wyolum/ClockTHREEjr/KiCAD/C3Jr_v2/c3jr_v2_BoM.pdf

BoM, for kit building assembly

ref | value | Vendor | Vendor P/N | NOTE1 | NOTE 2
BT1 | BATT_RTC | | 3003K-ND | | Battery Socket
* | 3V CR2032 Battery | | P189-ND | | LR2032 Coin Battery
C1,C2,C8 | 100u | | P833-ND | | Capacitor Voltage Rating >= 16V
C3,C4,C5,C6,C7,C9,C10 | 100n | | 399-5863-ND | | Decoupling capacitor
D1 to D128 | LED | | C535A-WJN-CU0V0231-ND | | CREE LED 5mm Cool White Clear 110deg
D258 | DBG | | 1080-1134-ND | | Debug LED, 3mm or 5mm LED, any Color
D260 | PWR | | 1080-1134-ND | | Power On LED, 3mm or 5mm LED, any Color
J1 | V_IN | | H2960CT-ND | | USB-Mini Socket
K1 | PWR | | SAM1031-50-ND | | Header, Male, 3 pin, for PWR_SEL
* | | | S9341-ND | | Jumper socket for PWR_SEL K1
K2 | LED_ENABLE | | SAM1031-50-ND | | Header, Male, 3 pin, for LED_ENABLE
* | | | S9341-ND | | Jumper socket for LED_ENABLE K2
K4 | SCL | | SAM1031-50-ND | | Header, Male, 2 pin, Link for INT, OPEN for EXT
* | | | S9341-ND | | Jumper socket for SCL, K4
K5 | SDA | | SAM1031-50-ND | | Header, Male, 2 pin, Link for INT, OPEN for EXT
* | | | S9341-ND | | Jumper socket for SDL, K5
P7 | FTDI | | SAM1031-50-ND | | Header, Male, 6 pin, for FTDI
Q1 to Q17 | 2N5401 | | 2N5401GOS-ND | | Transistor, TO-92-3
R1 to R16 | 100 | | CF18JT100RCT-ND | | Resistor, 1/8W, 5%
R17,R18,R19,R22,R23,R31,R36,R37,R38 10k | CF18JT10K0CT-ND | Resistor, 1/8W, 5%
R20,R21 | 4k7 | | CF18JT4K70CT-ND | | Resistor, 1/8W, 5%
R24,R25,R26 | 1k | | CF18JT1K00CT-ND | | Resistor, 1/8W, 5%
R30 | 100E | | CF18JT100RCT-ND | | Resistor, 1/8W, 5%
R32 | LDR SOCKET | | A32932-ND | | Socket header, 2 pin, for LDR
-- | LDR | | PDV-P9007-ND | | LDR, 10k to 100k
R33,R35 | 680E | | CF18JT680RCT-ND | | Resistor, 1/8W, 5%
R34 | 2k | | 3352T-202LF-ND | | Pot, Thumbwheel, Ceramic,
SP1 | SPEAKER | | 102-1169-ND | | Audio Buzzer
SW12,SW22,SW32,SW52 | INC | | 450-1647-ND | | Push button switch, Long Button
SW42 | RST | | 450-1649-ND | | Push button switch, Short Button
U1 | STP8DP05 | | 497-6271-5-ND | | IC, Row Driver
* | Socket STP8DP05 | | A100206-ND | | Socket for IC U1
U2 | 7805 | -- | -- | | SHORTING LINK between VI and VO
U3 | ATMEGA8-P | | ATMEGA328-PU-ND | | Micro Controller
* | IC ATMEGA8-P | | A100210-ND | | Socket for IC U3
U4 | 74HC154 | | 568-1407-5-ND | | IC, Column Driver
* | IC 74HC154 | | 3M5479-ND | | Socket for IC U4

DigiKey (http://search.digikey.com/scripts/DkSearch/dksus.dll?x=0&y=0&lang=en&site=us&KeyWords=3003K-ND)
DigiKey (http://search.digikey.com/us/en/products/CR2032/P189-ND/31939)
DigiKey (http://search.digikey.com/us/en/products/ECE-A1CKA101/P833-ND/44757)
DigiKey (http://search.digikey.com/us/en/products/R82DC3100AA50J/399-5863-ND/2571298)
DigiKey (http://search.digikey.com/scripts/DkSearch/dksus.dll?WT.z_header=search_go&lang=en&site=us&x=0&y=0)
DigiKey
DigiKey (http://search.digikey.com/us/en/products/MV8112/1080-1134-ND/2675625)
DigiKey (http://search.digikey.com/us/en/products/UX60-MB-5S8/H2960CT-ND/597539)
DigiKey (http://search.digikey.com/us/en/products/TSW-150-07-L-S/SAM1031-50-ND/1101377)
DigiKey (http://search.digikey.com/us/en/products/NPC02SXON-RC/S9341-ND/2618266)
DigiKey (http://search.digikey.com/us/en/products/TSW-150-07-L-S/SAM1031-50-ND/1101377)
DigiKey (http://search.digikey.com/us/en/products/NPC02SXON-RC/S9341-ND/2618266)
DigiKey (http://search.digikey.com/us/en/products/TSW-150-07-L-S/SAM1031-50-ND/1101377)
DigiKey (http://search.digikey.com/us/en/products/NPC02SXON-RC/S9341-ND/2618266)
DigiKey (http://search.digikey.com/us/en/products/TSW-150-07-L-S/SAM1031-50-ND/1101377)
DigiKey (http://search.digikey.com/us/en/products/NPC02SXON-RC/S9341-ND/2618266)
DigiKey (http://search.digikey.com/us/en/products/TSW-150-07-L-S/SAM1031-50-ND/1101377)
DigiKey (http://search.digikey.com/us/en/products/2N5401G/2N5401GOS-ND/1475210)
DigiKey (http://search.digikey.com/us/en/products/CF18JT100R/CF18JT100RCT-ND/2022718)
DigiKey (http://search.digikey.com/us/en/products/CF18JT10K0/CF18JT10K0CT-ND/2022766)
DigiKey (http://search.digikey.com/us/en/products/CF18JT4K70/CF18JT4K70CT-ND/2022758)
DigiKey (http://search.digikey.com/us/en/products/CF18JT1K00/CF18JT1K00CT-ND/2022742)
DigiKey (http://search.digikey.com/us/en/products/CF18JT100R/CF18JT100RCT-ND/2022718)
DigiKey (http://search.digikey.com/us/en/products/5-534206-1/A32932-ND/1093003)
DigiKey (http://search.digikey.com/us/en/products/PDV-P9007/PDV-P9007-ND/480624)
DigiKey (http://search.digikey.com/us/en/products/CF18JT680R/CF18JT680RCT-ND/2022738)
DigiKey (http://search.digikey.com/us/en/products/3352T-1-202LF/3352T-202LF-ND/1088345)
DigiKey (http://search.digikey.com/scripts/dksearch/dksus.dll?vendor=0&keywords=102-1169-ND)
DigiKey (http://search.digikey.com/scripts/DkSearch/dksus.dll?x=23&y=19&lang=en&site=us&KeyWords=450-1647-ND)
DigiKey (http://search.digikey.com/us/en/products/FSM2JH/450-1649-ND/1632535)
DigiKey (http://search.digikey.com/us/en/products/STP08DP05B1/497-6271-5-ND/1641765)
DigiKey (http://search.digikey.com/us/en/products/1-390261-4/A100206-ND/1125624)

DigiKey (http://search.digikey.com/us/en/products/ATMEGA328-PU/ATMEGA328-PU-ND/2271026)
DigiKey (http://search.digikey.com/us/en/products/1-390261-9/A100210-ND/990628)
DigiKey (http://search.digikey.com/us/en/products/74HC154N,652/568-1407-5-ND/763011)
DigiKey (http://search.digikey.com/us/en/products/4824-6004-CP/3M5479-ND/1133632)

BoM, for kit building assembly

ref | value | Vendor | Vendor P/N | NOTE1 | NOTE 2
U6 | DS3231N | | DS3231S#-ND | | IC, RTC
X1 | 16MHz | | X908-ND | | Resonator, with capacitors, 3 pin

NOT USED COMPONENTS
C11,C12 | 22p | BC1034CT-ND | Optional if using crystal instead of resonator
CD1,CD2,CD3 | CDOT1 | 3M9515-ND | Optional if using I2SD, rtcBoB or ChronoDot, Socket, 4 pin
DIL-U1 | STP16DP05 | 3M5479-ND | Optional if using rowBoB, 24 pin IC socket
J2 | V_IN | ED2982-ND | Optional USB-B, Socket
J3 | V_IN | CP-002B-ND | Optional Barrel socket
K3 | 7Seg_Sel | -- | -- | Optional Solder Bridge for uC pin selection
P1 | 7SegDisp | COM-09766 | Optional 7 segment 4 digit display
P13 | ISP | SAM1095-36-ND | Optional Header, 3x2 pin
P41 | STACK-L | SAM1009-50-ND | Optional Socket, 4 pin, right angle, for daisy-chaining boards
P42 | STACK-R | SAM1043-50-ND | Optional Header, 4 pin, right angle, for daisy-chaining boards
P43 | CONN_1 | -- | Break Out Pad, no component | Optional ATMega Port PC2
SW1,SW2,SW3,SW4,SW5 | INC | 450-1657-ND | Optional Right Angle switch, for Top access
U2 | 7805 | MC7805CTGOS-ND | Optional ONLY if V_IN > 5V. ELSE USE SHORTING LINK

MISC. COMPONENTS
BF1 | BAFFLE | | | | Angus Hines
BP1 | BackPlate | | | | Angus Hines
FM1 | FRAME | | | | Ikea or None
FP1 | FacePlate | | | | Angus Hines
P8,P9,P10,P11 | CONN_1 | | P/N 92855A313 | | Fixing Screw for Board
P14,P15,P53,P54 | CONN_1 | | P/N 92855A313 | | Fixing Screw for Baffle
P49,P40,P51,P52 | CONN_1 | | | | Fixing Screw for rtcBoB
rowBoB1 | CONN_1 | | | | Fixing Screw for rowBoB
P24 to P39 | DIL6 | | | | Prototyping area
PCB1 | PCB | | | | Main Board, seeed
Nuts, M3 | -- | | P/N 91828A211
StandOff's/Spacers, 20mm x M3 | -- | Local | | | (from Anool)

DigiKey (http://search.digikey.com/us/en/products/DS3231S/DS3231S#-ND/1197574)
DigiKey (http://search.digikey.com/us/en/products/ZTT-16.00MX/X908-ND/170095)

DigiKey (http://search.digikey.com/us/en/products/K220J15C0GF5TH5/BC1034CT-ND/286656)
DigiKey (http://search.digikey.com/us/en/products/960104-6202-AR/3M9515-ND/2071556)
DigiKey (http://search.digikey.com/us/en/products/4824-6004-CP/3M5479-ND/1133632)
DigiKey (http://search.digikey.com/us/en/products/USB-B1HSW6/ED2982-ND/2677743)
DigiKey (http://search.digikey.com/us/en/products/PJ-002B/CP-002B-ND/96965)

Sparkfun (http://www.sparkfun.com/products/9766)
DigiKey (http://search.digikey.com/us/en/products/TLW-136-05-T-D/SAM1095-36-ND/1104872)
DigiKey (http://search.digikey.com/us/en/products/BCS-150-L-S-HE/SAM1009-50-ND/1100271)
DigiKey (http://search.digikey.com/us/en/products/TSW-150-08-L-S-RA/SAM1043-50-ND/1101974)

DigiKey (http://search.digikey.com/us/en/products/FSMRA3JH/450-1657-ND/1632543)
DigiKey (http://search.digikey.com/us/en/products/MC7805CTG/MC7805CTGOS-ND/919333)

McMaster
McMaster (http://www.mcmaster.com/#92855A313)

McMaster (http://www.mcmaster.com/#91828A211)
