wyolum/ClockTHREEjr/KiCAD/C3Jr_v2/C3Jr_v2_images/c3jr_mod.pdf

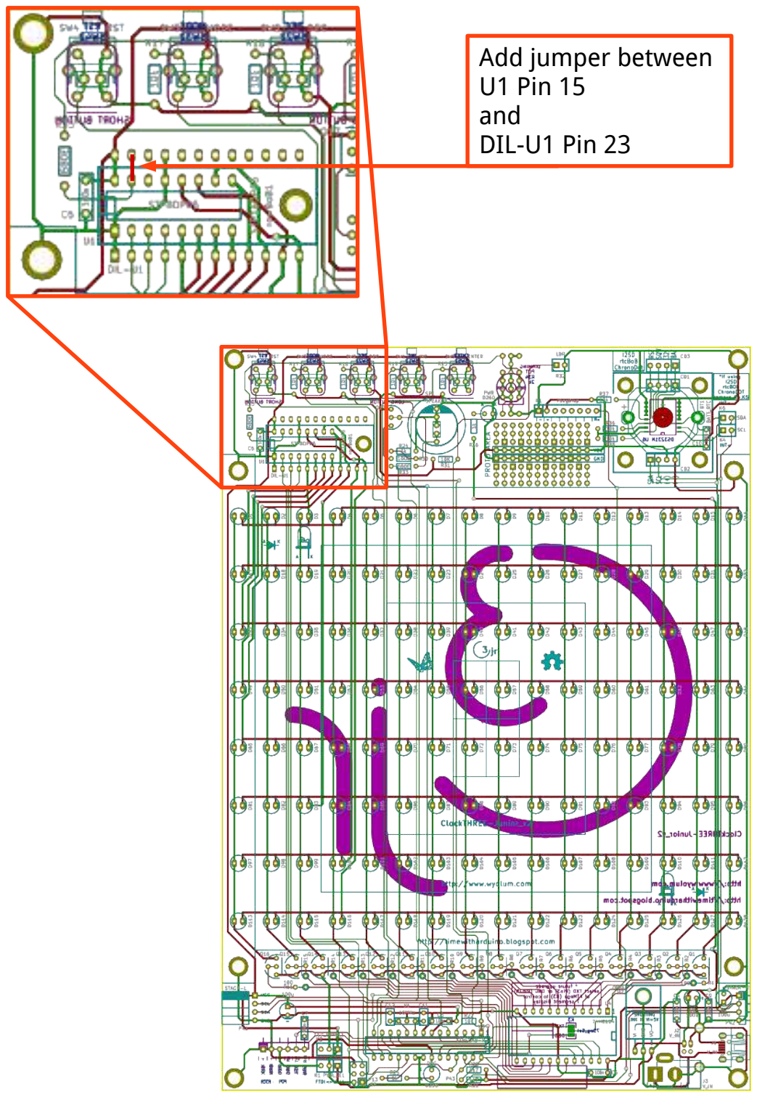
[picture p3: page 1]

Add jumper between
U1 Pin 15
and
DIL-U1 Pin 23
