wyolum/ClockTHREEjr/KiCAD/C3Jr_v2/C3Jr_v2_Data/c3jr_v2_LED.png

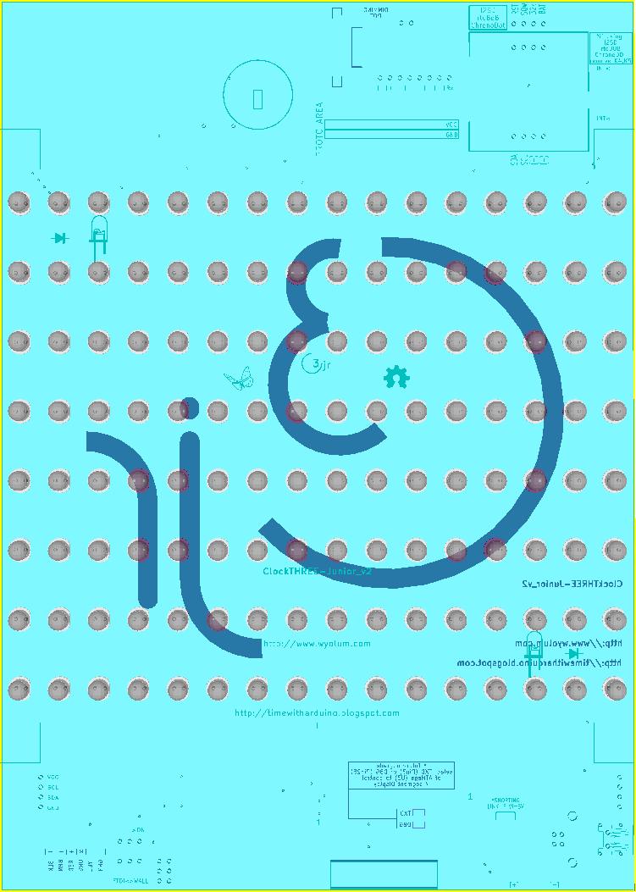
KiCAD/C3Jr_v2/C3Jr_v2_Data/c3jr_v2_LED.png
