wyolum/ClockTHREEjr/KiCAD/C3Jr_v2/C3Jr_v2_Data/C3jr_v2_Mech03.jpg

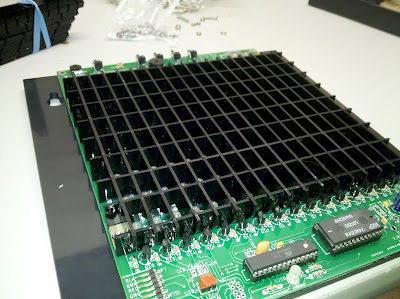
KiCAD/C3Jr_v2/C3Jr_v2_Data/C3jr_v2_Mech03.jpg
