wyolum/ClockTHREEjr/KiCAD/C3Jr_v2/C3Jr_v2_Data/Part-Dim_Pot.jpg

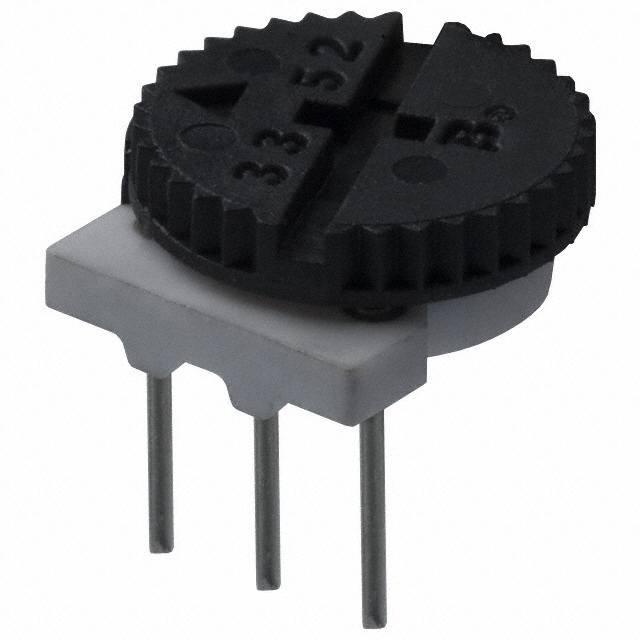
KiCAD/C3Jr_v2/C3Jr_v2_Data/Part-Dim_Pot.jpg
