wyolum/ClockTHREEjr/KiCAD/C3Jr_v2/C3Jr_v2_Data/Part-El_Cap_Radial.png

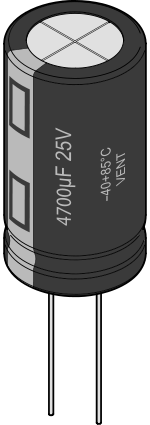
KiCAD/C3Jr_v2/C3Jr_v2_Data/Part-El_Cap_Radial.png
