wyolum/ClockTHREEjr/KiCAD/C3Jr_v2/C3Jr_v2_Data/Part-header_2_m.jpg

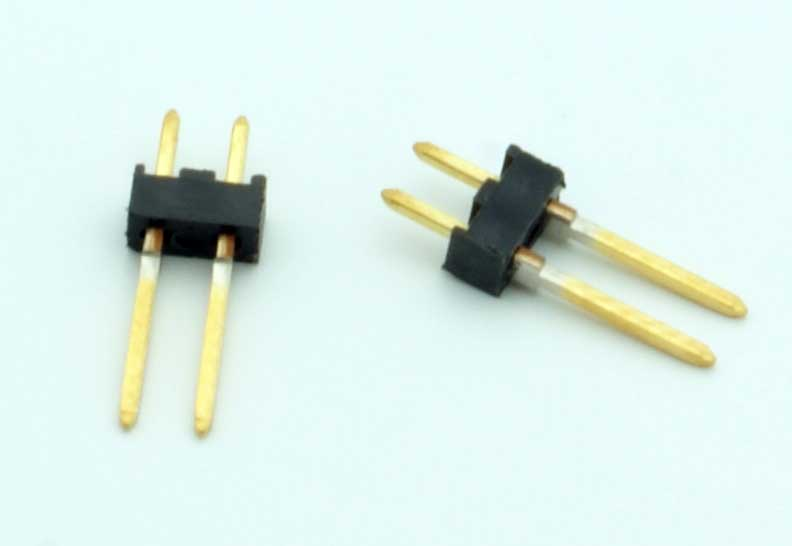
KiCAD/C3Jr_v2/C3Jr_v2_Data/Part-header_2_m.jpg
