wyolum/ClockTHREEjr/KiCAD/C3Jr_v2/C3Jr_v2_Data/Part-header_3x2_m.jpg

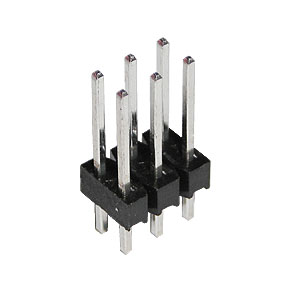
KiCAD/C3Jr_v2/C3Jr_v2_Data/Part-header_3x2_m.jpg
