wyolum/ClockTHREEjr/KiCAD/C3Jr_v2/C3Jr_v2_Data/Part-IC_74HC125.jpg

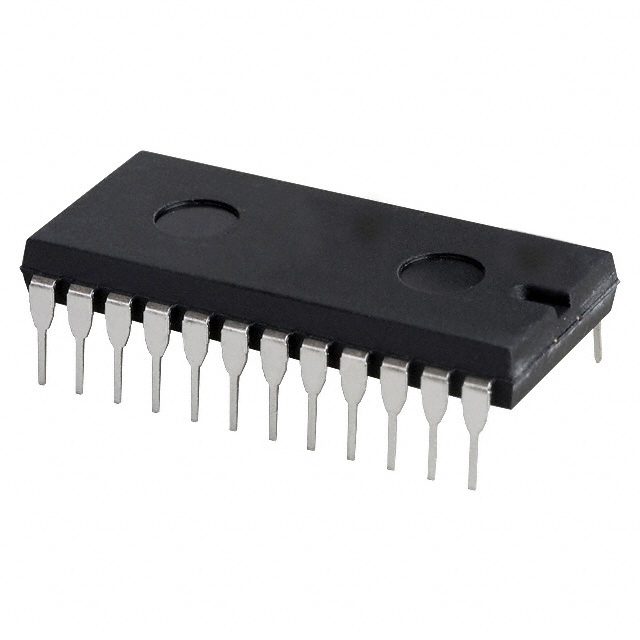
KiCAD/C3Jr_v2/C3Jr_v2_Data/Part-IC_74HC125.jpg
