wyolum/ClockTHREEjr/KiCAD/C3Jr_v2/C3Jr_v2_Data/Part-IC_Socket_16x300.jpg

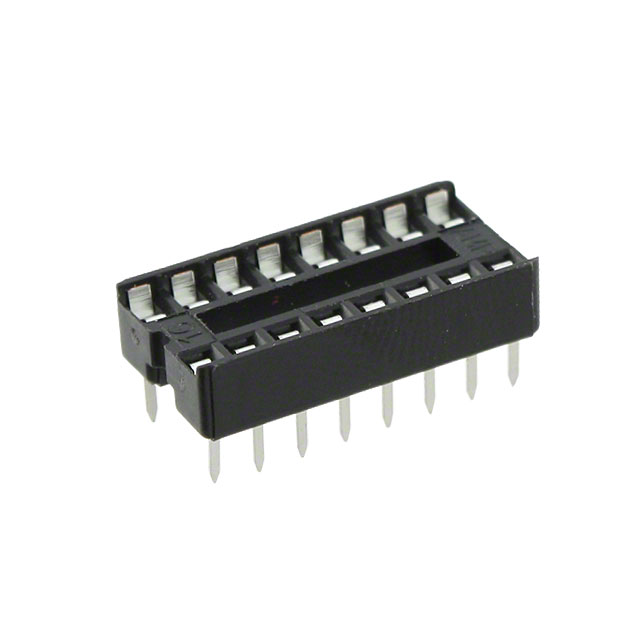
KiCAD/C3Jr_v2/C3Jr_v2_Data/Part-IC_Socket_16x300.jpg
