wyolum/ClockTHREEjr/KiCAD/C3Jr_v2/C3Jr_v2_Data/Part-IC_Socket_24x600.jpg

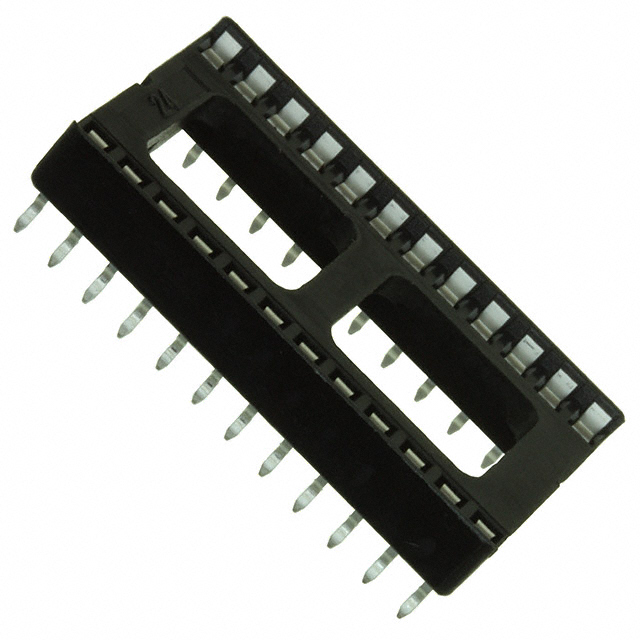
KiCAD/C3Jr_v2/C3Jr_v2_Data/Part-IC_Socket_24x600.jpg
