wyolum/ClockTHREEjr/KiCAD/C3Jr_v2/C3Jr_v2_Data/Part-IC_STP6DP05.jpg

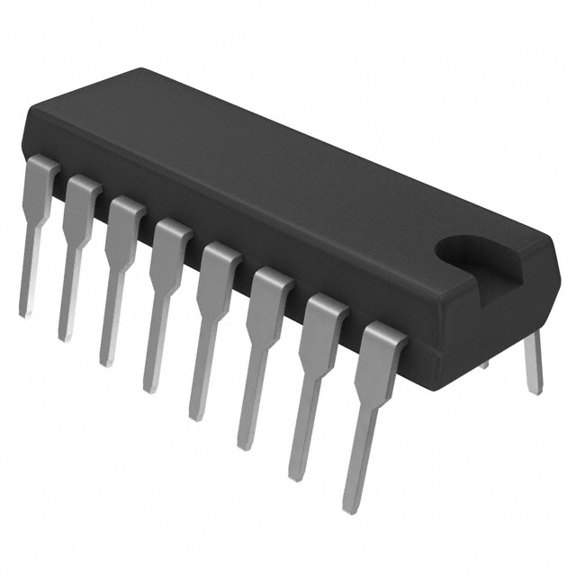
KiCAD/C3Jr_v2/C3Jr_v2_Data/Part-IC_STP6DP05.jpg
