wyolum/ClockTHREEjr/KiCAD/C3Jr_v2/C3Jr_v2_Data/Part-resistor_vert.jpg

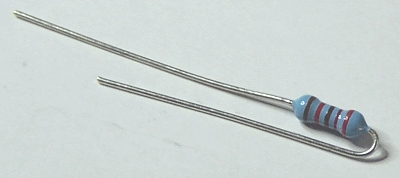
KiCAD/C3Jr_v2/C3Jr_v2_Data/Part-resistor_vert.jpg
