wyolum/ClockTHREEjr/KiCAD/C3Jr_v2/C3Jr_v2_Data/Part-Speaker.jpg

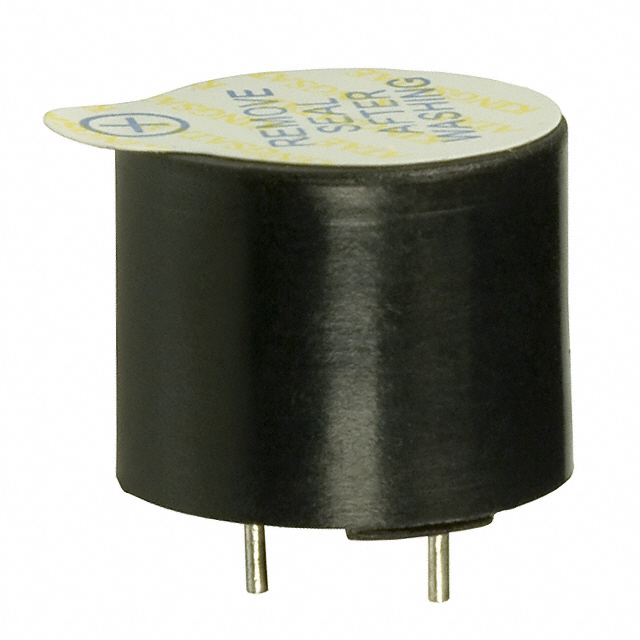
KiCAD/C3Jr_v2/C3Jr_v2_Data/Part-Speaker.jpg
