wyolum/ClockTHREEjr/KiCAD/C3Jr_v2/C3Jr_v2_Data/Part-Tr_2N5401.jpg

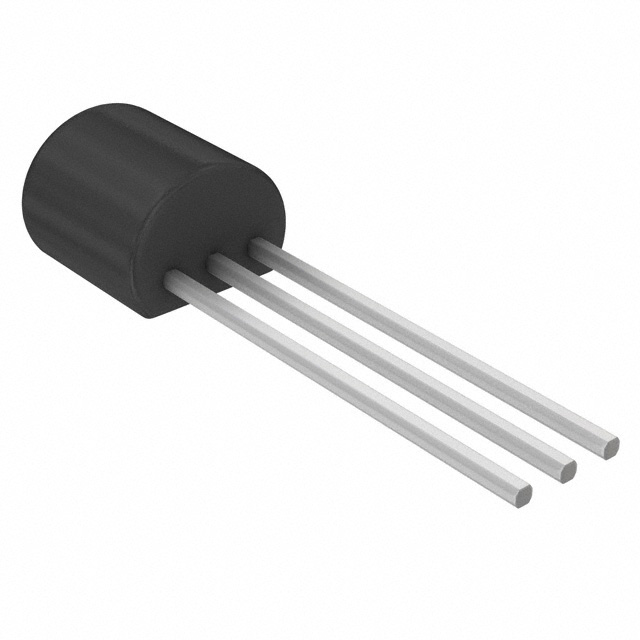
KiCAD/C3Jr_v2/C3Jr_v2_Data/Part-Tr_2N5401.jpg
