wyolum/ClockTHREEjr/KiCAD/C3Jr_v2/C3Jr_v2_images/c3jr-01.png

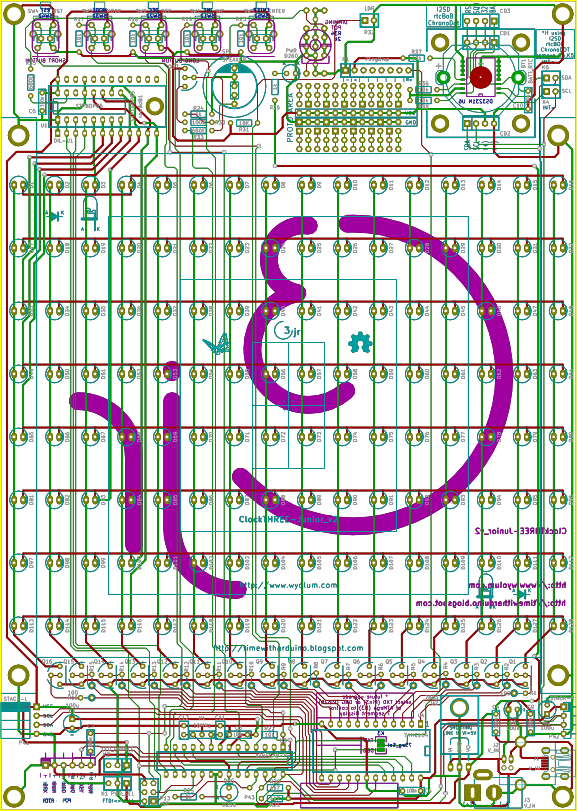
KiCAD/C3Jr_v2/C3Jr_v2_images/c3jr-01.png
