wyolum/ClockTHREEjr/KiCAD/C3Jr_v2/C3Jr_v2_PCB-SilkFrnt.png

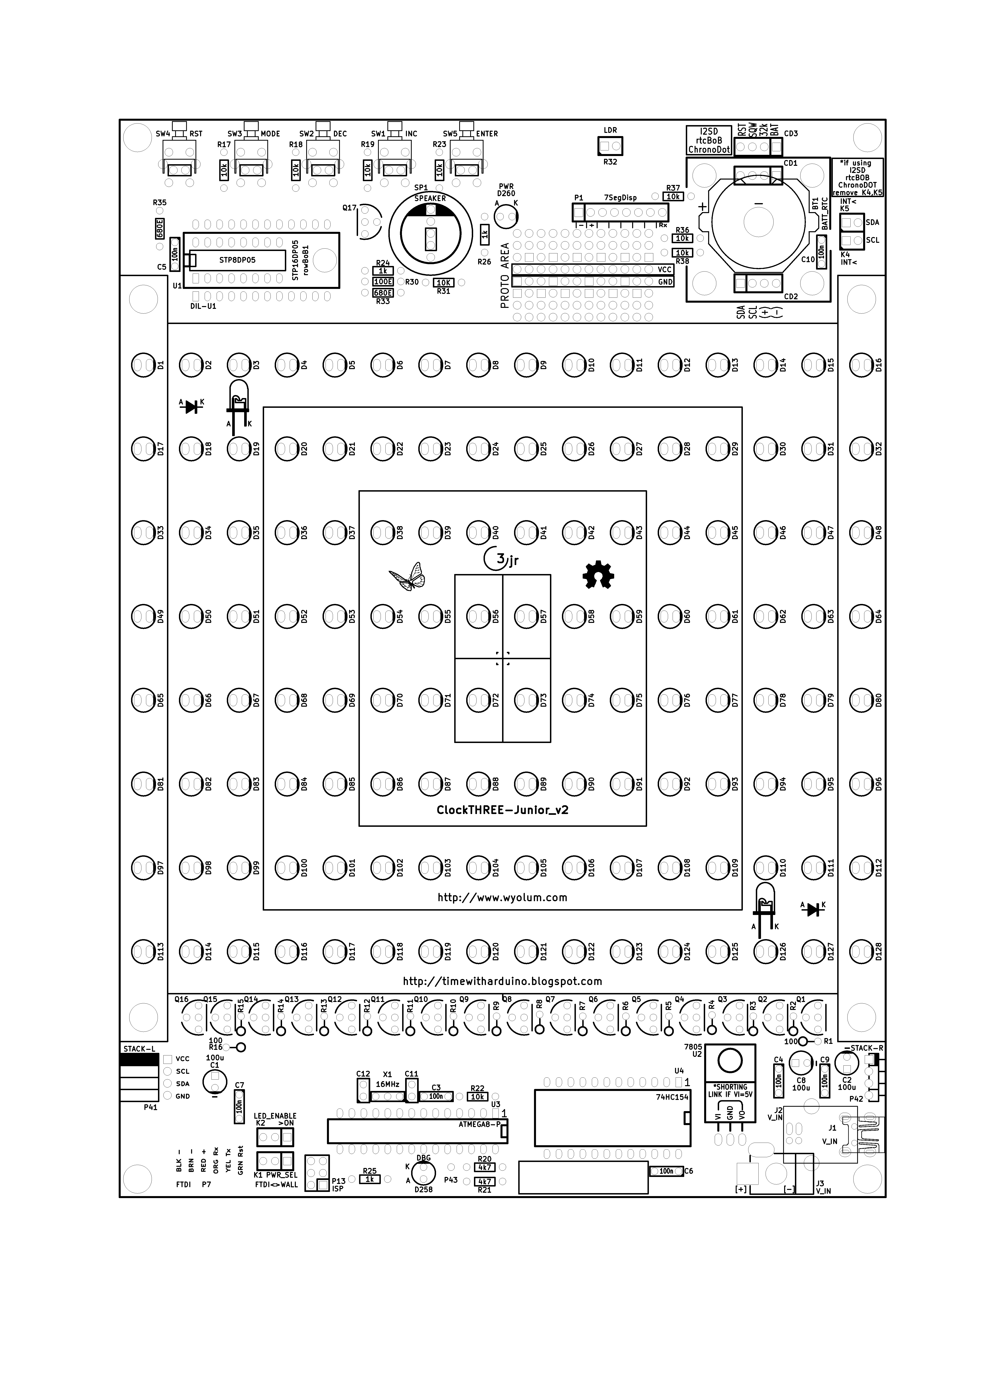
KiCAD/C3Jr_v2/C3Jr_v2_PCB-SilkFrnt.png
