wyolum/ClockTHREEjr/KiCAD/SO24toDIP/SO24toDIP_images/SO24toDIP_02.png

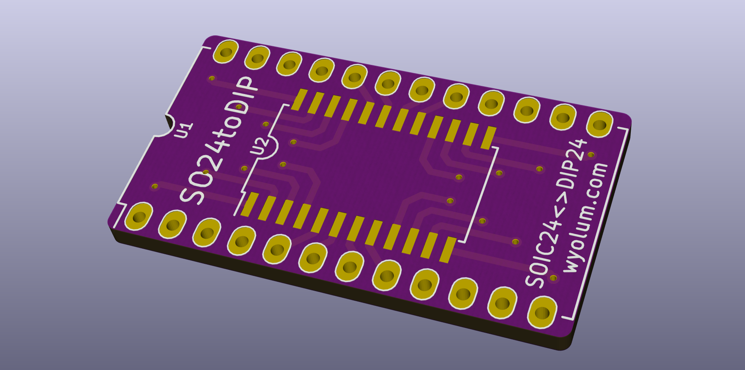
KiCAD/SO24toDIP/SO24toDIP_images/SO24toDIP_02.png
