wyolum/ClockTHREEjr/KiCAD/SO24toDIP/SO24toDIP_images/SO24toDIP_03.png

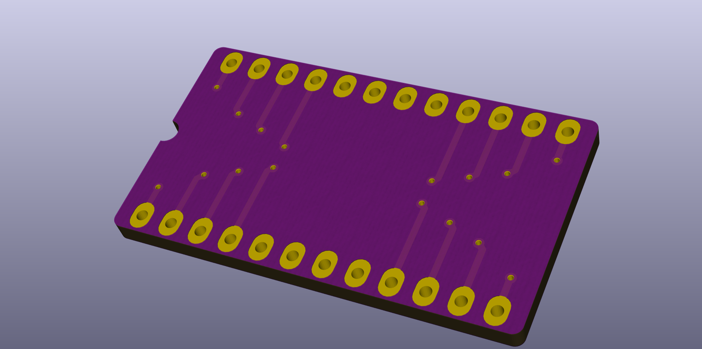
KiCAD/SO24toDIP/SO24toDIP_images/SO24toDIP_03.png
