wyolum/ClockTHREEjr/KiCAD/C3Jr_v2/C3Jr_v2_Data/c3jr_v2_BoM_UserGuide.ods

Sheet: BoM_SCH
BoM generated from KiCad Schematic
 | ref | value | footprint
1 | BF1 | BAFFLE | Baffle
2 | BP1 | BackPlate | BackPlate
3 | BT1 | BATT_RTC | CR2032
4 | C1 | 100u | CP_5x11mm
5 | C2 | 100u | CP_5x11mm
6 | C3 | 100n | C2
7 | C4 | 100n | C2
8 | C5 | 100n | C2
9 | C6 | 100n | C2
10 | C7 | 100n | C2
11 | C8 | 100u | CP_5x11mm
12 | C9 | 100n | C2
13 | C10 | 100n | C2
14 | C11 | 22p | cnp_3mm_disc
15 | C12 | 22p | cnp_3mm_disc
16 | CD1 | CDOT1 | pin_strip_4
17 | CD2 | CDOT2 | pin_strip_4
18 | CD3 | CDOT3 | pin_strip_4
19 | D1 | LED | led_5mm_clear
20 | D2 | LED | led_5mm_clear
21 | D3 | LED | led_5mm_clear
22 | D4 | LED | led_5mm_clear
23 | D5 | LED | led_5mm_clear
24 | D6 | LED | led_5mm_clear
25 | D7 | LED | led_5mm_clear
26 | D8 | LED | led_5mm_clear
27 | D9 | LED | led_5mm_clear
28 | D10 | LED | led_5mm_clear
29 | D11 | LED | led_5mm_clear
30 | D12 | LED | led_5mm_clear
31 | D13 | LED | led_5mm_clear
32 | D14 | LED | led_5mm_clear
33 | D15 | LED | led_5mm_clear
34 | D16 | LED | led_5mm_clear
35 | D17 | LED | led_5mm_clear
36 | D18 | LED | led_5mm_clear
37 | D19 | LED | led_5mm_clear
38 | D20 | LED | led_5mm_clear
39 | D21 | LED | led_5mm_clear
40 | D22 | LED | led_5mm_clear
41 | D23 | LED | led_5mm_clear
42 | D24 | LED | led_5mm_clear
43 | D25 | LED | led_5mm_clear
44 | D26 | LED | led_5mm_clear
45 | D27 | LED | led_5mm_clear
46 | D28 | LED | led_5mm_clear
47 | D29 | LED | led_5mm_clear
48 | D30 | LED | led_5mm_clear
49 | D31 | LED | led_5mm_clear
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
186 | P39 | DIL6 | PROTO-6
187 | P41 | STACK-L | pin_sck_4-90
188 | P42 | STACK-R | pin_strip_4-90
189 | P43 | CONN_1 | Pad01
190 | P49 | CONN_1 | vite_3mm
191 | P50 | CONN_1 | vite_3mm
192 | P51 | CONN_1 | vite_3mm
193 | P52 | CONN_1 | vite_3mm
194 | P53 | CONN_1 | vite_4mm
195 | P54 | CONN_1 | vite_4mm
196 | PCB1 | PCB | PCB
197 | Q1 | 2N5401 | to92_2N5401
198 | Q2 | 2N5401 | to92_2N5401
199 | Q3 | 2N5401 | to92_2N5401
200 | Q4 | 2N5401 | to92_2N5401
201 | Q5 | 2N5401 | to92_2N5401
202 | Q6 | 2N5401 | to92_2N5401
203 | Q7 | 2N5401 | to92_2N5401
204 | Q8 | 2N5401 | to92_2N5401
205 | Q9 | 2N5401 | to92_2N5401
206 | Q10 | 2N5401 | to92_2N5401
207 | Q11 | 2N5401 | to92_2N5401
208 | Q12 | 2N5401 | to92_2N5401
209 | Q13 | 2N5401 | to92_2N5401
210 | Q14 | 2N5401 | to92_2N5401
211 | Q15 | 2N5401 | to92_2N5401
212 | Q16 | 2N5401 | to92_2N5401
213 | Q17 | 2N5401 | to92_2N5401
214 | R1 | 100 | rc03_vert_LED
215 | R2 | 100 | rc03_vert_LED
216 | R3 | 100 | rc03_vert_LED
217 | R4 | 100 | rc03_vert_LED
218 | R5 | 100 | rc03_vert_LED
219 | R6 | 100 | rc03_vert_LED
220 | R7 | 100 | rc03_vert_LED
221 | R8 | 100 | rc03_vert_LED
222 | R9 | 100 | rc03_vert_LED
223 | R10 | 100 | rc03_vert_LED
224 | R11 | 100 | rc03_vert_LED
225 | R12 | 100 | rc03_vert_LED
226 | R13 | 100 | rc03_vert_LED
227 | R14 | 100 | rc03_vert_LED
228 | R15 | 100 | rc03_vert_LED
229 | R16 | 100 | rc03_vert_LED
230 | R17 | 10k | RC03
231 | R18 | 10k | RC03
232 | R19 | 10k | RC03
233 | R20 | 4k7 | RC03
234 | R21 | 4k7 | RC03
235 | R22 | 10k | RC03
236 | R23 | 10k | RC03
237 | R24 | 1k | RC03
238 | R25 | 1k | RC03
239 | R26 | 1k | RC03
240 | R30 | 100E | RC03
241 | R31 | 10K | RC03
242 | R32 | LDR | pin_strip_2
243 | R33 | 680E | RC03
244 | R34 | 2k | Pot-Var2
245 | R35 | 680E | RC03
246 | R36 | 10k | RC03
247 | R37 | 10k | RC03
248 | R38 | 10k | RC03
249 | rowBoB1 | CONN_1 | vite_3mm
250 | SP1 | SPEAKER | Speaker
251 | SW1 | INC | SW_PB_V
252 | SW2 | DEC | SW_PB_V
253 | SW3 | MODE | SW_PB_V
254 | SW4 | RST | SW_PB_V
255 | SW5 | ENTER | SW_PB_V
256 | SW12 | INC | SW-PB-MOD
257 | SW22 | DEC | SW-PB-MOD
258 | SW32 | MODE | SW-PB-MOD
259 | SW42 | RST | SW-PB-MOD
260 | SW52 | ENTER | SW-PB-MOD
261 | U1 | STP8DP05 | dil_16-300_socket
262 | U2 | 7805 | TO-220_Horizontal
263 | U3 | ATMEGA8-P | dil_28-300_socket
264 | U4 | 74HC154 | DIP-24__600_ELL
265 | U6 | DS3231N | DS3231
266 | X1 | 16MHz | XTAL

Sheet: BoM_PCB
BoM generated from KiCad PCB
Id | Designator | Package | Quantity | Designation | Supplier and ref
1 | BF1 | Baffle | 1 | BAFFLE
2 | BP1 | BackPlate | 1 | BackPlate
3 | BT1 | CR2032 | 1 | BATT_RTC
4 | C3, C4, C5, C6, C7, C9, C10 | C2 | 7 | 100n
5 | C11, C12 | cnp_3mm_disc | 2 | 22p
6 | C1, C2, C8 | CP_5x11mm | 3 | 100u
7 | CD1 | pin_strip_4 | 1 | CDOT1
8 | CD2 | pin_strip_4 | 1 | CDOT2
9 | CD3 | pin_strip_4 | 1 | CDOT3
10 | D258 | led_5mm_blue | 1 | DBG
11 | D260 | led_5mm_blue | 1 | PWR
12 | D1 to D128 | led_5mm_clear | 128 | LED
13 | DIL-U1 | SCK-24_600_ELL | 1 | STP16DP05
14 | FM1 | Frame | 1 | FRAME
15 | FP1 | FacePlate | 1 | FacePlate
16 | G1 | Logo-WL3 | 1 | Logo-WL3
17 | G2 | OSHW_6mm | 1 | LOGO
18 | J1 | con-hirose-UX60-MB-5S8 | 1 | V_IN
19 | J2 | con-usb-USB-B-H | 1 | V_IN
20 | J3 | JACK_ALIM | 1 | V_IN
21 | K1 | pin_strip_3 | 1 | PWR_SEL
22 | K2 | pin_strip_3 | 1 | LED_ENABLE
23 | K3 | 7Seg_Sel | 1 | 7Seg_Sel
24 | K4 | pin_strip_2 | 1 | SCL
25 | K5 | pin_strip_2 | 1 | SDA
26 | P1 | pin_strip_8 | 1 | 7SegDisp
27 | P13 | pin_strip_3x2 | 1 | ISP
28 | P24 to P39 | PROTO-6 | 16 | DIL6
29 | P41 | pin_sck_4-90 | 1 | STACK-L
30 | P42 | pin_strip_4-90 | 1 | STACK-R
31 | P43 | Pad01 | 1 | CONN_1
32 | P8, P9, P10, P11, P14, P15, P53, P54 | vite_4mm | 8 | CONN_1
33 | P7 | pin_strip_6-90 | 1 | FTDI
34 | PCB1 | PCB | 1 | PCB
35 | Q1 to Q17 | to92_2N5401 | 17 | 2N5401
36 | R1 to R16 | rc03_vert_LED | 16 | 100
37 | R20, R21 | RC03 | 2 | 4k7
38 | R17, R18, R19, R22, R23, R36, R37, R38 | RC03 | 8 | 10k
39 | R24, R25, R26 | RC03 | 3 | 1k
40 | R30 | RC03 | 1 | 100E
41 | R31 | RC03 | 1 | 10K
42 | R32 | pin_strip_2 | 1 | LDR
43 | R33,R35 | RC03 | 2 | 680E
44 | R34 | Pot-Var2 | 1 | 2k
45 | rowBoB1, P49, P50, P51, P52 | vite_3mm | 5 | CONN_1
46 | SP1 | Speaker | 1 | SPEAKER
47 | SW1 | SW_PB_V | 1 | INC
48 | SW12 | SW-PB-MOD | 1 | INC
49 | SW2 | SW_PB_V | 1 | DEC
50 | SW22 | SW-PB-MOD | 1 | DEC
51 | SW3 | SW_PB_V | 1 | MODE
52 | SW32 | SW-PB-MOD | 1 | MODE
53 | SW4 | SW_PB_V | 1 | RST
54 | SW42 | SW-PB-MOD | 1 | RST
55 | SW5 | SW_PB_V | 1 | ENTER
56 | SW52 | SW-PB-MOD | 1 | ENTER
57 | U1 | dil_16-300_socket | 1 | STP8DP05
58 | U2 | TO-220_Horizontal | 1 | 7805
59 | U3 | dil_28-300_socket | 1 | ATMEGA8-P
60 | U4 | DIP-24__600_ELL | 1 | 74HC154
61 | U6 | DS3231 | 1 | DS3231N
62 | X1 | XTAL | 1 | 16MHz
 |  |  | 266

Sheet: BoM_Assy
BoM, for kit building assembly
 |  |  |  |  |  |  | WORST CASE PRICES (unit qty. 1)
ref | value | Vendor | Vendor P/N | NOTE1 | NOTE 2 | MODULE | QTY | RATE | AMOUNT
BT1 | BATT_RTC | DigiKey (http://search.digikey.com/scripts/DkSearch/dksus.dll?x=0&y=0&lang=en&site=us&KeyWords=3003K-ND) | 3003K-ND |  | Battery Socket | CR2032 | 1 | $0.59 | $0.59
* | 3V CR2032 Battery | DigiKey (http://search.digikey.com/us/en/products/CR2032/P189-ND/31939) | P189-ND |  | LR2032 Coin Battery | -- | 1 | $0.28 | $0.28
C1,C2,C8 | 100u | DigiKey (http://search.digikey.com/us/en/products/ECE-A1CKA101/P833-ND/44757) | P833-ND |  | Capacitor Voltage Rating >= 16V | CP_5x11mm | 3 | $0.25 | $0.75
C3,C4,C5,C6,C7,C9,C10 | 100n | DigiKey (http://search.digikey.com/us/en/products/R82DC3100AA50J/399-5863-ND/2571298) | 399-5863-ND |  | Decoupling capacitor | C2 | 7 | $0.22 | $1.54
D1 to D128 | LED | DigiKey (http://search.digikey.com/scripts/DkSearch/dksus.dll?WT.z_header=search_go&lang=en&site=us&x=0&y=0) | C535A-WJN-CU0V0231-ND |  | CREE LED 5mm Cool White Clear 110deg | led_5mm_clear | 128 | $0.20 | $25.60
D258 | DBG | DigiKey (http://search.digikey.com/us/en/products/MV8112/1080-1134-ND/2675625) | 1080-1134-ND |  | Debug LED, 3mm or 5mm LED, any Color | led_5mm_blue | 1 | $0.41 | $0.41
D260 | PWR | DigiKey (http://search.digikey.com/us/en/products/MV8112/1080-1134-ND/2675625) | 1080-1134-ND |  | Power On LED, 3mm or 5mm LED, any Color | led_5mm_blue | 1 | $0.41 | $0.41
J1 | V_IN | DigiKey (http://search.digikey.com/us/en/products/UX60-MB-5S8/H2960CT-ND/597539) | H2960CT-ND |  | USB-Mini Socket | con-hirose-UX60-MB-5S8 | 1 | $1.25 | $1.25
K1 | PWR | DigiKey (http://search.digikey.com/us/en/products/TSW-150-07-L-S/SAM1031-50-ND/1101377) | SAM1031-50-ND |  | Header, Male, 3 pin, for PWR_SEL | SEL | 1 | $0.19 | $0.19
* |  | DigiKey (http://search.digikey.com/us/en/products/NPC02SXON-RC/S9341-ND/2618266) | S9341-ND |  | Jumper socket for PWR_SEL K1 | -- | 1 | $0.19 | $0.19
K2 | LED_ENABLE | DigiKey (http://search.digikey.com/us/en/products/TSW-150-07-L-S/SAM1031-50-ND/1101377) | SAM1031-50-ND |  | Header, Male, 3 pin, for LED_ENABLE | pin_strip_3 | 1 | $0.19 | $0.19
* |  | DigiKey (http://search.digikey.com/us/en/products/NPC02SXON-RC/S9341-ND/2618266) | S9341-ND |  | Jumper socket for LED_ENABLE K2 | -- | 1 | $0.19 | $0.19
K4 | SCL | DigiKey (http://search.digikey.com/us/en/products/TSW-150-07-L-S/SAM1031-50-ND/1101377) | SAM1031-50-ND |  | Header, Male, 2 pin, Link for INT, OPEN for EXT | pin_strip_2 | 1 | $0.12 | $0.12
* |  | DigiKey (http://search.digikey.com/us/en/products/NPC02SXON-RC/S9341-ND/2618266) | S9341-ND |  | Jumper socket for SCL, K4 | -- | 1 | $0.19 | $0.19
K5 | SDA | DigiKey (http://search.digikey.com/us/en/products/TSW-150-07-L-S/SAM1031-50-ND/1101377) | SAM1031-50-ND |  | Header, Male, 2 pin, Link for INT, OPEN for EXT | pin_strip_2 | 1 | $0.12 | $0.12
* |  | DigiKey (http://search.digikey.com/us/en/products/NPC02SXON-RC/S9341-ND/2618266) | S9341-ND |  | Jumper socket for SDL, K5 | -- | 1 | $0.19 | $0.19
P7 | FTDI | DigiKey (http://search.digikey.com/us/en/products/TSW-150-07-L-S/SAM1031-50-ND/1101377) | SAM1031-50-ND |  | Header, Male, 6 pin, for FTDI | pin_strip_6 | 1 | $0.37 | $0.37
Q1 to Q17 | 2N5401 | DigiKey (http://search.digikey.com/us/en/products/2N5401G/2N5401GOS-ND/1475210) | 2N5401GOS-ND |  | Transistor, TO-92-3 | to92_2N5401 | 17 | $0.54 | $9.18
R1 to R16 | 100 | DigiKey (http://search.digikey.com/us/en/products/CF18JT100R/CF18JT100RCT-ND/2022718) | CF18JT100RCT-ND |  | Resistor, 1/8W, 5% | rc03_vert_LED | 16 | $0.09 | $1.44
R17,R18,R19,R22,R23,R31,R36,R37,R38 | 10k | DigiKey (http://search.digikey.com/us/en/products/CF18JT10K0/CF18JT10K0CT-ND/2022766) | CF18JT10K0CT-ND |  | Resistor, 1/8W, 5% | RC03 | 9 | $0.09 | $0.81
R20,R21 | 4k7 | DigiKey (http://search.digikey.com/us/en/products/CF18JT4K70/CF18JT4K70CT-ND/2022758) | CF18JT4K70CT-ND |  | Resistor, 1/8W, 5% | RC03 | 2 | $0.09 | $0.18
R24,R25,R26 | 1k | DigiKey (http://search.digikey.com/us/en/products/CF18JT1K00/CF18JT1K00CT-ND/2022742) | CF18JT1K00CT-ND |  | Resistor, 1/8W, 5% | RC03 | 3 | $0.09 | $0.27
R30 | 100E | DigiKey (http://search.digikey.com/us/en/products/CF18JT100R/CF18JT100RCT-ND/2022718) | CF18JT100RCT-ND |  | Resistor, 1/8W, 5% | RC03 | 1 | $0.09 | $0.09
R32 | LDR SOCKET | DigiKey (http://search.digikey.com/us/en/products/5-534206-1/A32932-ND/1093003) | A32932-ND |  | Socket header, 2 pin, for LDR | pin_strip_2 | 1 | $1.07 | $1.07
-- | LDR | DigiKey (http://search.digikey.com/us/en/products/PDV-P9007/PDV-P9007-ND/480624) | PDV-P9007-ND |  | LDR, 10k to 100k | -- | 1 | $1.51 | $1.51
R33,R35 | 680E | DigiKey (http://search.digikey.com/us/en/products/CF18JT680R/CF18JT680RCT-ND/2022738) | CF18JT680RCT-ND |  | Resistor, 1/8W, 5% | RC03 | 2 | $0.09 | $0.18
R34 | 2k | DigiKey (http://search.digikey.com/us/en/products/3352T-1-202LF/3352T-202LF-ND/1088345) | 3352T-202LF-ND |  | Pot, Thumbwheel, Ceramic, | Pot-Var2 | 1 | $1.58 | $1.58
SP1 | SPEAKER | DigiKey (http://search.digikey.com/scripts/dksearch/dksus.dll?vendor=0&keywords=102-1169-ND) | 102-1169-ND |  | Audio Buzzer | Speaker | 1 | $1.68 | $1.68
SW12,SW22,SW32,SW52 | INC | DigiKey (http://search.digikey.com/scripts/DkSearch/dksus.dll?WT.z_header=search_go&lang=en&site=us&x=0&y=0) | 450-1644-ND |  | Push button switch, Long Button | SW-PB-MOD | 4 | $0.19 | $0.76
SW42 | RST | DigiKey (http://search.digikey.com/us/en/products/FSM2JH/450-1649-ND/1632535) | 450-1649-ND |  | Push button switch, Short Button | SW-PB-MOD | 1 | $0.20 | $0.20
U1 | STP8DP05 | DigiKey (http://search.digikey.com/us/en/products/STP08DP05B1/497-6271-5-ND/1641765) | 497-6271-5-ND |  | IC, Row Driver | dil_16-300_socket | 1 | $1.82 | $1.82
* | Socket STP8DP05 | DigiKey (http://search.digikey.com/us/en/products/1-390261-4/A100206-ND/1125624) | A100206-ND |  | Socket for IC U1 | -- | 1 | $0.24 | $0.24
U2 | 7805 | -- | -- |  | SHORTING LINK between VI and VO | TO-220_Horizontal | 1 | $0.00 | $0.00
U3 | ATMEGA8-P | DigiKey (http://search.digikey.com/us/en/products/ATMEGA328-PU/ATMEGA328-PU-ND/2271026) | ATMEGA328-PU-ND |  | Micro Controller | dil_28-300_socket | 1 | $3.93 | $3.93
* | IC ATMEGA8-P | DigiKey (http://search.digikey.com/us/en/products/1-390261-9/A100210-ND/990628) | A100210-ND |  | Socket for IC U3 | -- | 1 | $0.43 | $0.43
U4 | 74HC154 | DigiKey (http://search.digikey.com/us/en/products/74HC154N,652/568-1407-5-ND/763011) | 568-1407-5-ND |  | IC, Column Driver | DIP-24__600_ELL | 1 | $1.29 | $1.29
* | IC 74HC154 | DigiKey (http://search.digikey.com/us/en/products/4824-6004-CP/3M5479-ND/1133632) | 3M5479-ND |  | Socket for IC U4 | -- | 1 | $0.41 | $0.41
U6 | DS3231N | DigiKey (http://search.digikey.com/us/en/products/DS3231S/DS3231S#-ND/1197574) | DS3231S#-ND |  | IC, RTC | DS3231 | 1 | $7.94 | $7.94
X1 | 16MHz | DigiKey (http://search.digikey.com/us/en/products/ZTT-16.00MX/X908-ND/170095) | X908-ND |  | Resonator, with capacitors, 3 pin | XTAL | 1 | $0.70 | $0.70
 |  |  |  |  |  |  | 220 | $29.44 | $68.30
NOT USED COMPONENTS
C11,C12 | 22p | DigiKey (http://search.digikey.com/us/en/products/K220J15C0GF5TH5/BC1034CT-ND/286656) | BC1034CT-ND | Optional | if using crystal instead of resonator | cnp_3mm_disc | 2 | $0.34 | $0.68
CD1,CD2,CD3 | CDOT1 | DigiKey (http://search.digikey.com/us/en/products/960104-6202-AR/3M9515-ND/2071556) | 3M9515-ND | Optional | if using I2SD, rtcBoB or ChronoDot, Socket, 4 pin | pin_strip_4 | 3 | $0.75 | $2.25
DIL-U1 | STP16DP05 | DigiKey (http://search.digikey.com/us/en/products/4824-6004-CP/3M5479-ND/1133632) | 3M5479-ND | Optional | if using rowBoB, 24 pin IC socket | SCK-24_600_ELL | 1 | $0.41 | $0.41
J2 | V_IN | DigiKey (http://search.digikey.com/us/en/products/USB-B1HSW6/ED2982-ND/2677743) | ED2982-ND | Optional | USB-B, Socket | con-usb-USB-B-H | 1 | $0.54 | $0.54
J3 | V_IN | DigiKey (http://search.digikey.com/us/en/products/PJ-002B/CP-002B-ND/96965) | CP-002B-ND | Optional | Barrel socket | JACK_ALIM | 1 | $0.92 | $0.92
K3 | 7Seg_Sel | -- | -- | Optional | Solder Bridge for uC pin selection | 7Seg_Sel | 1 | $0.00 | $0.00
P1 | 7SegDisp | Sparkfun (http://www.sparkfun.com/products/9766) | COM-09766 | Optional | 7 segment 4 digit display | pin_strip_8 | 1 | $12.95 | $12.95
P13 | ISP | DigiKey (http://search.digikey.com/us/en/products/TLW-136-05-T-D/SAM1095-36-ND/1104872) | SAM1095-36-ND | Optional | Header, 3x2 pin | pin_strip_3x2 | 1 | $0.53 | $0.53
P41 | STACK-L | DigiKey (http://search.digikey.com/us/en/products/BCS-150-L-S-HE/SAM1009-50-ND/1100271) | SAM1009-50-ND | Optional | Socket, 4 pin, right angle, for daisy-chaining boards | pin_sck_4-90 | 1 | $0.78 | $0.78
P42 | STACK-R | DigiKey (http://search.digikey.com/us/en/products/TSW-150-08-L-S-RA/SAM1043-50-ND/1101974) | SAM1043-50-ND | Optional | Header, 4 pin, right angle, for daisy-chaining boards | pin_strip_4-90 | 1 | $0.28 | $0.28
P43 | CONN_1 | -- | Break Out Pad, no component | Optional | ATMega Port PC2 | Pad01 | 1 | $0.00 | $0.00
SW1,SW2,SW3,SW4,SW5 | INC | DigiKey (http://search.digikey.com/us/en/products/FSMRA3JH/450-1657-ND/1632543) | 450-1657-ND | Optional | Right Angle switch, for Top access | SW_PB_V | 5 | $0.20 | $1.00
U2 | 7805 | DigiKey (http://search.digikey.com/us/en/products/MC7805CTG/MC7805CTGOS-ND/919333) | MC7805CTGOS-ND | Optional | ONLY if V_IN > 5V. ELSE USE SHORTING LINK | TO-220_Horizontal | 1 | $0.53 | $0.53
 |  |  |  |  |  |  | 20 | $18.23 | $20.87
MISC. COMPONENTS
BF1 | BAFFLE |  |  |  | Angus Hines | Baffle | 1 | $30.00 | $30.00
BP1 | BackPlate |  |  |  | Angus Hines | BackPlate | 1 | $0.00 | $0.00
FM1 | FRAME |  |  |  | Ikea or None | Frame | 1 | $11.00 | $11.00
FP1 | FacePlate |  |  |  | Angus Hines | FacePlate | 1 | $0.00 | $0.00
P8,P9,P10,P11 | CONN_1 |  |  |  | Fixing Screw for Board | vite_4mm | 4 | $0.10 | $0.40
P14,P15,P53,P54 | CONN_1 |  |  |  | Fixing Screw for Baffle | vite_4mm | 4 | $0.10 | $0.40
P49,P40,P51,P52 | CONN_1 |  |  |  | Fixing Screw for rtcBoB | vite_4mm | 4 | $0.10 | $0.40
rowBoB1 | CONN_1 |  |  |  | Fixing Screw for rowBoB | vite_3mm | 1 | $0.00 | $0.00
P24 to P39 | DIL6 |  |  |  | Prototyping area | PROTO-6 | 16 | $0.00 | $0.00
PCB1 | PCB |  |  |  | Main Board, seeed | PCB | 1 | $17.86 | $17.86
 |  |  |  |  |  |  | 34 | $59.16 | $60.06
 |  |  |  |  | GRAND TOTAL |  |  |  | $128.36
