wyolum/ClockTHREEjr/KiCAD/C3Jr_v2/c3jr_v2_BoM_seeed.ods

Electronic Engineering BOM List
Product Name：WyoLum ClockTHREE-Junior : C3jr
Version：V2.0
Issue Date：06/Nov/2012
Item No. (序号) | Reference Des (上件位置) | Qty (用量) | Catalog (分类） | Part_Description (规格描述) | Part_Value （元件值） | Part_Package （元件封装） | Manufacturers Name (使用厂牌名称) | Manufacturers Part No. (使用厂牌型号) | Distributors Name （供应商名称） | Distributors Part No. (供貨商型号) | Unit Price （单价） | Price Break To Use （价格分段的购买量） | Notes/Remark （备注）
Example（填写范例）
1 | BT1 | 1 | OTHER | HOLDER BATTERY COIN 20MM DIA THM | -- | -- | Keystone Electronics | 3003 | Digikey | 3003K-ND |  |  | Link (http://www.digikey.com/scripts/DkSearch/dksus.dll?x=0&y=0&lang=en&KeyWords=3003K-ND&cur=USD)
2 | * | 1 | OTHER | BATTERY LITHIUM COIN 3V 20MM | 3V | CR2032 | Panasonic – BSG | CR2032 | Digikey | P189-ND |  |  | Link (http://www.digikey.com/product-detail/en/CR2032/P189-ND/31939?cur=USD)
3 | C1,C2,C8 | 3 | Capacitor | CAP ALUM 100UF 16V 20% RADIAL | 100uF, 16V | 6.3 x 7 | Panasonic Electronic Components | ECE-A1CKA101 | Digikey | P833-ND |  |  | Link (http://www.digikey.com/product-detail/en/ECE-A1CKA101/P833-ND/44757?cur=USD)
4 | C3,C4,C5,C6,C7,C9,C10 | 7 | Capacitor | CAP FILM 0.1UF 63VDC RADIAL | 100nF, 63V | 7.2 x 2.5 | Kemet | R82DC3100AA50J | Digikey | 399-5863-ND |  |  | Link (http://www.digikey.com/product-detail/en/R82DC3100AA50J/399-5863-ND/2571298?cur=USD)
5 | D1 to D128 , D258 | 129 | Diode | LED 5MM COOL WHITE CLEAR 110DEG | LED, Clear | 5mm | Cree Inc | C535A-WJN-CU0V0231 | Digikey | C535A-WJN-CU0V0231-ND |  |  | Link (http://www.digikey.com/scripts/DkSearch/dksus.dll?WT.z_header=search_go&lang=en&x=0&y=0&cur=USD)
6 | D260 | 1 | Diode | LED 5MM COOL WHITE CLEAR 110DEG | LED, Clear | 5mm | Cree Inc | C535A-WJN-CU0V0231 | Digikey | C535A-WJN-CU0V0231-ND |  |  | DNP
7 | J1 | 1 | Connector | CONN RECEPT MINI USB2.0 5POS | Mini USB Connector | -- | Hirose Electric Co Ltd | UX60-MB-5S8 | Digikey | H2960CT-ND |  |  | Link (http://www.digikey.com/product-detail/en/UX60-MB-5S8/H2960CT-ND/597539?cur=USD)
8 | K1 | 1 | Connector | CONN HEADER 3POS .100" SGL GOLD | 3 way Male Header | -- | Samtec Inc | TSW-150-07-L-S | Digikey | SAM1031-50-ND |  |  | Link (http://www.digikey.com/product-detail/en/TSW-150-07-L-S/SAM1031-50-ND/1101377?cur=USD)
9 | * | 1 | Connector | CONN JUMPER SHORTING .100" GOLD | Shorting Jumper, for K1 | -- | Sullins Connector Solutions | NPC02SXON-RC | Digikey | S9341-ND |  |  | Link (http://www.digikey.com/product-detail/en/NPC02SXON-RC/S9341-ND/2618266?cur=USD)
10 | K2 | 1 | Connector | CONN HEADER 3POS .100" SGL GOLD | 3 way Male Header | -- | Samtec Inc | TSW-150-07-L-S | Digikey | SAM1031-50-ND |  |  | Link (http://www.digikey.com/product-detail/en/TSW-150-07-L-S/SAM1031-50-ND/1101377?cur=USD)
11 | * | 1 | Connector | CONN JUMPER SHORTING .100" GOLD | Shorting Jumper, for K2 | -- | Sullins Connector Solutions | NPC02SXON-RC | Digikey | S9341-ND |  |  | Link (http://www.digikey.com/product-detail/en/NPC02SXON-RC/S9341-ND/2618266?cur=USD)
12 | K4 | 1 | Connector | CONN HEADER 2POS .100" SGL GOLD | 2 way Male Header | -- | Samtec Inc | TSW-150-07-L-S | Digikey | SAM1031-50-ND |  |  | Link (http://www.digikey.com/product-detail/en/TSW-150-07-L-S/SAM1031-50-ND/1101377?cur=USD)
13 | * | 1 | Connector | CONN JUMPER SHORTING .100" GOLD | Shorting Jumper, for K4 | -- | Sullins Connector Solutions | NPC02SXON-RC | Digikey | S9341-ND |  |  | Link (http://www.digikey.com/product-detail/en/NPC02SXON-RC/S9341-ND/2618266?cur=USD)
14 | K5 | 1 | Connector | CONN HEADER 2POS .100" SGL GOLD | 2 way Male Header | -- | Samtec Inc | TSW-150-07-L-S | Digikey | SAM1031-50-ND |  |  | Link (http://www.digikey.com/product-detail/en/TSW-150-07-L-S/SAM1031-50-ND/1101377?cur=USD)
15 | * | 1 | Connector | CONN JUMPER SHORTING .100" GOLD | Shorting Jumper, for K5 | -- | Sullins Connector Solutions | NPC02SXON-RC | Digikey | S9341-ND |  |  | Link (http://www.digikey.com/product-detail/en/NPC02SXON-RC/S9341-ND/2618266?cur=USD)
16 | P7 | 1 | Connector | CONN HEADER 6POS .100" SGL GOLD | 6 way Male Header |  | Samtec Inc | TSW-150-07-L-S | Digikey | SAM1031-50-ND |  |  | Link (http://www.digikey.com/product-detail/en/TSW-150-07-L-S/SAM1031-50-ND/1101377?cur=USD)
17 | Q1 to Q17 | 17 | Transistor | TRANS SS PNP 150V 600MA TO-92 | 2N5401 | TO-92-3 | ON Semiconductor | 2N5401G | Digikey | 2N5401GOS-ND |  |  | Link (http://www.digikey.com/product-detail/en/2N5401G/2N5401GOS-ND/1475210?cur=USD)
18 | R1 to R16, R30 | 17 | Resister | RES 100 OHM 1/8W 5% CF AXIAL | 100 Ohms | 1/8W axial | Stackpole Electronics Inc | CF18JT100R | Digikey | CF18JT100RCT-ND |  |  | Link (http://www.digikey.com/product-detail/en/CF18JT100R/CF18JT100RCT-ND/2022718?cur=USD)
19 | R17,R18,R19,R22,R23,R31,R36,R37,R38 | 9 | Resister | RES 10K OHM 1/8W 5% CF AXIAL | 10k | 1/8W axial | Stackpole Electronics Inc | CF18JT10K0 | Digikey | CF18JT10K0CT-ND |  |  | Link (http://www.digikey.com/product-detail/en/CF18JT10K0/CF18JT10K0CT-ND/2022766?cur=USD)
20 | R20,R21, | 2 | Resister | RES 4.7K OHM 1/8W 5% CF AXIAL | 4k7 | 1/8W axial | Stackpole Electronics Inc | CF18JT4K70 | Digikey | CF18JT4K70CT-ND |  |  | Link (http://www.digikey.com/product-detail/en/CF18JT4K70/CF18JT4K70CT-ND/2022758?cur=USD)
21 | R24,R25,R26, | 3 | Resister | RES 1K OHM 1/8W 5% CF AXIAL | 1k | 1/8W axial | Stackpole Electronics Inc | CF18JT1K00 | Digikey | CF18JT1K00CT-ND |  |  | Link (http://www.digikey.com/product-detail/en/CF18JT1K00/CF18JT1K00CT-ND/2022742?cur=USD)
22 | R32 | 1 | Resister | PHOTOCELL 10K-100K OHM 4.20MM | LDR | 4.2mm | Advanced Photonix Inc | PDV-P9007 | Digikey | PDV-P9007-ND |  |  | Link (http://www.digikey.com/product-detail/en/PDV-P9007/PDV-P9007-ND/480624?cur=USD)
23 | R33,R35 | 2 | Resister | RES 680 OHM 1/8W 5% CF AXIAL | 680 Ohms | 1/8W axial | Stackpole Electronics Inc | CF18JT680R | Digikey | CF18JT680RCT-ND |  |  | Link (http://www.digikey.com/product-detail/en/CF18JT680R/CF18JT680RCT-ND/2022738?cur=USD)
24 | R34 | 1 | Resister | POT 5.0K OHM THUMBWHEEL CERM ST | 5k Potentiometer | 1/2W | Bourns Inc. | 3352T-1-502LF | Digikey | 3352T-502LF-ND |  |  | Link Use 5k ohm instead of 2k ohm (http://www.digikey.com/product-detail/en/3352T-1-502LF/3352T-502LF-ND/1088351)
25 | SP1 | 1 | OTHER | BUZZER AUDIO 85DB 5MM PCB | Audio Buzzer | 5mm | CUI Inc | CEM-14R06CT | Digikey | 102-1169-ND |  |  | Link (http://www.digikey.com/product-search/en/audio-products/buzzers/720967?k=102-1169-ND)
26 | SW12,SW22,SW32,SW52 | 4 | OTHER | SWITCH TACTILE SPST-NO 0.05A 12V | Tactile Switch | 6mm x 6mm | TE Connectivity | FSM10JH | Digikey | 450-1647-ND |  |  | Link (http://www.digikey.com/scripts/DkSearch/dksus.dll?x=23&y=19&lang=en&KeyWords=450-1647-ND&cur=USD)
27 | SW42 | 1 | OTHER | SWITCH TACTILE SPST-NO 0.05A 12V | Tactile Switch | 6mm x 6mm | TE Connectivity | FSM2JH | Digikey | 450-1649-ND |  |  | Link (http://www.digikey.com/product-detail/en/FSM2JH/450-1649-ND/1632535?cur=USD)
28 | U1 | 1 | IC | IC LED DRIVER LINEAR 16-DIP | STP08DP05 | DIP-16 | STMicroelectronics | STP08DP05B1 | Digikey | 497-6271-5-ND |  |  | Link (http://www.digikey.com/product-detail/en/STP08DP05B1/497-6271-5-ND/1641765?cur=USD)
 | U1 Alternate replacement |  |  |  | TLC5916IN | DIP-16 | Texas Instruments | TLC5916IN | Element 14 | 1647814 |  |  | Link (http://cn.element14.com/texas-instruments/tlc5916in/device-topology-constant-current/dp/1647814?ost=TLC5916IN)
29 | * | 1 | OTHER | CONN IC SOCKET VERT 16POS TIN | IC Socket for U1 | DIP-16, 0.3 | TE Connectivity | 1-390261-4 | Digikey | A100206-ND |  |  | Link (http://www.digikey.com/product-detail/en/1-390261-4/A100206-ND/1125624?cur=USD)
30 | U2 | 1 | IC | IC REG LDO 5V 1A TO220AB | 7805 | TO-220 | ON Semiconductor | MC7805CTG | Digikey | MC7805CTGOS-ND |  |  | DNP
31 | U3 | 1 | IC | IC MCU AVR 32K FLASH 28PDIP | ATMEGA328 | DIP-28 | Atmel | ATMEGA328-PU | Digikey | ATMEGA328-PU-ND |  |  | Link (http://www.digikey.com/product-detail/en/ATMEGA328-PU/ATMEGA328-PU-ND/2271026?cur=USD)
32 | * | 1 | OTHER | CONN IC SOCKET VERT 28POS TIN | IC Socket for U3 | DIP-28, 0.3 | TE Connectivity | 1-390261-9 | Digikey | A100210-ND |  |  | Link (http://www.digikey.com/product-detail/en/1-390261-9/A100210-ND/990628?cur=USD)
33 | U4 | 1 | IC | IC 4-TO-16 DECODER/DEMUX 24SOIC | 74HC154 | 24-SOIC | Texas Instruments | CD74HC154M96 | Digikey | 296-24352-1-ND |  |  | Link (http://www.digikey.com/product-detail/en/texas-instruments/CD74HC154M96/296-24352-1-ND/2051238)
34 | * | 1 | OTHER | Breakout Board, SO 24 to DIP 24 | SO24toDIP | PCB | WyoLum | SO24toDIP | seeed | --
35 | * | 1 | OTHER | SOCKET IC OPEN FRAME 24POS .6" | IC Socket for U4 | DIP24, 0.6 | 3M | 4824-6004-CP | Digikey | 3M5479-ND |  |  | Link (http://www.digikey.com/product-detail/en/4824-6004-CP/3M5479-ND/1133632?cur=USD)
36 | U6 | 1 | IC | IC RTC W/TCXO 16-SOIC | DS3231 | 16-SOIC | Maxim Integrated | DS3231S# | Digikey | DS3231S#-ND |  |  | Link (http://goo.gl/1dP64)
37 | X1 | 1 | OTHER | CER RESONATOR 16.00MHZ | 16MHz resonator | -- | ECS Inc | ZTT-16.00MX | Digikey | X908-ND |  |  | DNP
38 | C11,C12 | 2 | Capacitor | CAP CER 22PF 50V 5% RADIAL | 22pF | -- | Vishay BC Components | K220J15C0GF5TH5 | Digikey | BC1034CT-ND |  |  | DNP
39 | CD1,CD2 | 2 | Connector | CONN SOCKET SGL VERT 4POS GOLD | 4 way Female socket | -- | 3M | 960104-6202-AR | Digikey | 3M9515-ND |  |  | DNP
40 | CD3 | 1 | Connector | CONN HEADER 4POS .100" SGL GOLD | 4 way Male Header | -- | Samtec Inc | TSW-150-07-L-S | Digikey | SAM1031-50-ND |  |  | DNP
41 | DIL-U1 | 1 | Connector | SOCKET IC OPEN FRAME 24POS .6" | IC Socket | DIP24, 0.6 | 3M | 4824-6004-CP | Digikey | 3M5479-ND |  |  | DNP
42 | J2 | 1 | Connector | CONN USB TYPE B R/A WHITE | Socket, USB-B | -- | On Shore Technology Inc | USB-B1HSW6 | Digikey | ED2982-ND |  |  | DNP
43 | J3 | 1 | Connector | CONN POWER JACK MALE 2.5MM CLSD | Socket, Barrel | -- | CUI Inc | PJ-002B | Digikey | CP-002B-ND |  |  | DNP
44 | K3 | 1 | OTHER | Solder Bridge | -- | -- | -- | -- | -- | -- |  |  | DNP
45 | P1 | 1 | Connector | CONN HEADER 8POS .100" SGL GOLD | 8 way Male Header | -- | Samtec Inc | TSW-150-07-L-S | Digikey | SAM1031-50-ND |  |  | DNP
46 | P13 | 1 | Connector | CONN HEADER .100" 3POS DUAL TIN | 3x2 way Male Header | -- | Samtec Inc | TLW-136-05-T-D | Digikey | SAM1095-36-ND |  |  | DNP
47 | P41 | 1 | Connector | CONN RCPT 4POS .100" SNGL HORZ | 4 way Female socket, Right Angle | -- | Samtec Inc | BCS-150-L-S-HE | Digikey | SAM1009-50-ND |  |  | DNP
48 | P42 | 1 | Connector | CONN HEADER 4PS .100 SGL R/A AU | 4 way Male Header, Right Angle | -- | Samtec Inc | TSW-150-08-L-S-RA | Digikey | SAM1043-50-ND |  |  | DNP
49 | SW1,SW2,SW3,SW4,SW5 | 5 | OTHER | SWITCH TACTILE SPST-NO 0.05A 12V | Tactile Switch | -- | TE Connectivity | FSMRA3JH | Digikey | 450-1657-ND |  |  | DNP
1. Recommended Distributor: Digi-Key, Mouser, Avnet Express, Farnell.
2. Catalog: Capacitor,Resister,Diode,Connector,Transistor,IC,PROTECTOR CATEGORY,OTHER
3. Required Fields: Item No, Reference Des, Qty, Catalog, Part_Value, Part Package
Optional Fields: Part_Description, Manufacturers Name, Manufacturers Part No, Distributors Name, Distributors Part No, Unit Cost, Price break to use, Notes/Remark
