wyolum/ClockTHREEjr/KiCAD/SOIC2DIP/soic2dip_BoM_sch.csv

Reference | Value | Footprint | Datasheet
U1 | STP8DP05
U2 | STP16DP05
