wyolum/ClockTHREEjr/KiCAD/C3Jr_v2/c3jr_v2_BoM_Short.xls

BoM, for kit building assembly
ref | value | Vendor | Vendor P/N | NOTE1 | NOTE 2 | MODULE
BT1 | BATT_RTC | DigiKey (http://search.digikey.com/scripts/DkSearch/dksus.dll?x=0&y=0&lang=en&site=us&KeyWords=3003K-ND) | 3003K-ND |  | Battery Socket | CR2032
* | 3V CR2032 Battery | DigiKey (http://search.digikey.com/us/en/products/CR2032/P189-ND/31939) | P189-ND |  | LR2032 Coin Battery | --
C1,C2,C8 | 100u | DigiKey (http://search.digikey.com/us/en/products/ECE-A1CKA101/P833-ND/44757) | P833-ND |  | Capacitor Voltage Rating >= 16V | CP_5x11mm
C3,C4,C5,C6,C7,C9,C10 | 100n | DigiKey (http://search.digikey.com/us/en/products/R82DC3100AA50J/399-5863-ND/2571298) | 399-5863-ND |  | Decoupling capacitor | C2
D1 to D128 | LED | DigiKey (http://search.digikey.com/scripts/DkSearch/dksus.dll?WT.z_header=search_go&lang=en&site=us&x=0&y=0) | C535A-WJN-CU0V0231-ND |  | CREE LED 5mm Cool White Clear 110deg | led_5mm_clear
D258 | DBG | DigiKey (http://search.digikey.com/us/en/products/MV8112/1080-1134-ND/2675625) | 1080-1134-ND |  | Debug LED, 3mm or 5mm LED, any Color | led_5mm_blue
D260 | PWR | DigiKey (http://search.digikey.com/us/en/products/MV8112/1080-1134-ND/2675625) | 1080-1134-ND |  | Power On LED, 3mm or 5mm LED, any Color | led_5mm_blue
J1 | V_IN | DigiKey (http://search.digikey.com/us/en/products/UX60-MB-5S8/H2960CT-ND/597539) | H2960CT-ND |  | USB-Mini Socket | con-hirose-UX60-MB-5S8
K1 | PWR | DigiKey (http://search.digikey.com/us/en/products/TSW-150-07-L-S/SAM1031-50-ND/1101377) | SAM1031-50-ND |  | Header, Male, 3 pin, for PWR_SEL | SEL
* |  | DigiKey (http://search.digikey.com/us/en/products/NPC02SXON-RC/S9341-ND/2618266) | S9341-ND |  | Jumper socket for PWR_SEL K1 | --
K2 | LED_ENABLE | DigiKey (http://search.digikey.com/us/en/products/TSW-150-07-L-S/SAM1031-50-ND/1101377) | SAM1031-50-ND |  | Header, Male, 3 pin, for LED_ENABLE | pin_strip_3
* |  | DigiKey (http://search.digikey.com/us/en/products/NPC02SXON-RC/S9341-ND/2618266) | S9341-ND |  | Jumper socket for LED_ENABLE K2 | --
K4 | SCL | DigiKey (http://search.digikey.com/us/en/products/TSW-150-07-L-S/SAM1031-50-ND/1101377) | SAM1031-50-ND |  | Header, Male, 2 pin, Link for INT, OPEN for EXT | pin_strip_2
* |  | DigiKey (http://search.digikey.com/us/en/products/NPC02SXON-RC/S9341-ND/2618266) | S9341-ND |  | Jumper socket for SCL, K4 | --
K5 | SDA | DigiKey (http://search.digikey.com/us/en/products/TSW-150-07-L-S/SAM1031-50-ND/1101377) | SAM1031-50-ND |  | Header, Male, 2 pin, Link for INT, OPEN for EXT | pin_strip_2
* |  | DigiKey (http://search.digikey.com/us/en/products/NPC02SXON-RC/S9341-ND/2618266) | S9341-ND |  | Jumper socket for SDL, K5 | --
P7 | FTDI | DigiKey (http://search.digikey.com/us/en/products/TSW-150-07-L-S/SAM1031-50-ND/1101377) | SAM1031-50-ND |  | Header, Male, 6 pin, for FTDI | pin_strip_6
Q1 to Q17 | 2N5401 | DigiKey (http://search.digikey.com/us/en/products/2N5401G/2N5401GOS-ND/1475210) | 2N5401GOS-ND |  | Transistor, TO-92-3 | to92_2N5401
R1 to R16 | 100 | DigiKey (http://search.digikey.com/us/en/products/CF18JT100R/CF18JT100RCT-ND/2022718) | CF18JT100RCT-ND |  | Resistor, 1/8W, 5% | rc03_vert_LED
R17,R18,R19,R22,R23,R31,R36,R37,R38 | 10k | DigiKey (http://search.digikey.com/us/en/products/CF18JT10K0/CF18JT10K0CT-ND/2022766) | CF18JT10K0CT-ND |  | Resistor, 1/8W, 5% | RC03
R20,R21 | 4k7 | DigiKey (http://search.digikey.com/us/en/products/CF18JT4K70/CF18JT4K70CT-ND/2022758) | CF18JT4K70CT-ND |  | Resistor, 1/8W, 5% | RC03
R24,R25,R26 | 1k | DigiKey (http://search.digikey.com/us/en/products/CF18JT1K00/CF18JT1K00CT-ND/2022742) | CF18JT1K00CT-ND |  | Resistor, 1/8W, 5% | RC03
R30 | 100E | DigiKey (http://search.digikey.com/us/en/products/CF18JT100R/CF18JT100RCT-ND/2022718) | CF18JT100RCT-ND |  | Resistor, 1/8W, 5% | RC03
R32 | LDR SOCKET | DigiKey (http://search.digikey.com/us/en/products/5-534206-1/A32932-ND/1093003) | A32932-ND |  | Socket header, 2 pin, for LDR | pin_strip_2
-- | LDR | DigiKey (http://search.digikey.com/us/en/products/PDV-P9007/PDV-P9007-ND/480624) | PDV-P9007-ND |  | LDR, 10k to 100k | --
R33,R35 | 680E | DigiKey (http://search.digikey.com/us/en/products/CF18JT680R/CF18JT680RCT-ND/2022738) | CF18JT680RCT-ND |  | Resistor, 1/8W, 5% | RC03
R34 | 2k | DigiKey (http://search.digikey.com/us/en/products/3352T-1-202LF/3352T-202LF-ND/1088345) | 3352T-202LF-ND |  | Pot, Thumbwheel, Ceramic, | Pot-Var2
SP1 | SPEAKER | DigiKey (http://search.digikey.com/scripts/dksearch/dksus.dll?vendor=0&keywords=102-1169-ND) | 102-1169-ND |  | Audio Buzzer | Speaker
SW12,SW22,SW32,SW52 | INC | DigiKey (http://search.digikey.com/scripts/DkSearch/dksus.dll?x=23&y=19&lang=en&site=us&KeyWords=450-1647-ND) | 450-1647-ND |  | Push button switch, Long Button | SW-PB-MOD
SW42 | RST | DigiKey (http://search.digikey.com/us/en/products/FSM2JH/450-1649-ND/1632535) | 450-1649-ND |  | Push button switch, Short Button | SW-PB-MOD
U1 | STP8DP05 | DigiKey (http://search.digikey.com/us/en/products/STP08DP05B1/497-6271-5-ND/1641765) | 497-6271-5-ND |  | IC, Row Driver | dil_16-300_socket
* | Socket STP8DP05 | DigiKey (http://search.digikey.com/us/en/products/1-390261-4/A100206-ND/1125624) | A100206-ND |  | Socket for IC U1 | --
U2 | 7805 | -- | -- |  | SHORTING LINK between VI and VO | TO-220_Horizontal
U3 | ATMEGA8-P | DigiKey (http://search.digikey.com/us/en/products/ATMEGA328-PU/ATMEGA328-PU-ND/2271026) | ATMEGA328-PU-ND |  | Micro Controller | dil_28-300_socket
* | IC ATMEGA8-P | DigiKey (http://search.digikey.com/us/en/products/1-390261-9/A100210-ND/990628) | A100210-ND |  | Socket for IC U3 | --
U4 | 74HC154 | DigiKey (http://search.digikey.com/us/en/products/74HC154N,652/568-1407-5-ND/763011) | 568-1407-5-ND |  | IC, Column Driver | DIP-24__600_ELL
* | IC 74HC154 | DigiKey (http://search.digikey.com/us/en/products/4824-6004-CP/3M5479-ND/1133632) | 3M5479-ND |  | Socket for IC U4 | --
U6 | DS3231N | DigiKey (http://search.digikey.com/us/en/products/DS3231S/DS3231S) | DS3231S#-ND |  | IC, RTC | DS3231
X1 | 16MHz | DigiKey (http://search.digikey.com/us/en/products/ZTT-16.00MX/X908-ND/170095) | X908-ND |  | Resonator, with capacitors, 3 pin | XTAL
NOT USED COMPONENTS
C11,C12 | 22p | DigiKey (http://search.digikey.com/us/en/products/K220J15C0GF5TH5/BC1034CT-ND/286656) | BC1034CT-ND | Optional | if using crystal instead of resonator | cnp_3mm_disc
CD1,CD2,CD3 | CDOT1 | DigiKey (http://search.digikey.com/us/en/products/960104-6202-AR/3M9515-ND/2071556) | 3M9515-ND | Optional | if using I2SD, rtcBoB or ChronoDot, Socket, 4 pin | pin_strip_4
DIL-U1 | STP16DP05 | DigiKey (http://search.digikey.com/us/en/products/4824-6004-CP/3M5479-ND/1133632) | 3M5479-ND | Optional | if using rowBoB, 24 pin IC socket | SCK-24_600_ELL
J2 | V_IN | DigiKey (http://search.digikey.com/us/en/products/USB-B1HSW6/ED2982-ND/2677743) | ED2982-ND | Optional | USB-B, Socket | con-usb-USB-B-H
J3 | V_IN | DigiKey (http://search.digikey.com/us/en/products/PJ-002B/CP-002B-ND/96965) | CP-002B-ND | Optional | Barrel socket | JACK_ALIM
K3 | 7Seg_Sel | -- | -- | Optional | Solder Bridge for uC pin selection | 7Seg_Sel
P1 | 7SegDisp | Sparkfun (http://www.sparkfun.com/products/9766) | COM-09766 | Optional | 7 segment 4 digit display | pin_strip_8
P13 | ISP | DigiKey (http://search.digikey.com/us/en/products/TLW-136-05-T-D/SAM1095-36-ND/1104872) | SAM1095-36-ND | Optional | Header, 3x2 pin | pin_strip_3x2
P41 | STACK-L | DigiKey (http://search.digikey.com/us/en/products/BCS-150-L-S-HE/SAM1009-50-ND/1100271) | SAM1009-50-ND | Optional | Socket, 4 pin, right angle, for daisy-chaining boards | pin_sck_4-90
P42 | STACK-R | DigiKey (http://search.digikey.com/us/en/products/TSW-150-08-L-S-RA/SAM1043-50-ND/1101974) | SAM1043-50-ND | Optional | Header, 4 pin, right angle, for daisy-chaining boards | pin_strip_4-90
P43 | CONN_1 | -- | Break Out Pad, no component | Optional | ATMega Port PC2 | Pad01
SW1,SW2,SW3,SW4,SW5 | INC | DigiKey (http://search.digikey.com/us/en/products/FSMRA3JH/450-1657-ND/1632543) | 450-1657-ND | Optional | Right Angle switch, for Top access | SW_PB_V
U2 | 7805 | DigiKey (http://search.digikey.com/us/en/products/MC7805CTG/MC7805CTGOS-ND/919333) | MC7805CTGOS-ND | Optional | ONLY if V_IN > 5V. ELSE USE SHORTING LINK | TO-220_Horizontal
MISC. COMPONENTS
BF1 | BAFFLE |  |  |  | Angus Hines | Baffle
BP1 | BackPlate |  |  |  | Angus Hines | BackPlate
FM1 | FRAME |  |  |  | Ikea or None | Frame
FP1 | FacePlate |  |  |  | Angus Hines | FacePlate
P8,P9,P10,P11 | CONN_1 |  |  |  | Fixing Screw for Board | vite_4mm
P14,P15,P53,P54 | CONN_1 |  |  |  | Fixing Screw for Baffle | vite_4mm
P49,P40,P51,P52 | CONN_1 |  |  |  | Fixing Screw for rtcBoB | vite_4mm
rowBoB1 | CONN_1 |  |  |  | Fixing Screw for rowBoB | vite_3mm
P24 to P39 | DIL6 |  |  |  | Prototyping area | PROTO-6
PCB1 | PCB |  |  |  | Main Board, seeed | PCB
