wyolum/ClockTHREEjr/fabricate/baffles_jr_std2.5.pdf

H baffle: 10 per clock

localizer: 4 per clock

ClockTHREE_v2 Baffles 0.06" BLACK Acrylic
