wyolum/ClockTHREEjr/fabricate/JosefinSans-Regular_lower_v2jr_std2.5.pdf

JosefinSans-Regular_lower_v2 std2.5

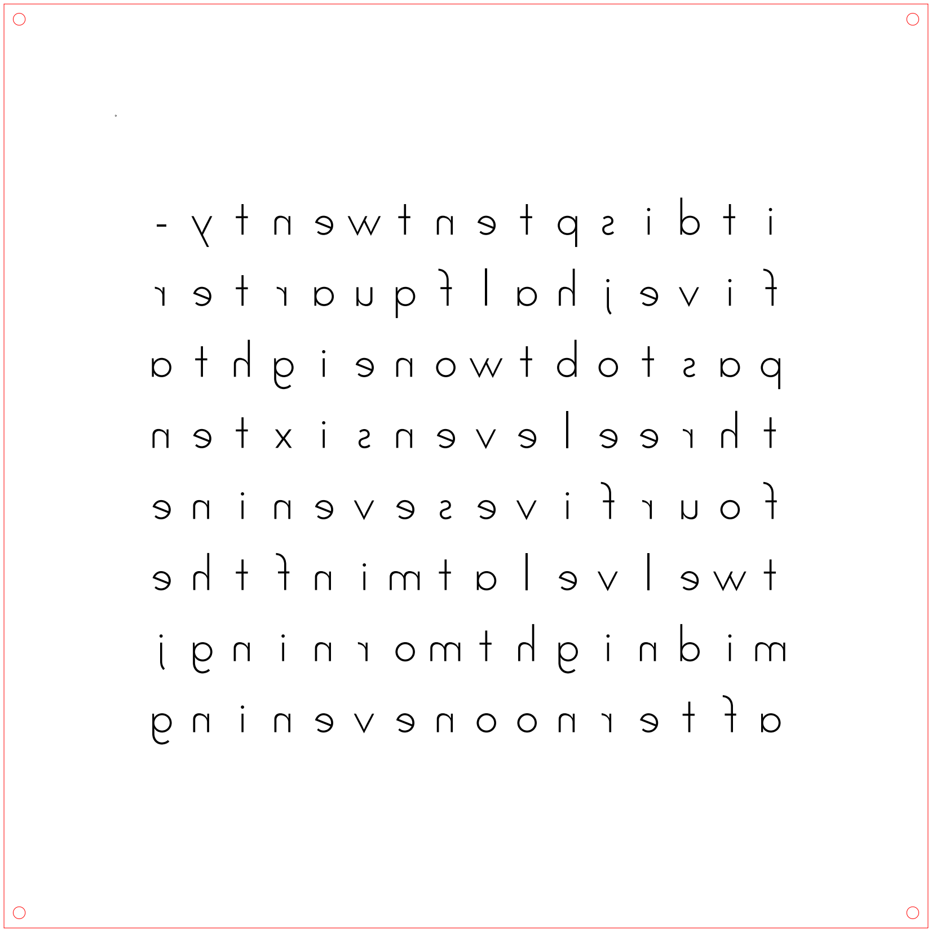
[picture p74: figure]
