wyolum/ClockTHREEjr/fabricate/JosefinSans-Regular_lower_v2jr_std2.5.png

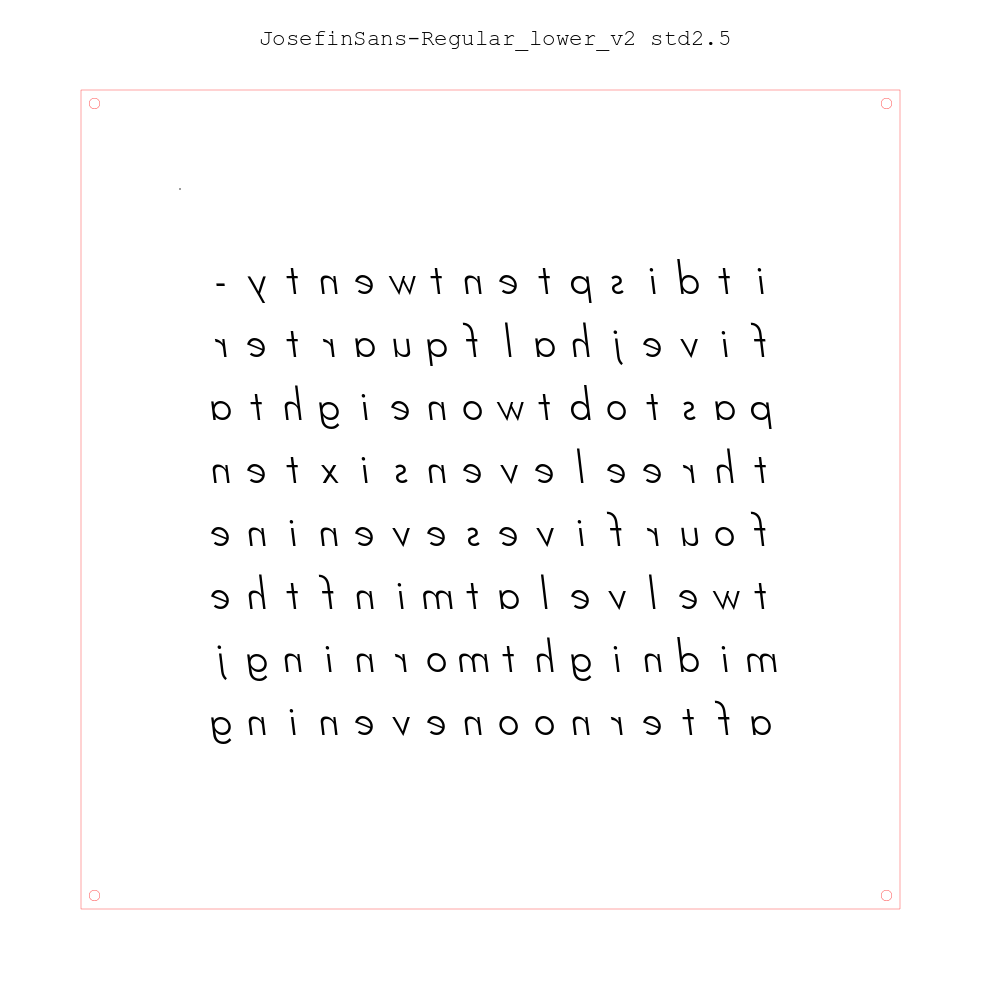
fabricate/JosefinSans-Regular_lower_v2jr_std2.5.png
