wyolum/ClockTHREEjr/fabricate/backplate_jr_std2.5.pdf

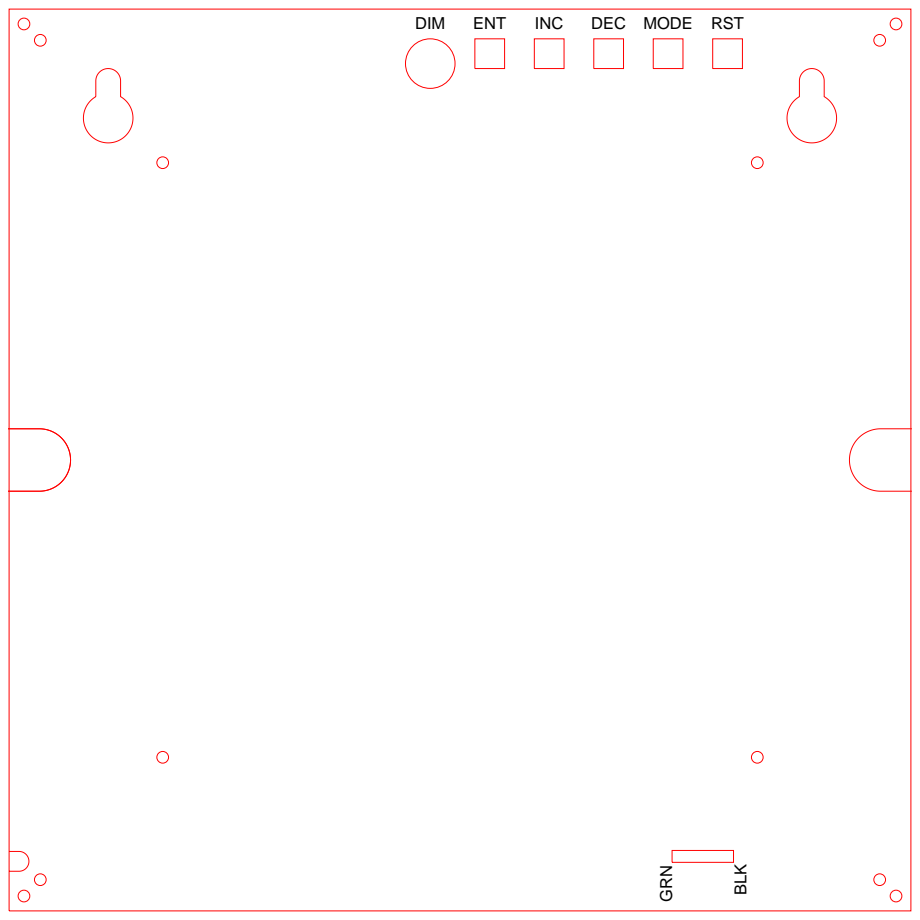
[picture p76: page 1]
DIM; ENT; INC; DEC MODE RST GRN; BLK
