wyolum/ClockTHREEjr/KiCAD/C3Jr_v2/C3Jr_v2_PCB-SilkBack.pdf

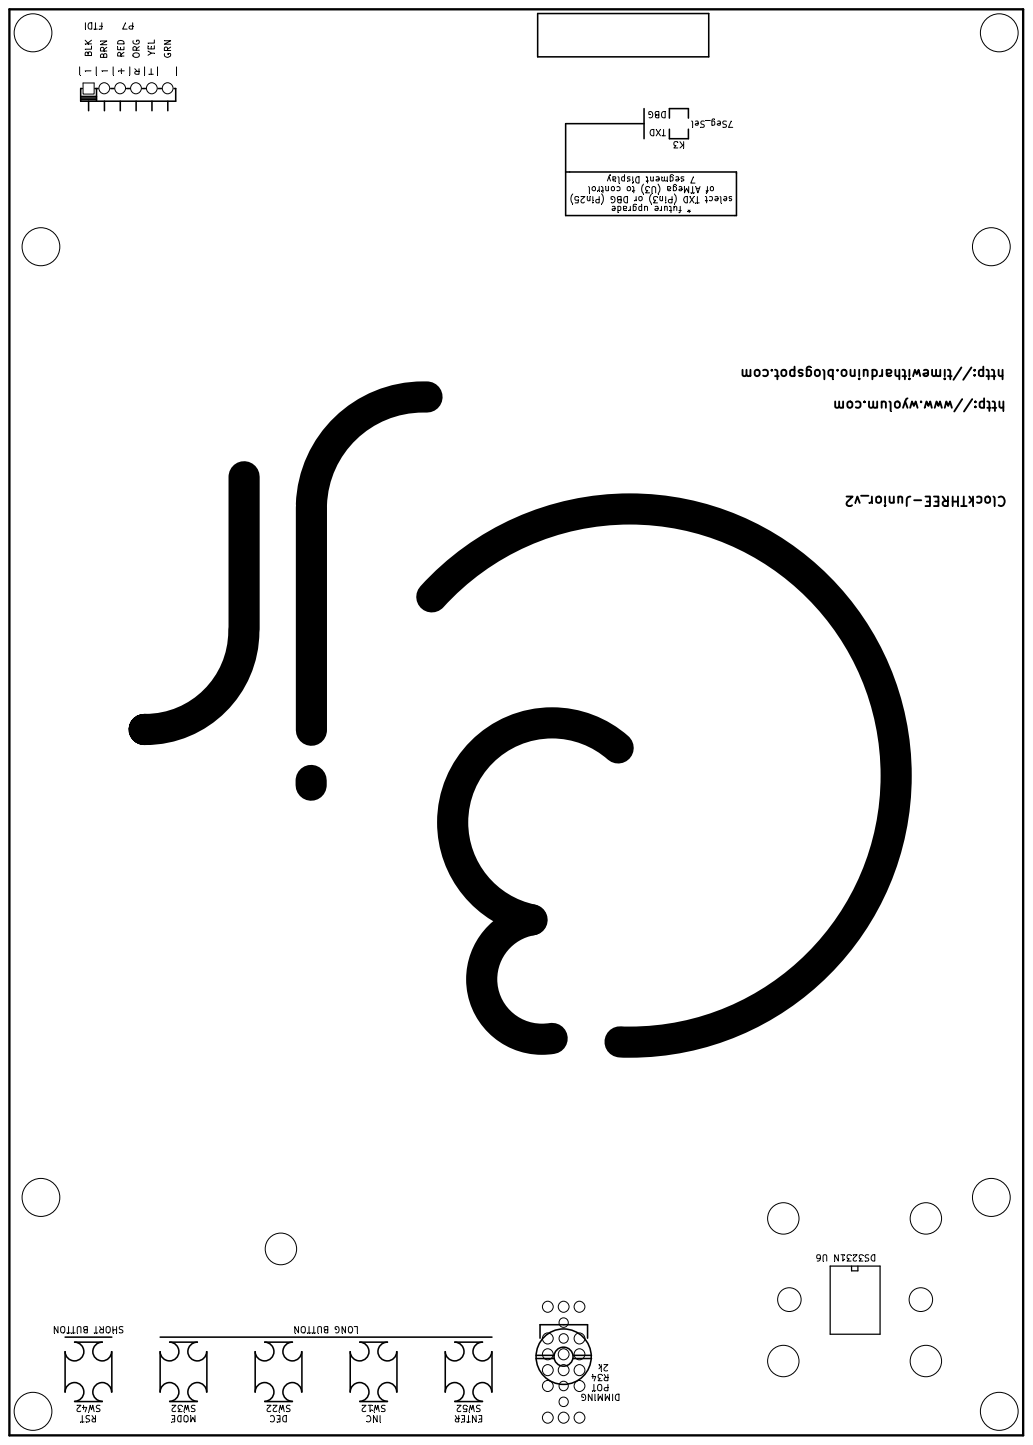
[picture p77: page 1]
