wyolum/ClockTHREEjr/KiCAD/C3Jr_v2/C3Jr_v2_PCB-SilkFrnt.pdf

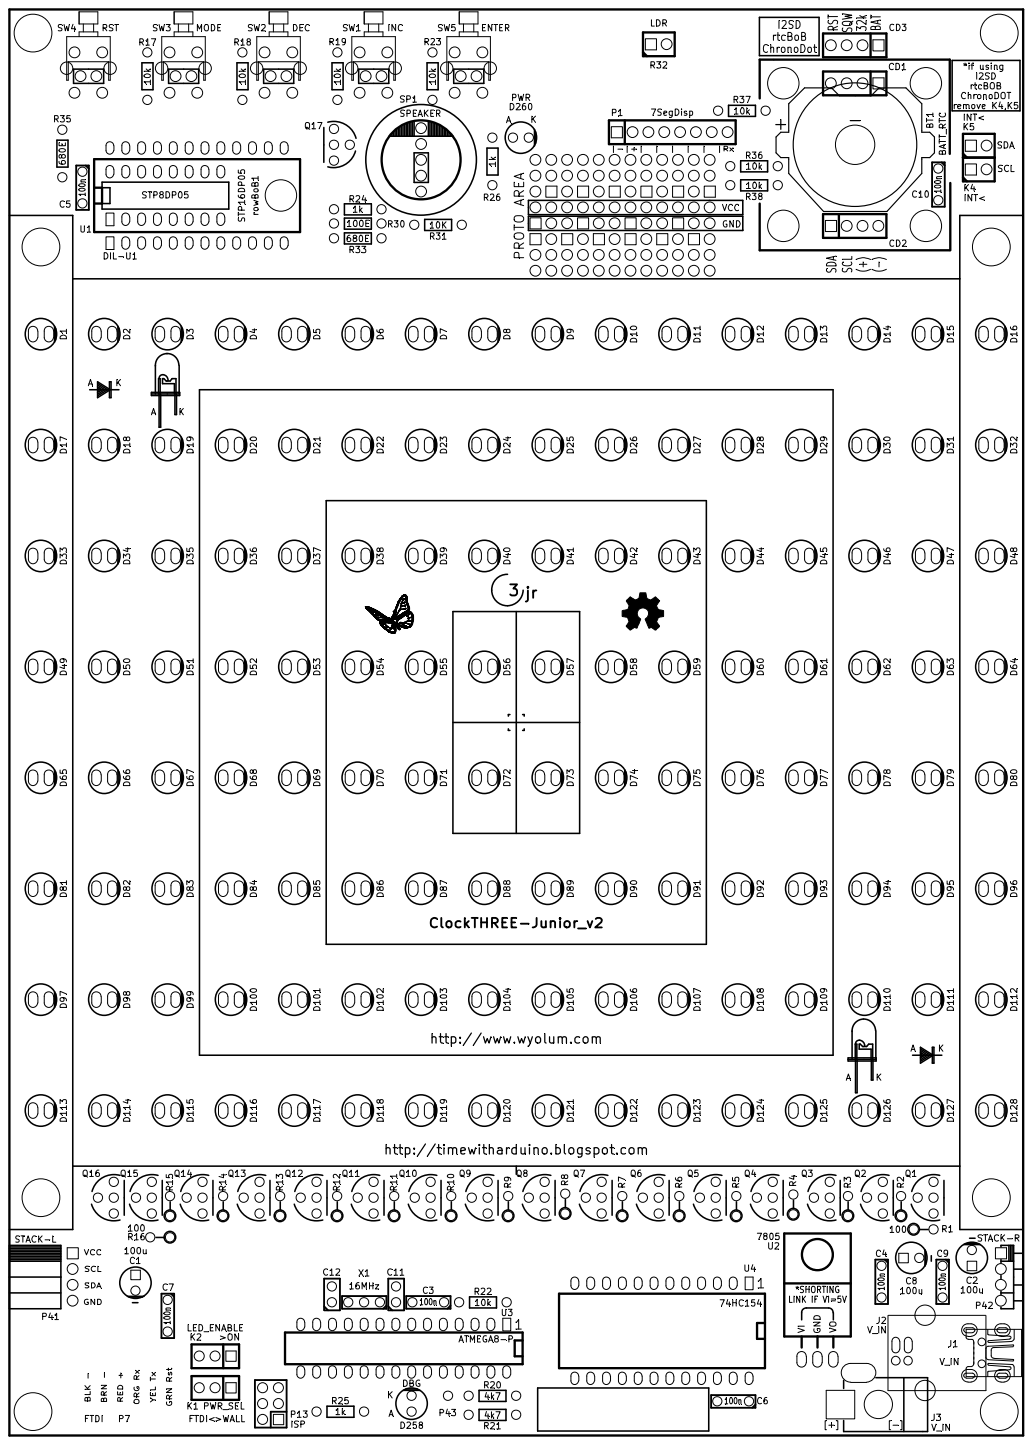
[picture p78: page 1]
