wyolum/ClockTHREEjr/KiCAD/C3Jr_v2/C3Jr_v2_PCB-Single.pdf

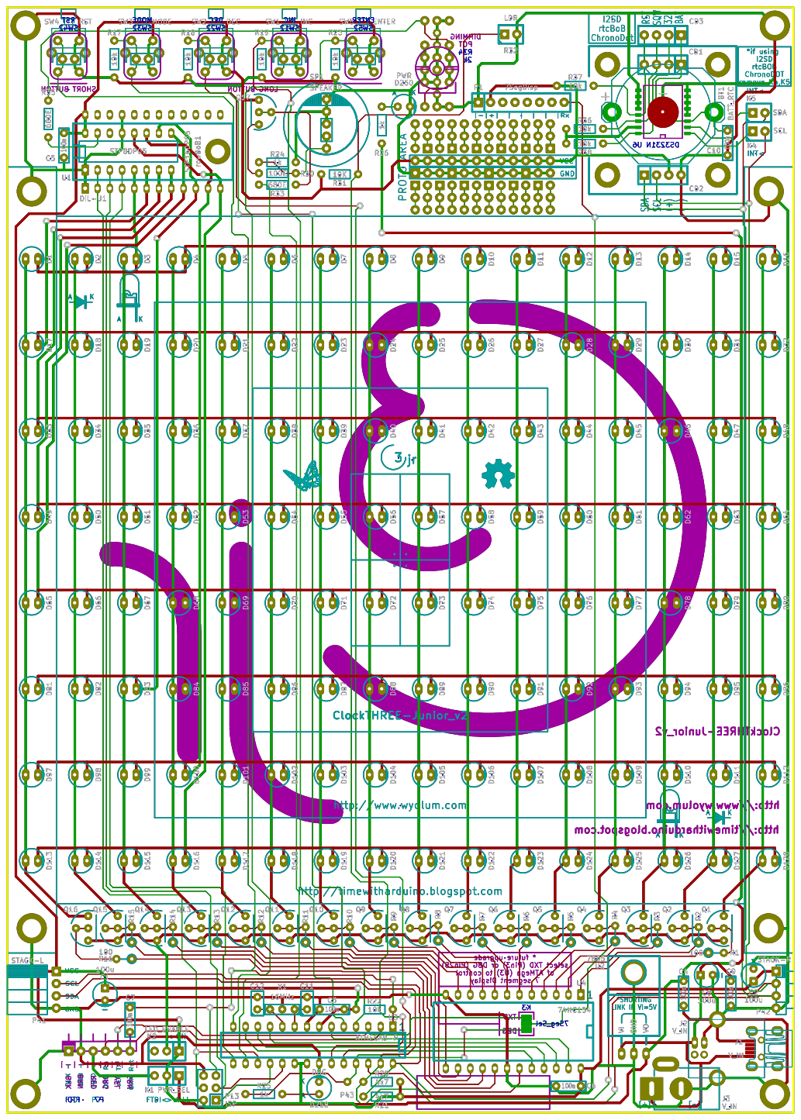
[picture p79: page 1]
