wyolum/ClockTHREEjr/KiCAD/C3Jr_v2/C3Jr_v2_PCB.pdf

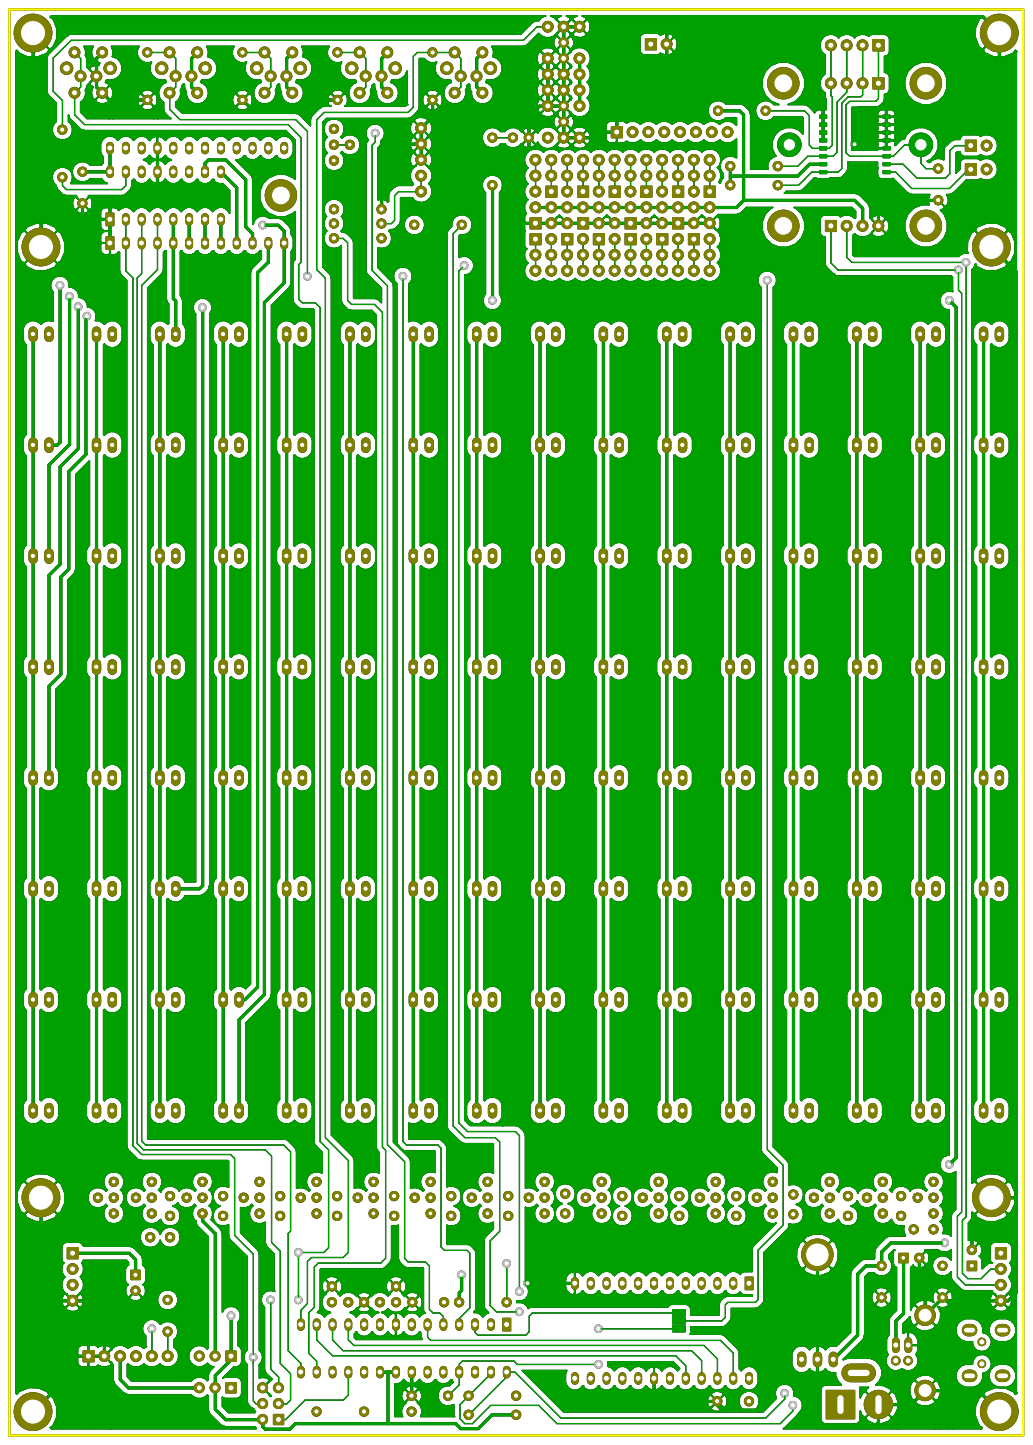
[picture p80: page 1]

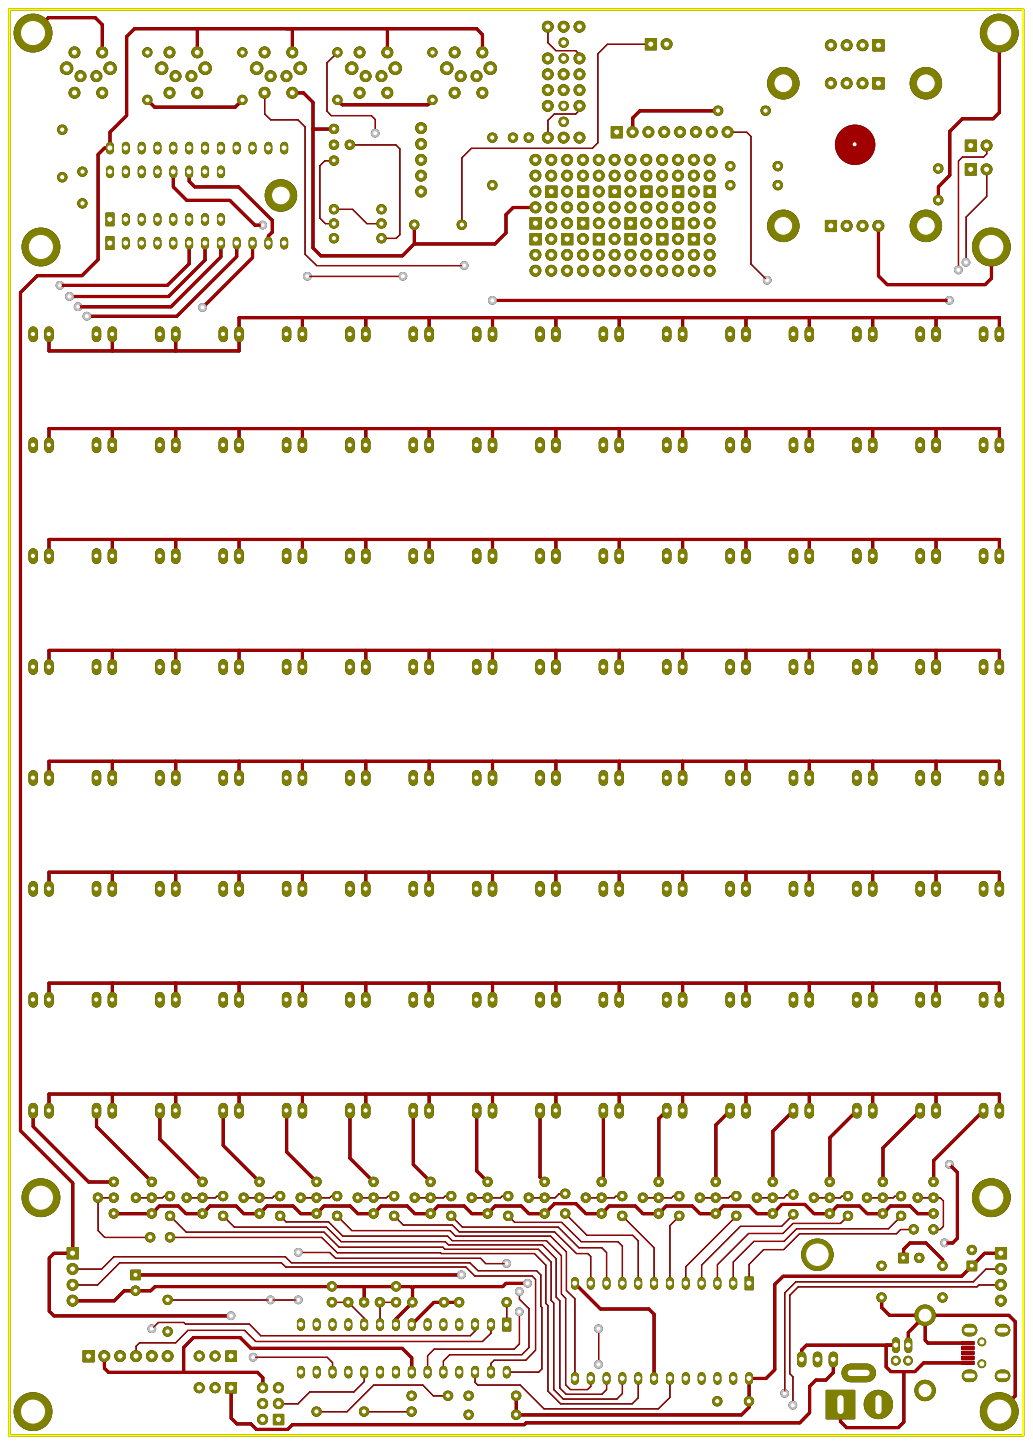
[picture p81: page 2]

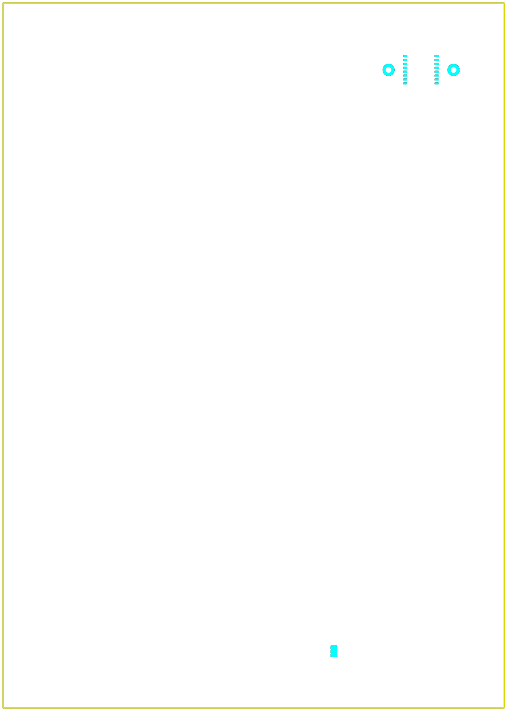
[picture p82: figure]
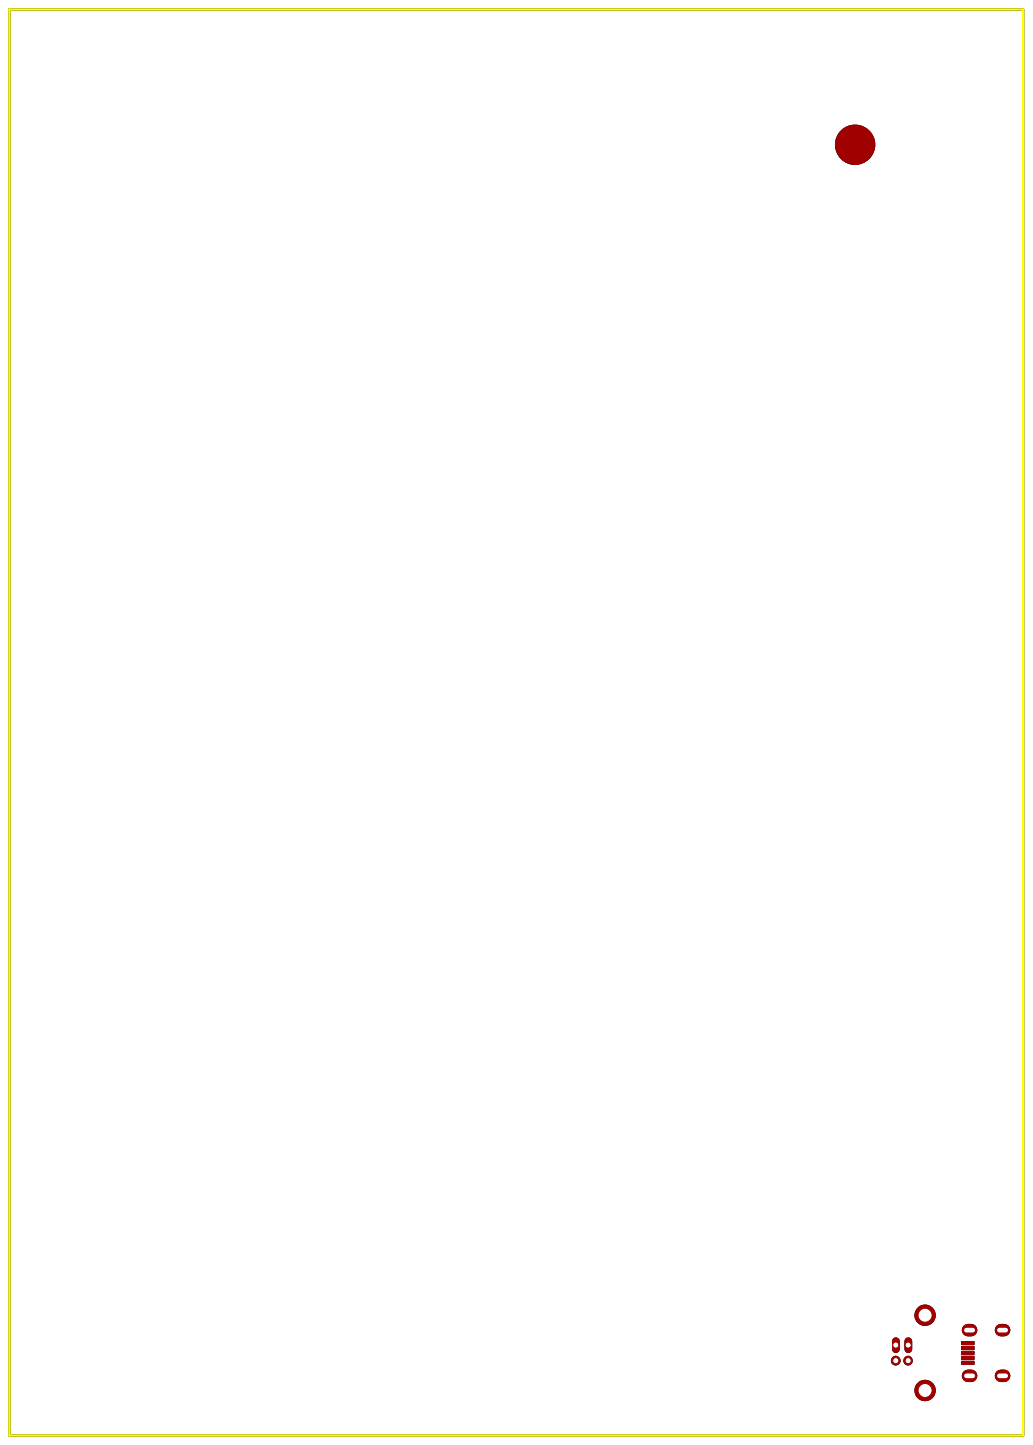
[picture p83: page 4]

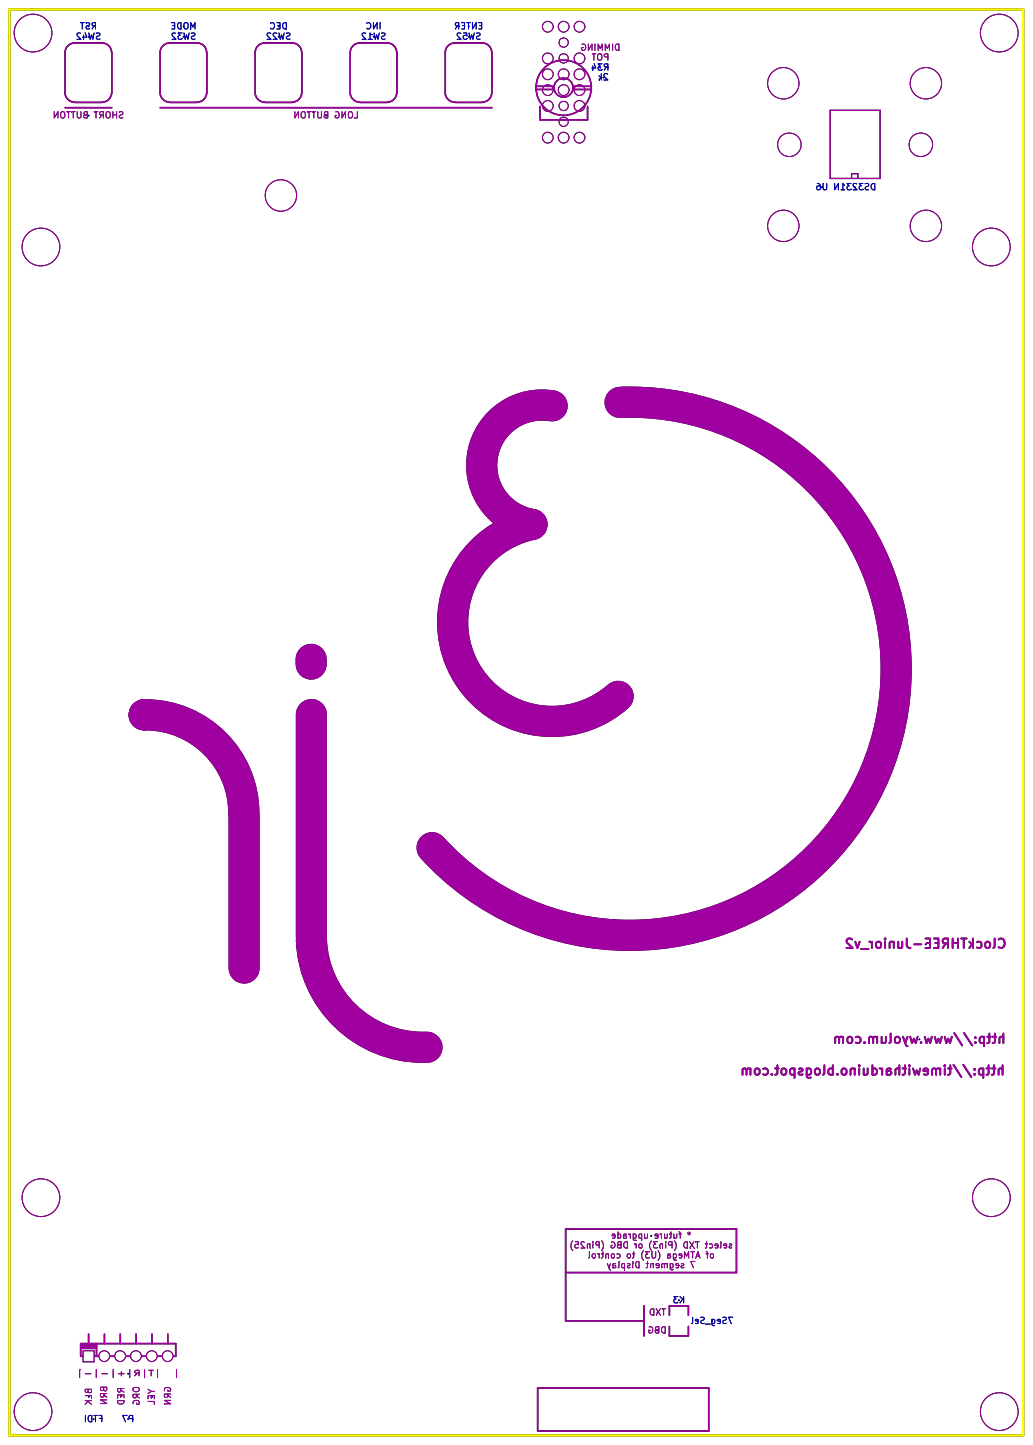
[picture p84: page 5]

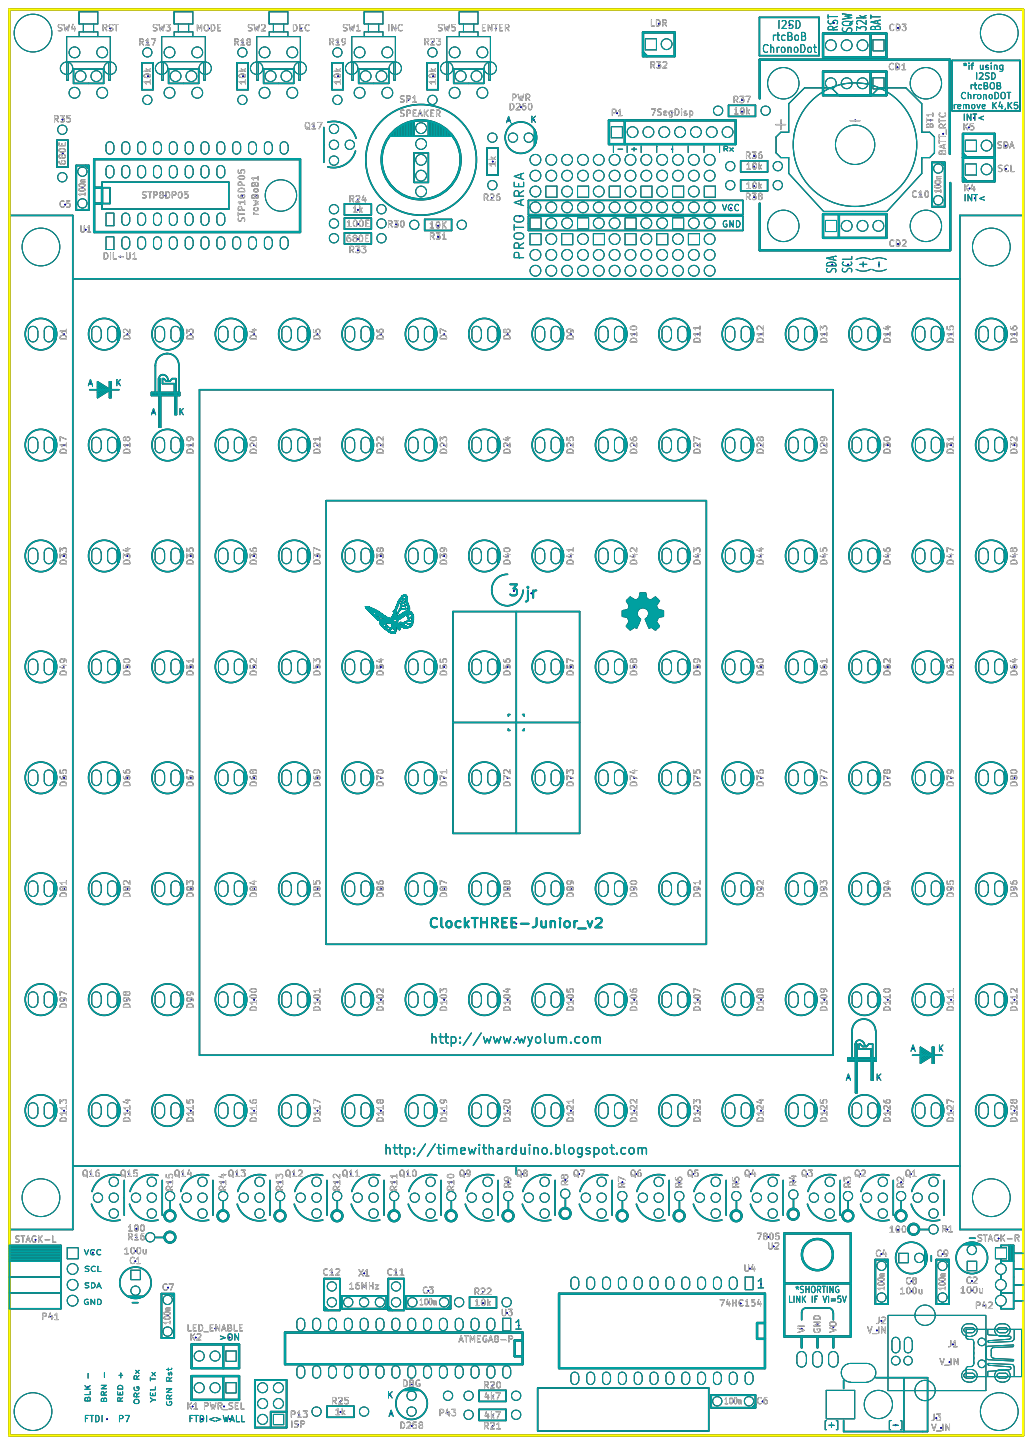
[picture p85: page 6]

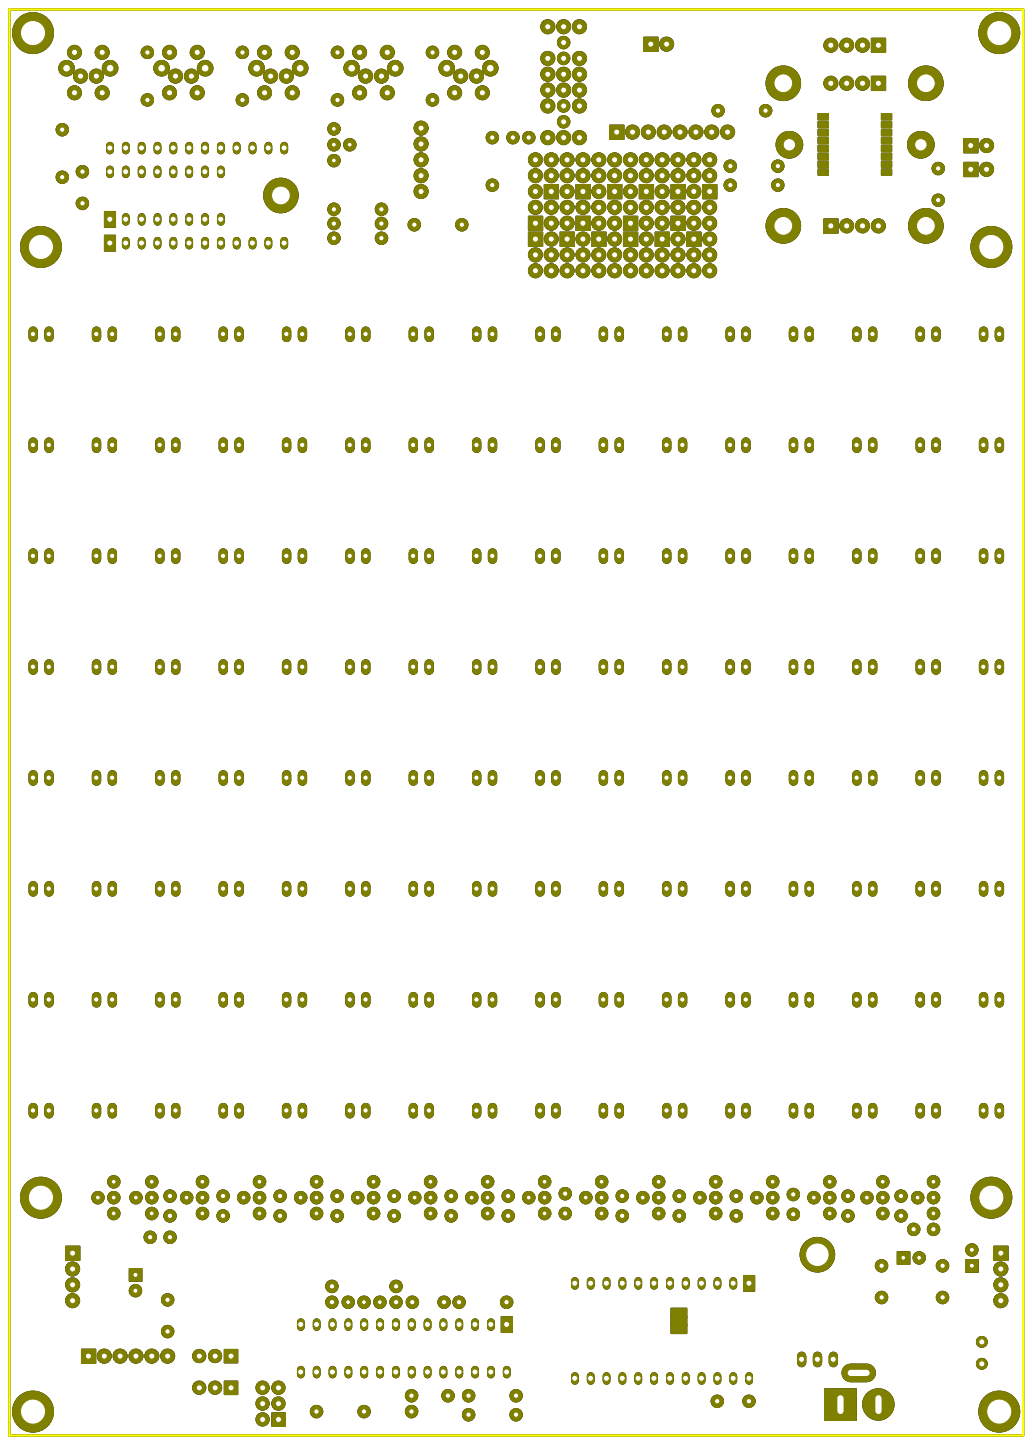
[picture p86: page 7]

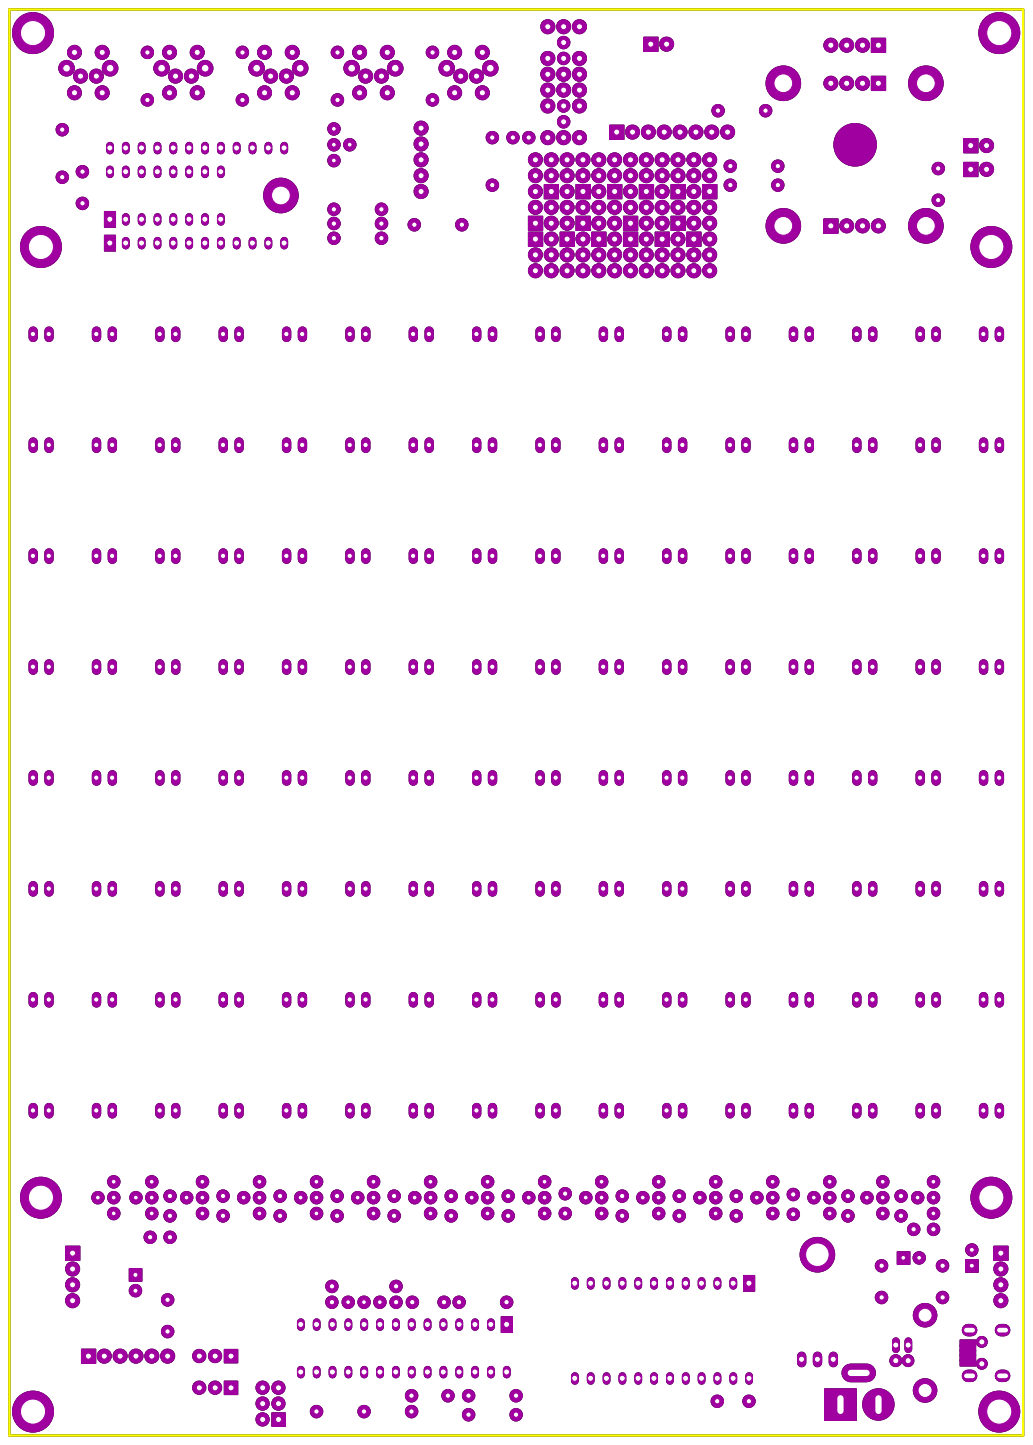
[picture p87: page 8]

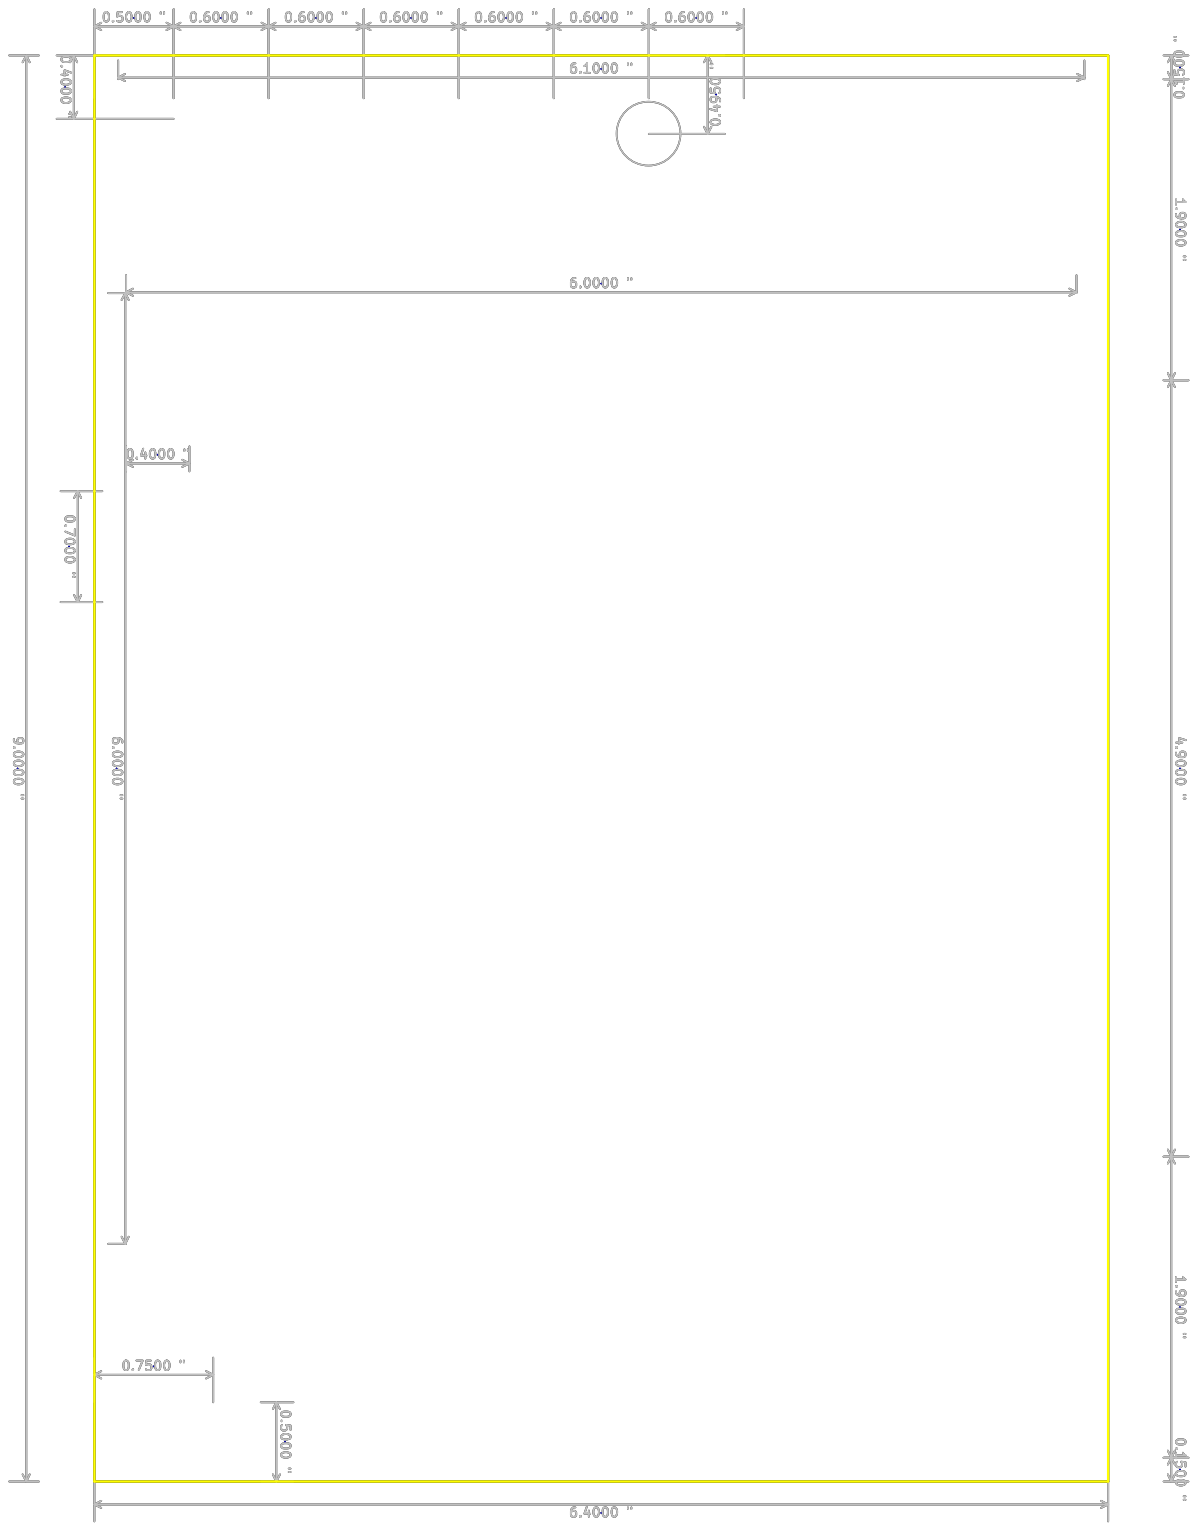
[picture p88: page 9]
