wyolum/ClockTHREEjr/KiCAD/C3Jr_v2/C3Jr_v2_SCH.pdf

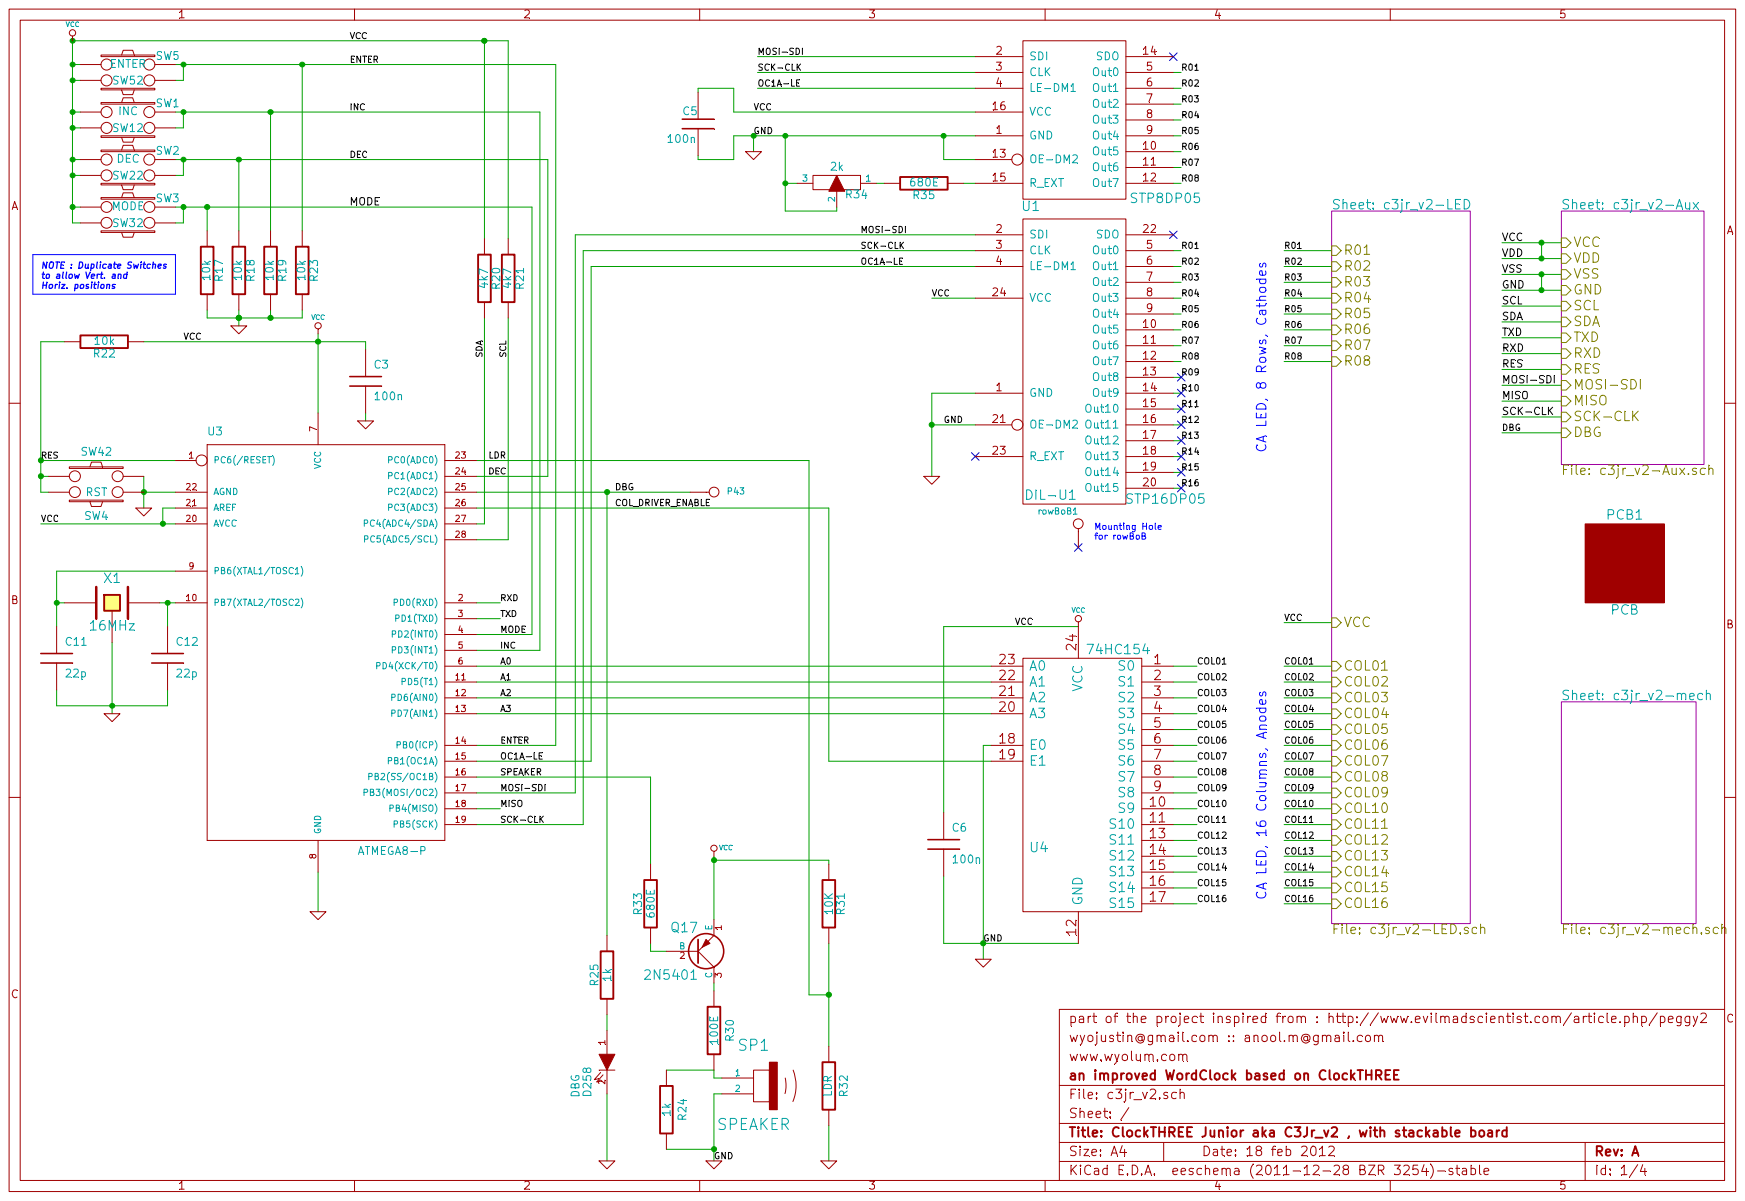
[picture p89: page 1]

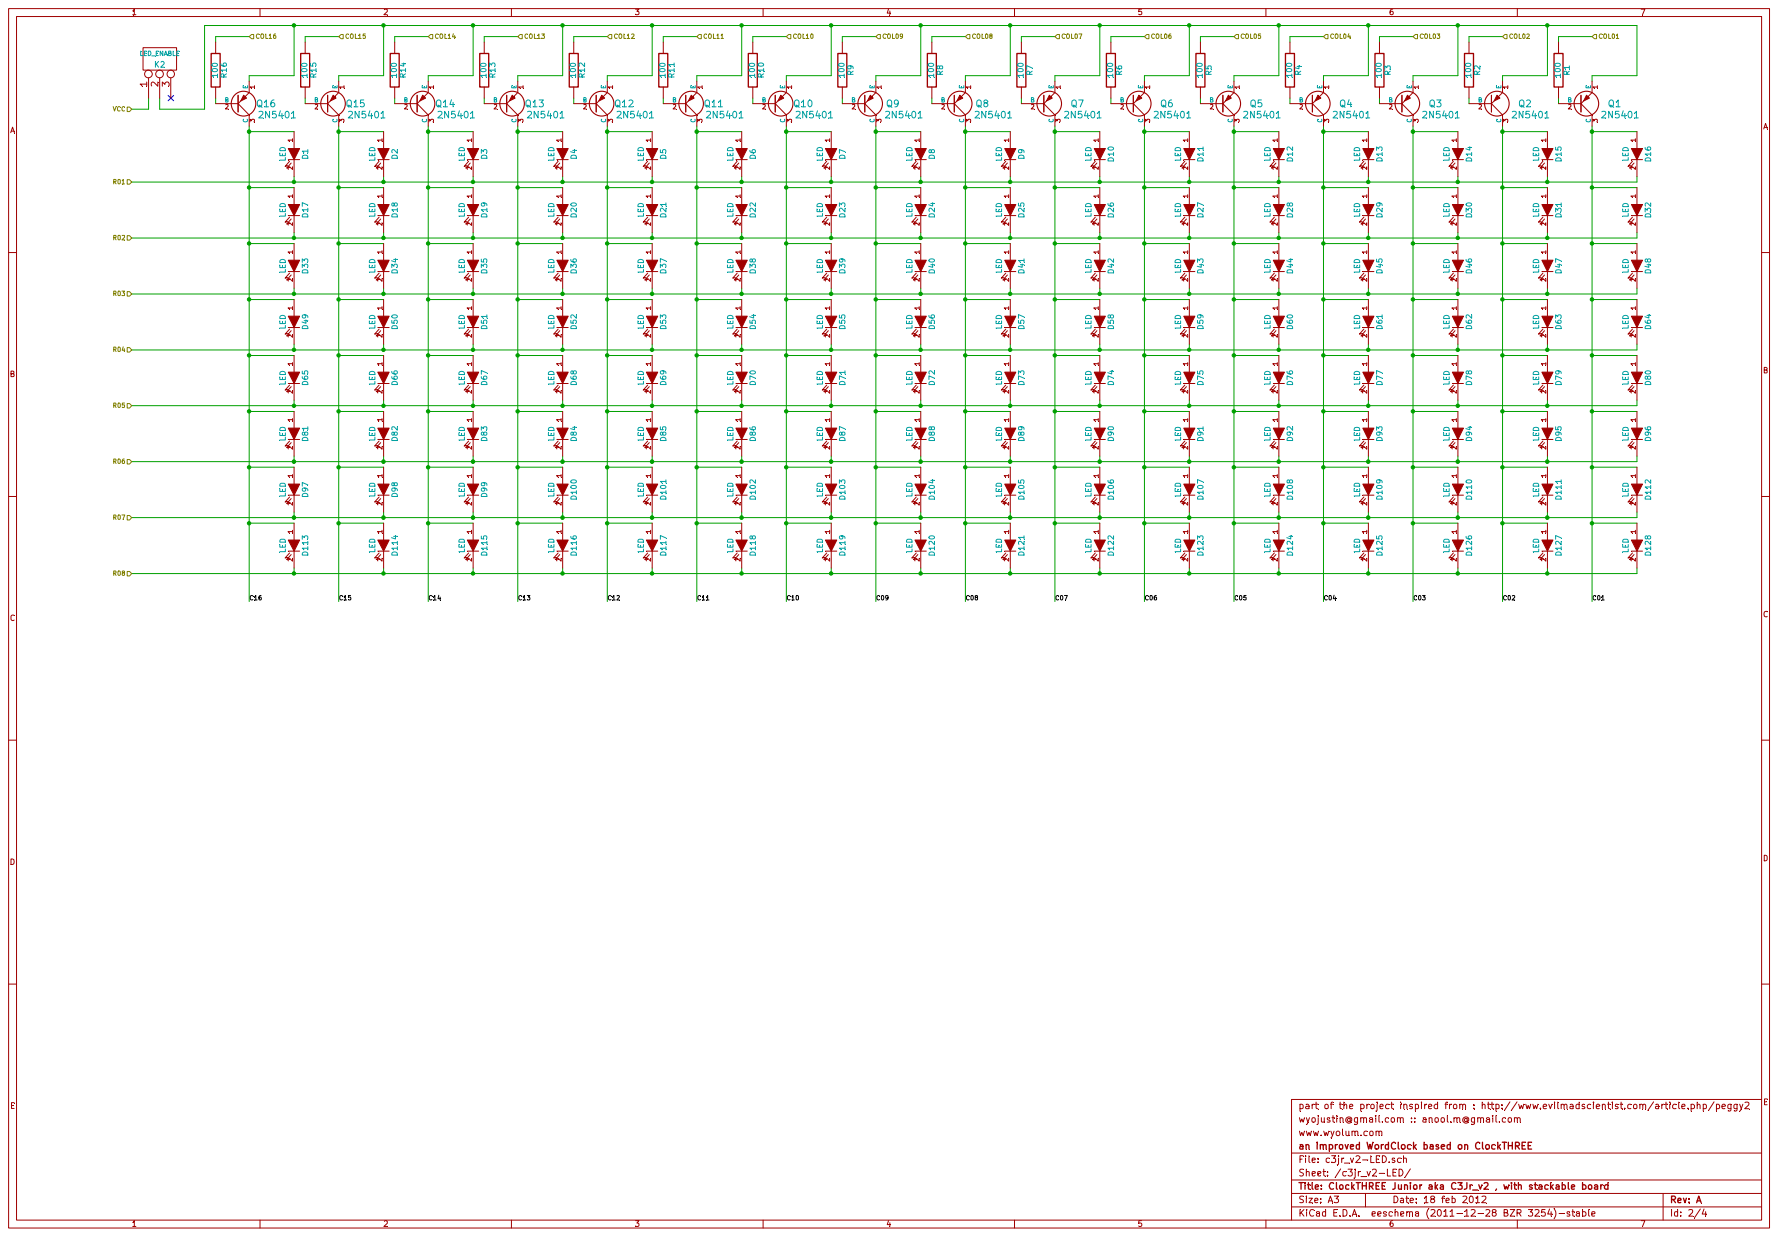
[picture p90: page 2]

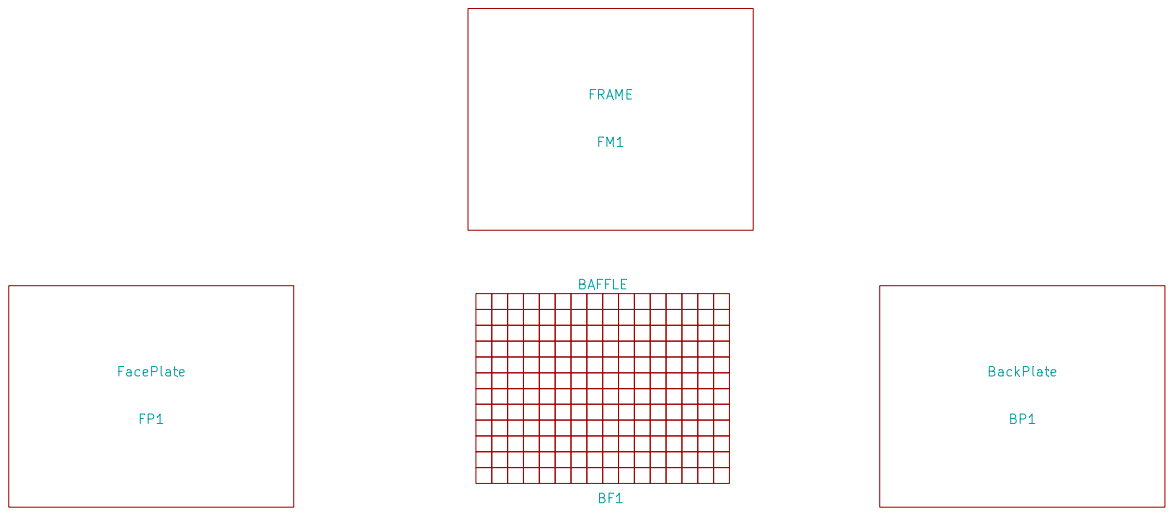
[picture p91: page 3]

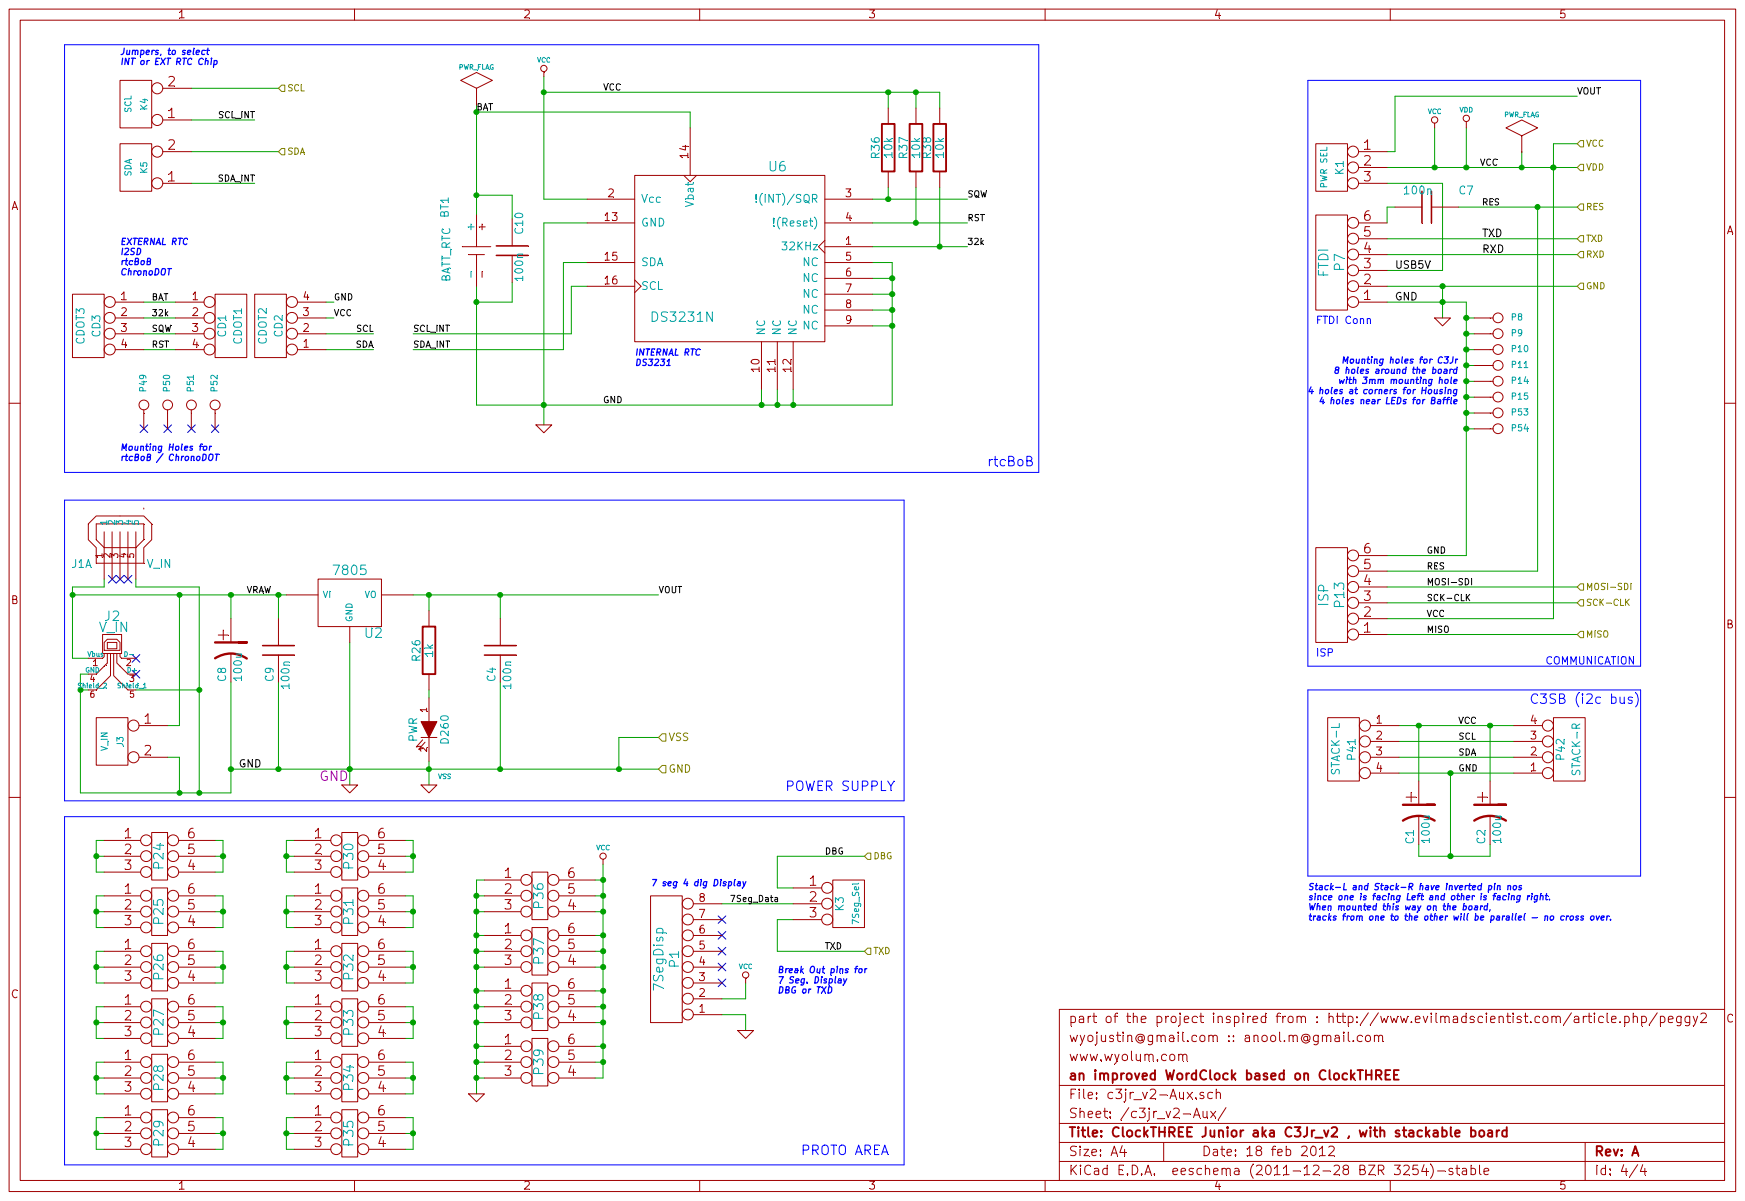
[picture p92: page 4]
