wyolum/ClockTHREEjr/KiCAD/SO24toDIP/SO24toDIP_pdf/SO24toDIP-B.Cu.pdf

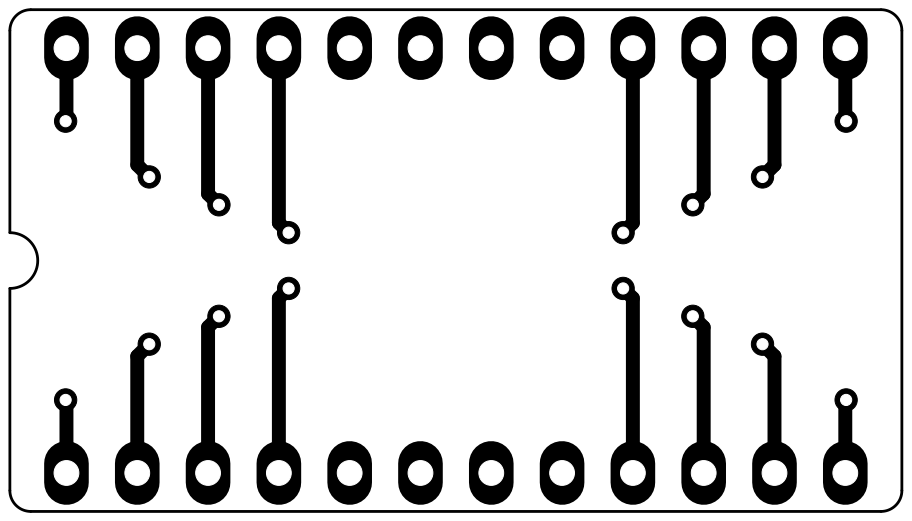
[picture p93: page 1]
