wyolum/ClockTHREEjr/KiCAD/SO24toDIP/SO24toDIP_pdf/SO24toDIP-B.SilkS.pdf

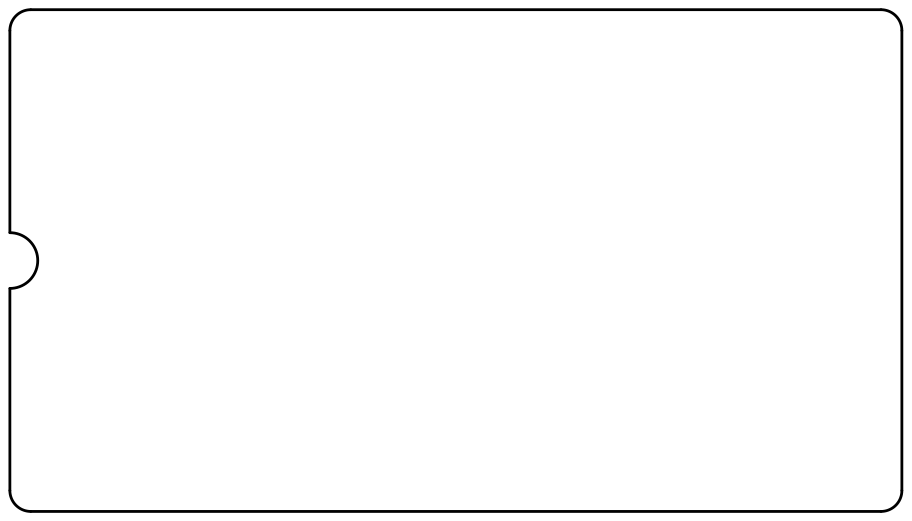
[picture p94: page 1]
