wyolum/ClockTHREEjr/KiCAD/SO24toDIP/SO24toDIP_pdf/SO24toDIP-Dwgs.User.pdf

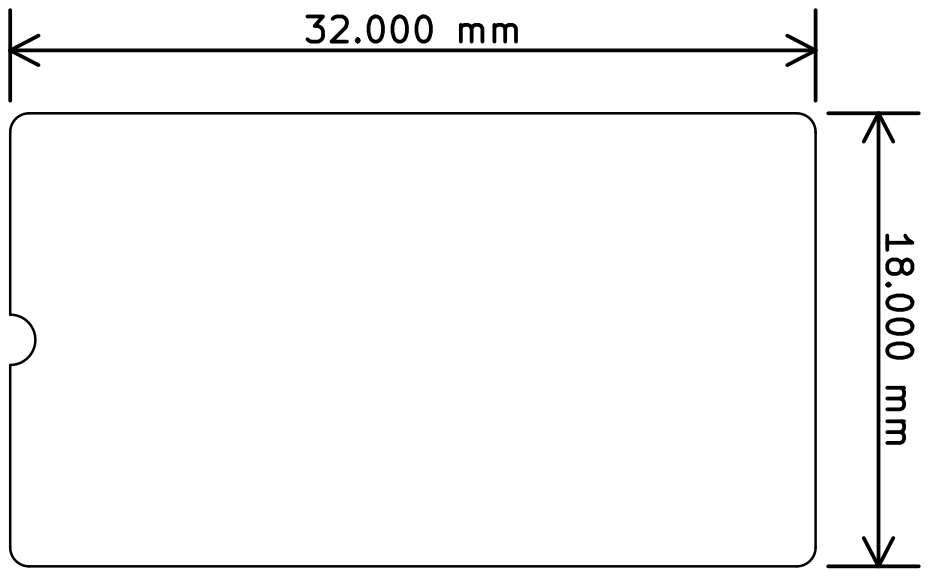
[picture p95: page 1]
