wyolum/ClockTHREEjr/KiCAD/SO24toDIP/SO24toDIP_pdf/SO24toDIP-F.Cu.pdf

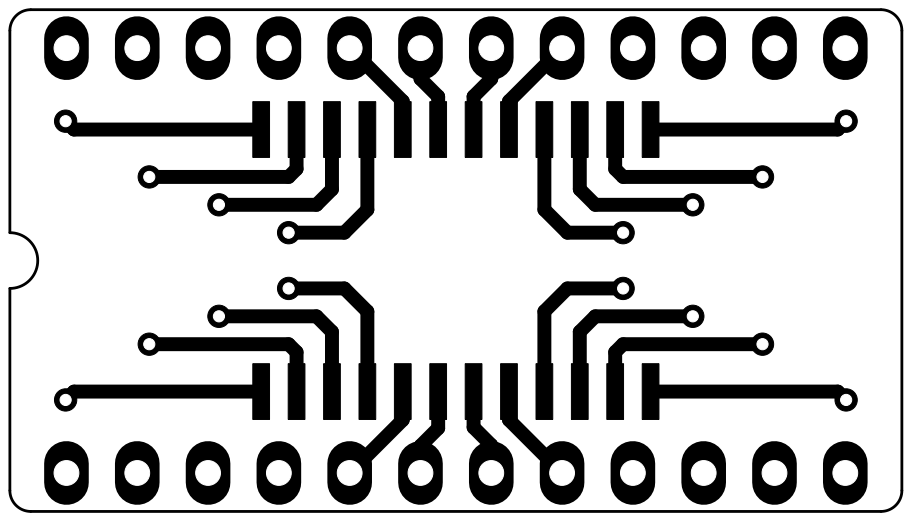
[picture p96: page 1]
