wyolum/ClockTHREEjr/KiCAD/SO24toDIP/SO24toDIP_pdf/SO24toDIP-F.SilkS.pdf

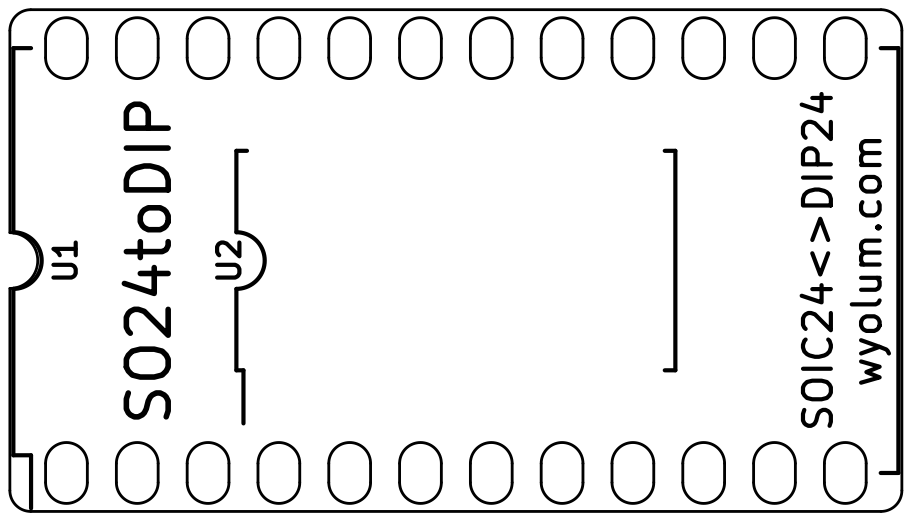
[picture p97: page 1]
