wyolum/ClockTHREEjr/KiCAD/SO24toDIP/SO24toDIP_pdf/SO24toDIP.pdf

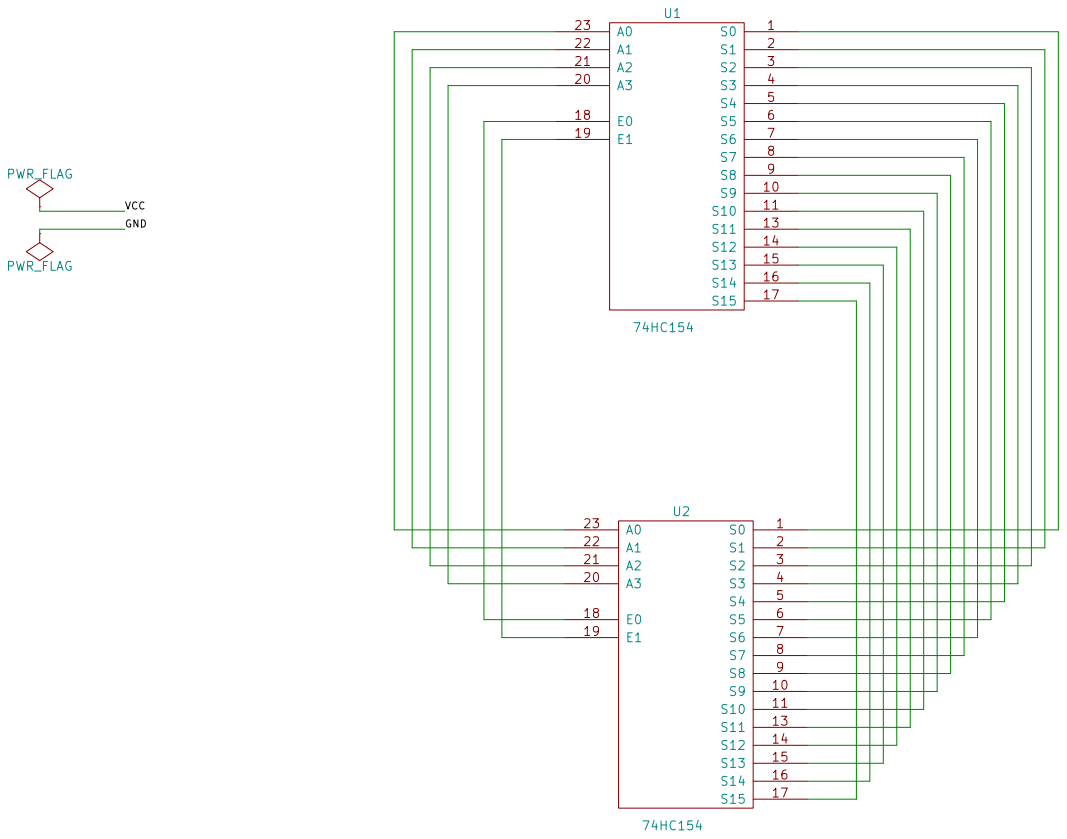
[picture p98: page 1]

Id: 1/1 Title: SOIC 16 to DIP 16 converter File: SO24toDIP.sch Sheet: / WyoLum
