wyolum/ClockTHREEjr/KiCAD/SOIC2DIP/soic2dip_pdf/soic2dip-B_Cu.pdf

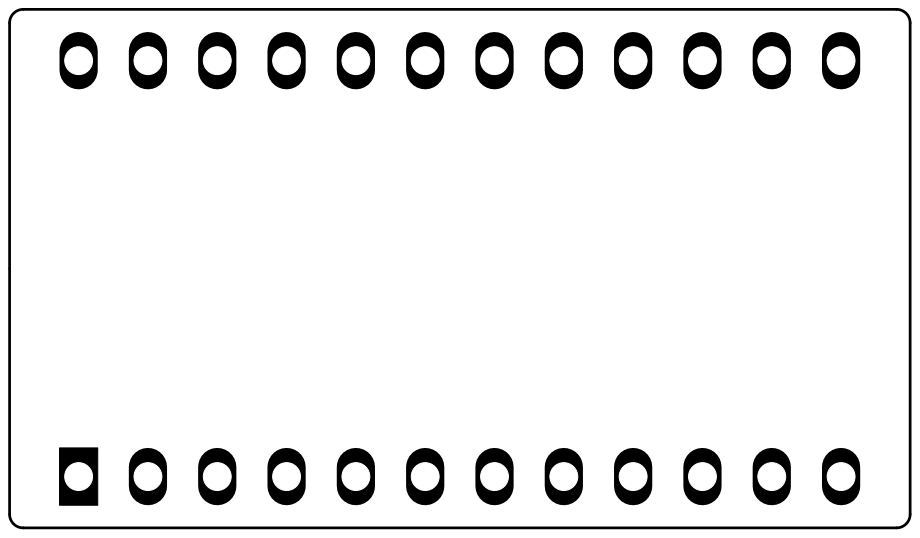
[picture p99: page 1]
