wyolum/ClockTHREEjr/KiCAD/SOIC2DIP/soic2dip_pdf/soic2dip-B_SilkS.pdf

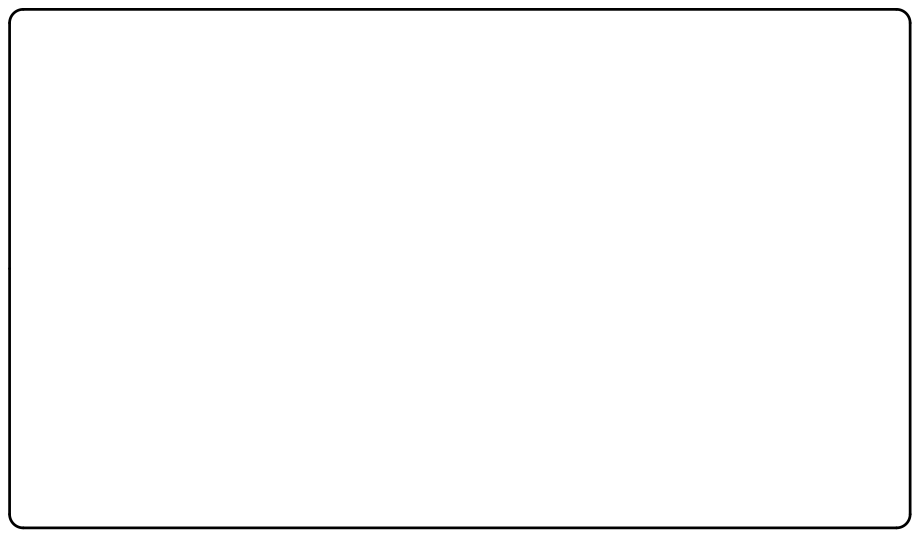
[picture p100: page 1]
