wyolum/ClockTHREEjr/KiCAD/SOIC2DIP/soic2dip_pdf/soic2dip-Dwgs_User.pdf

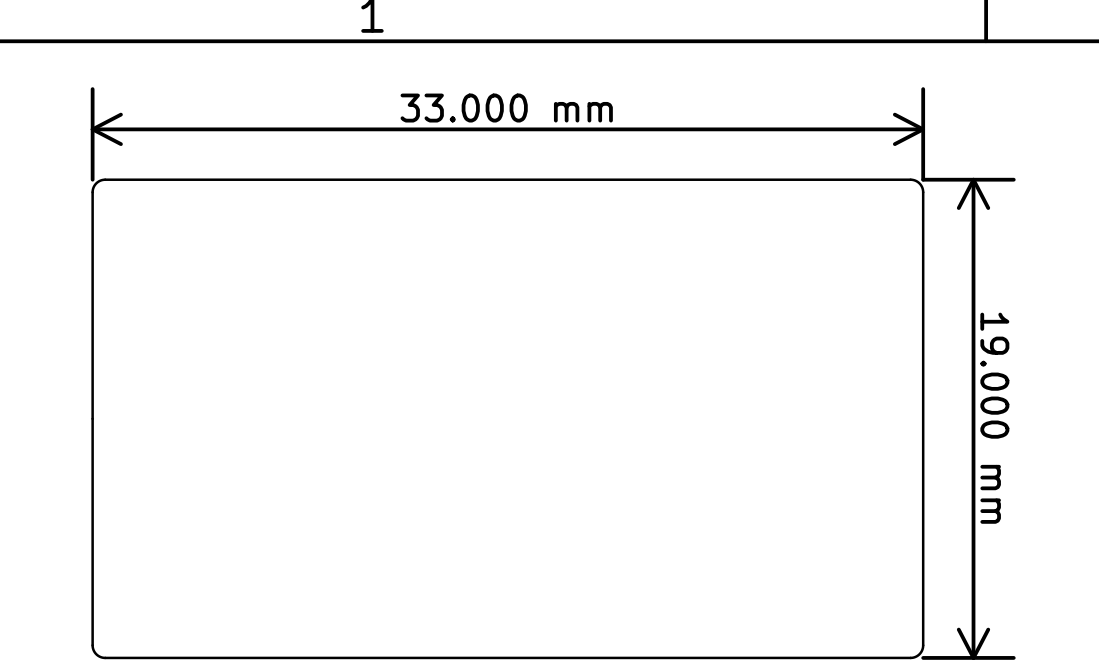
[picture p101: page 1]
