wyolum/ClockTHREEjr/KiCAD/SOIC2DIP/soic2dip_pdf/soic2dip-F_Cu.pdf

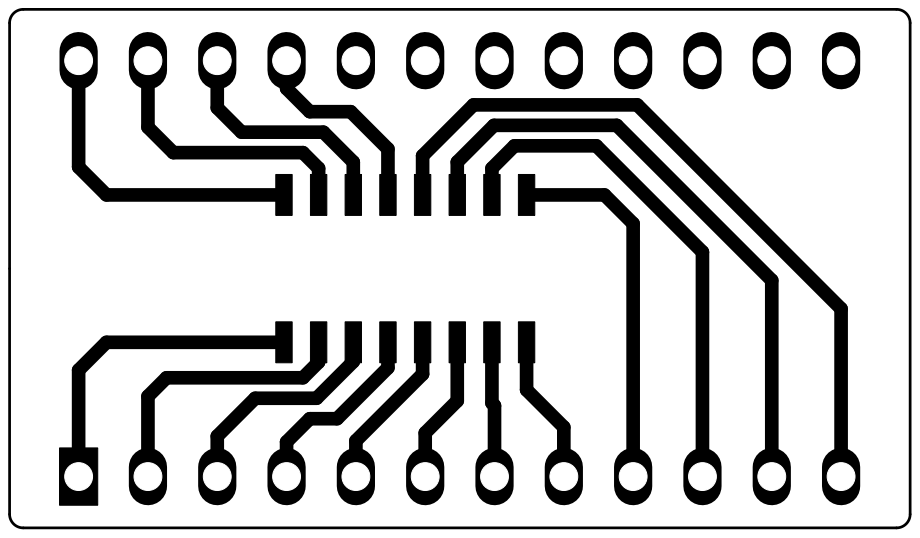
[picture p102: page 1]
