wyolum/ClockTHREEjr/KiCAD/SOIC2DIP/soic2dip_pdf/soic2dip-F_SilkS.pdf

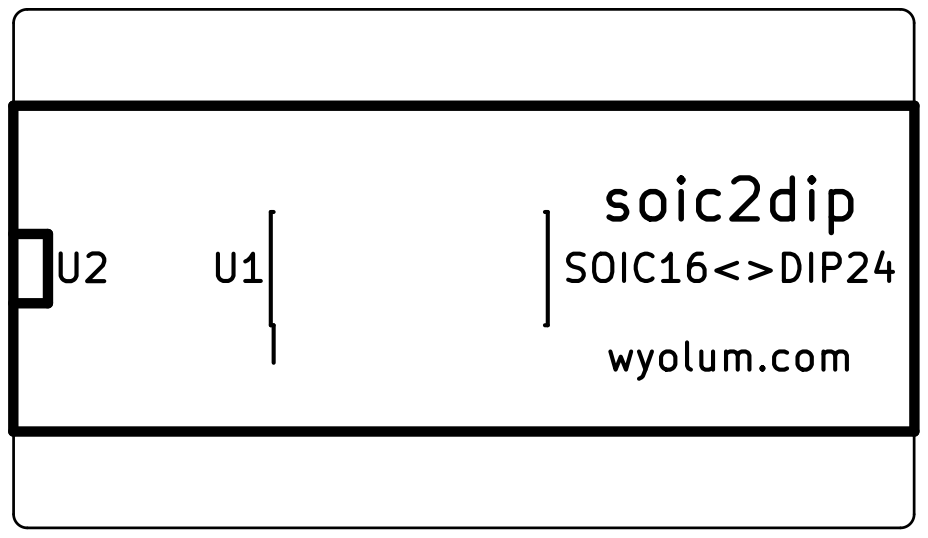
[picture p103: page 1]
