wyolum/ClockTHREEjr/KiCAD/SOIC2DIP/soic2dip_pdf/soic2dip.pdf

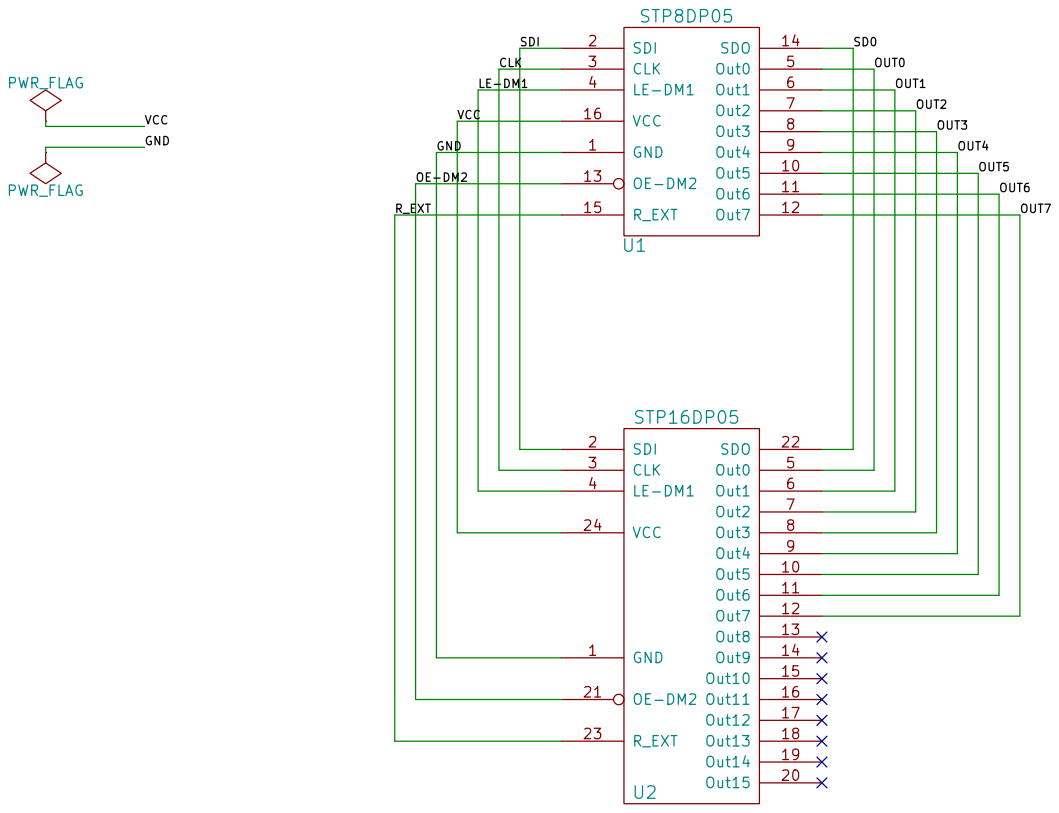
[picture p104: page 1]

File: soic2dip.sch Sheet: / WyoLum

Id: 1/1 Title: SOIC 16 to DIP 16 converter
