wyolum/ClockTHREEjr/(list of files, drawings)

Other design files:
KiCAD/C3Jr_v2/c3jr_v2.dsn
