wyolum/ClockTHREEjr/KiCAD/C3Jr_v2/c3jr_v2-Aux.sch

## KiCad design KiCAD/C3Jr_v2/c3jr_v2-Aux.sch (2018-08-22, an earlier design)

Schematic: c3jr_v2-Aux.sch

Parts:
BT1: BATT_RTC; CR2032
C1, C2, C8: 100u; CP_5x11mm
C4, C7, C9, C10: 100n; C2
CD1: CDOT1; pin_strip_4
CD2: CDOT2; pin_strip_4
CD3: CDOT3; pin_strip_4
D260: PWR; led_5mm_blue
J1: V_IN; con-hirose-UX60-MB-5S8
J2: V_IN; con-usb-USB-B-H
J3: V_IN; JACK_ALIM
K1: PWR SEL; pin_strip_3
K3: 7Seg_Sel
K4: SCL; pin_strip_2
K5: SDA; pin_strip_2
P1: 7SegDisp; pin_strip_8
P7: FTDI; pin_strip_6-90
P8, P9, P10, P11, P14, P15, P53, P54: CONN_1; vite_4mm
P13: ISP; pin_strip_3x2
P24, P25, P26, P27, P28, P29, P30, P31, P32, P33, P34, P35, P36, P37, P38, P39: DIL6; PROTO-6
P41: STACK-L; pin_sck_4-90
P42: STACK-R; pin_strip_4-90
P49, P50, P51, P52: CONN_1; vite_3mm
R26: 1k; RC03
R36, R37, R38: 10k; RC03
U2: 7805
U6: DS3231N; DS3231

Notes on the sheet:
INTERNAL RTC DS3231
EXTERNAL RTC I2SD rtcBoB ChronoDOT
Jumpers, to select INT or EXT RTC Chip
Break Out pins for 7 Seg. Display DBG or TXD
7 seg 4 dig Display
Mounting holes for C3Jr 8 holes around the board with 3mm mounting hole 4 holes at corners for Housing 4 holes near LEDs for Baffle
Mounting Holes for rtcBoB / ChronoDOT
Stack-L and Stack-R have inverted pin nos since one is facing Left and other is facing right. When mounted this way on the board, tracks from one to the other will be parallel - no cross over.
rtcBoB
C3SB (i2c bus)
PROTO AREA
ISP
COMMUNICATION
FTDI Conn
POWER SUPPLY
