wyolum/ClockTHREEjr/KiCAD/C3Jr_v2/c3jr_v2.sch

## KiCad design KiCAD/C3Jr_v2/c3jr_v2.sch (2018-08-22, an earlier design)

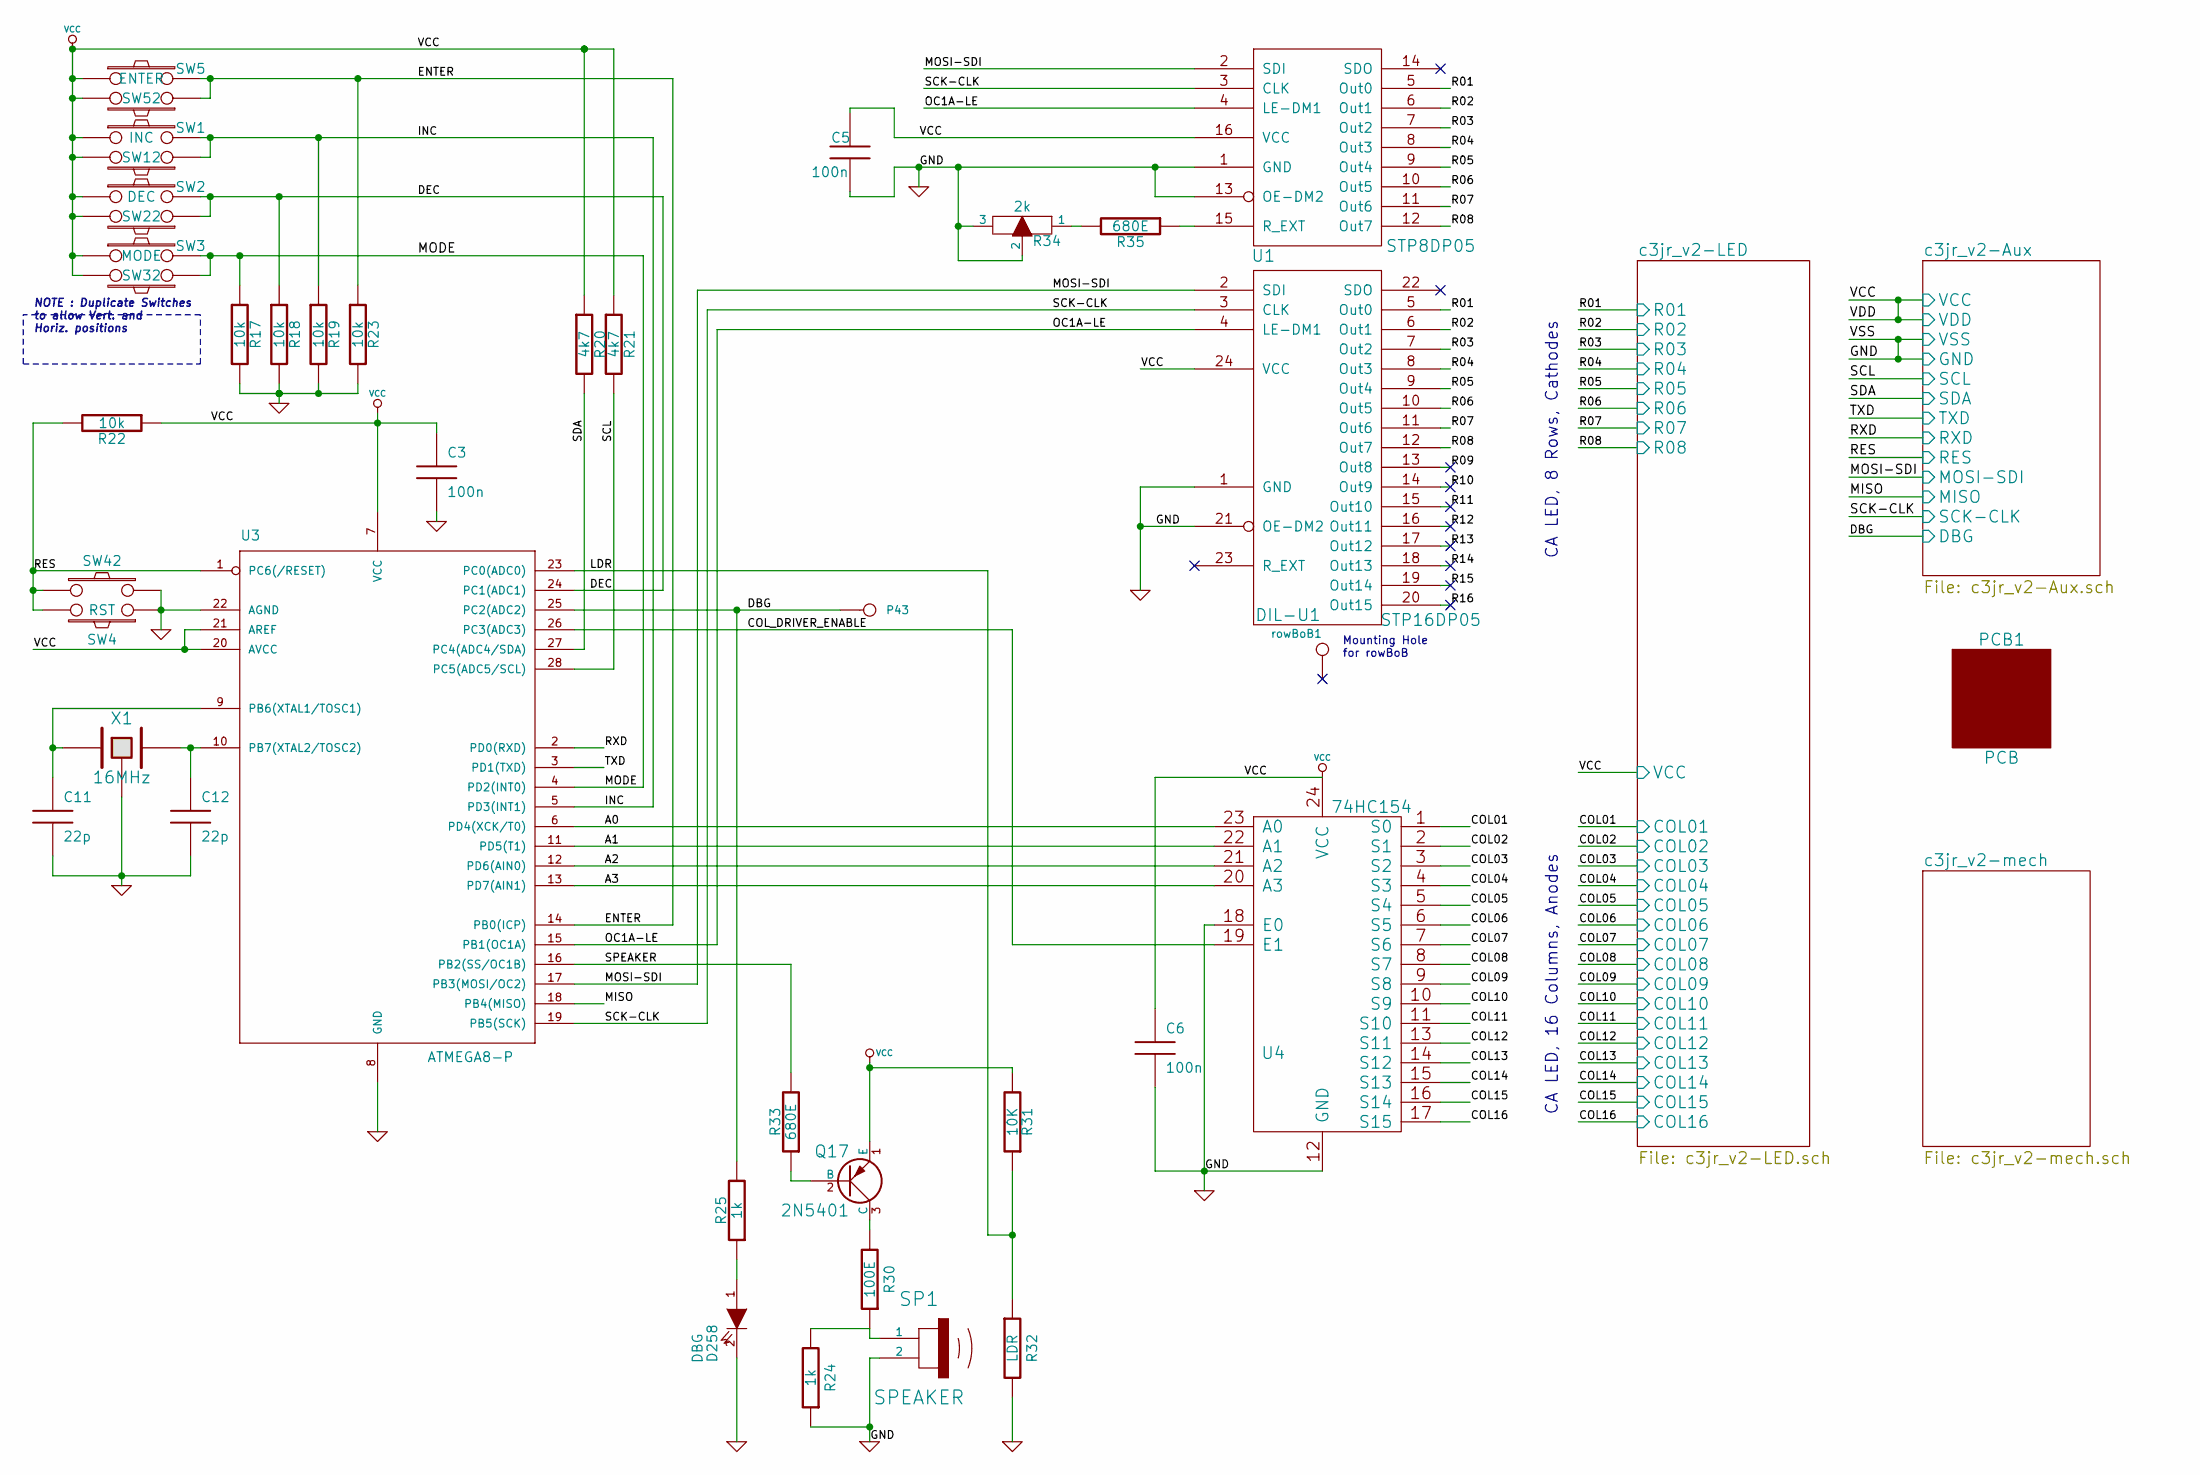
[picture p106: schematic c3jr_v2.sch]

Parts:
C3, C5, C6: 100n; C2
C11, C12: 22p; cnp_3mm_disc
D258: DBG; led_5mm_blue
DIL-U1: STP16DP05; SCK-24_600_ELL; DigiKey 497-5975-1-ND
P43: CONN_1; Pad01
PCB1: PCB
Q17: 2N5401; to92_2N5401; DigiKey 2N5401RLRAGOSCT-ND
R17, R18, R19, R22, R23: 10k; RC03
R20, R21: 4k7; RC03
R24, R25: 1k; RC03
R30: 100E; RC03
R31: 10K; RC03
R32: LDR; pin_strip_2
R33, R35: 680E; RC03
R34: 2k; Pot-Var2
SP1: SPEAKER; Speaker; DigiKey 102-1169-ND
SW1: INC; SW_PB_V; DigiKey P10884S-ND
SW2: DEC; SW_PB_V; DigiKey P10884S-ND
SW3: MODE; SW_PB_V; DigiKey P10884S-ND
SW4: RST; SW_PB_V; DigiKey P10884S-ND
SW5: ENTER; SW_PB_V; DigiKey P10884S-ND
SW12: INC; SW-PB-MOD; DigiKey P10884S-ND
SW22: DEC; SW-PB-MOD; DigiKey P10884S-ND
SW32: MODE; SW-PB-MOD; DigiKey P10884S-ND
SW42: RST; SW-PB-MOD; DigiKey P10884S-ND
SW52: ENTER; SW-PB-MOD; DigiKey P10884S-ND
U1: STP8DP05; dil_16-300_socket
U3: ATMEGA8-P; dil_28-300_socket
U4: 74HC154; DIP-24__600_ELL; DigiKey 296-8757-5-ND
X1: 16MHz; XTAL; DigiKey 490-1214-ND
rowBoB1: CONN_1; vite_3mm

Connections:
A0: U3.6 (PD4(XCK/T0)), U4.23 (A0)
A1: U3.11 (PD5(T1)), U4.22 (A1)
A2: U3.12 (PD6(AIN0)), U4.21 (A2)
A3: U3.13 (PD7(AIN1)), U4.20 (A3)
COL01: U4.1 (S0)
COL02: U4.2 (S1)
COL03: U4.3 (S2)
COL04: U4.4 (S3)
COL05: U4.5 (S4)
COL06: U4.6 (S5)
COL07: U4.7 (S6)
COL08: U4.8 (S7)
COL09: U4.9 (S8)
COL10: U4.10 (S9)
COL11: U4.11 (S10)
COL12: U4.13 (S11)
COL13: U4.14 (S12)
COL14: U4.15 (S13)
COL15: U4.16 (S14)
COL16: U4.17 (S15)
COL_DRIVER_ENABLE: U3.26 (PC3(ADC3)), U4.19 (E1)
DBG: P43.1, R25.2, U3.25 (PC2(ADC2))
DEC: R18.1, SW2.2, SW22.1, U3.24 (PC1(ADC1))
ENTER: R23.1, SW5.2, SW52.1, U3.14 (PB0(ICP))
GND: C3.2, C5.2, C6.2, C11.2, C12.2, D258.2 (K), DIL-U1.1 (GND), DIL-U1.21 (OE-DM2), R17.2, R18.2, R19.2, R23.2, R24.1, R32.2, R34.2, R34.3, SP1.2, SW4.1, SW42.2, U1.1 (GND), U1.13 (OE-DM2), U3.8 (GND), U3.22 (AGND), U4.12 (GND), U4.18 (E0), X1.~ (3)
INC: R19.1, SW1.2, SW12.1, U3.5 (PD3(INT1))
LDR: R31.1, R32.1, U3.23 (PC0(ADC0))
MISO: U3.18 (PB4(MISO))
MODE: R17.1, SW3.2, SW32.1, U3.4 (PD2(INT0))
MOSI-SDI: DIL-U1.2 (SDI), U1.2 (SDI), U3.17 (PB3(MOSI/OC2))
unnamed: C11.1, U3.9 (PB6(XTAL1/TOSC1)), X1.1
unnamed: C12.1, U3.10 (PB7(XTAL2/TOSC2)), X1.2
unnamed: D258.1 (A), R25.1
unnamed: Q17.2 (B), R33.1
unnamed: Q17.3 (C), R30.2
unnamed: R24.2, R30.1, SP1.1
unnamed: R34.1, R35.2
unnamed: R35.1, U1.15 (R_EXT)
OC1A-LE: DIL-U1.4 (LE-DM1), U1.4 (LE-DM1), U3.15 (PB1(OC1A))
R01: DIL-U1.5 (Out0), U1.5 (Out0)
R02: DIL-U1.6 (Out1), U1.6 (Out1)
R03: DIL-U1.7 (Out2), U1.7 (Out2)
R04: DIL-U1.8 (Out3), U1.8 (Out3)
R05: DIL-U1.9 (Out4), U1.9 (Out4)
R06: DIL-U1.10 (Out5), U1.10 (Out5)
R07: DIL-U1.11 (Out6), U1.11 (Out6)
R08: DIL-U1.12 (Out7), U1.12 (Out7)
R09: DIL-U1.13 (Out8)
R10: DIL-U1.14 (Out9)
R11: DIL-U1.15 (Out10)
R12: DIL-U1.16 (Out11)
R13: DIL-U1.17 (Out12)
R14: DIL-U1.18 (Out13)
R15: DIL-U1.19 (Out14)
R16: DIL-U1.20 (Out15)
RES: R22.2, SW4.2, SW42.1, U3.1 (PC6(/RESET))
RXD: U3.2 (PD0(RXD))
SCK-CLK: DIL-U1.3 (CLK), U1.3 (CLK), U3.19 (PB5(SCK))
SCL: R21.2, U3.28 (PC5(ADC5/SCL))
SDA: R20.2, U3.27 (PC4(ADC4/SDA))
SPEAKER: R33.2, U3.16 (PB2(SS/OC1B))
TXD: U3.3 (PD1(TXD))
VCC: C3.1, C5.1, C6.1, DIL-U1.24 (VCC), Q17.1 (E), R20.1, R21.1, R22.1, R31.2, SW1.1, SW2.1, SW3.1, SW5.1, SW12.2, SW22.2, SW32.2, SW52.2, U1.16 (VCC), U3.7 (VCC), U3.20 (AVCC), U3.21 (AREF), U4.24 (VCC)

Notes on the sheet:
NOTE : Duplicate Switches to allow Vert. and Horiz. positions
Mounting Hole for rowBoB
CA LED, 16 Columns, Anodes
CA LED, 8 Rows, Cathodes
