wyolum/ClockTHREEjr/KiCAD/SO24toDIP/SO24toDIP.sch

## KiCad design KiCAD/SO24toDIP/SO24toDIP.sch (2016-05-13)

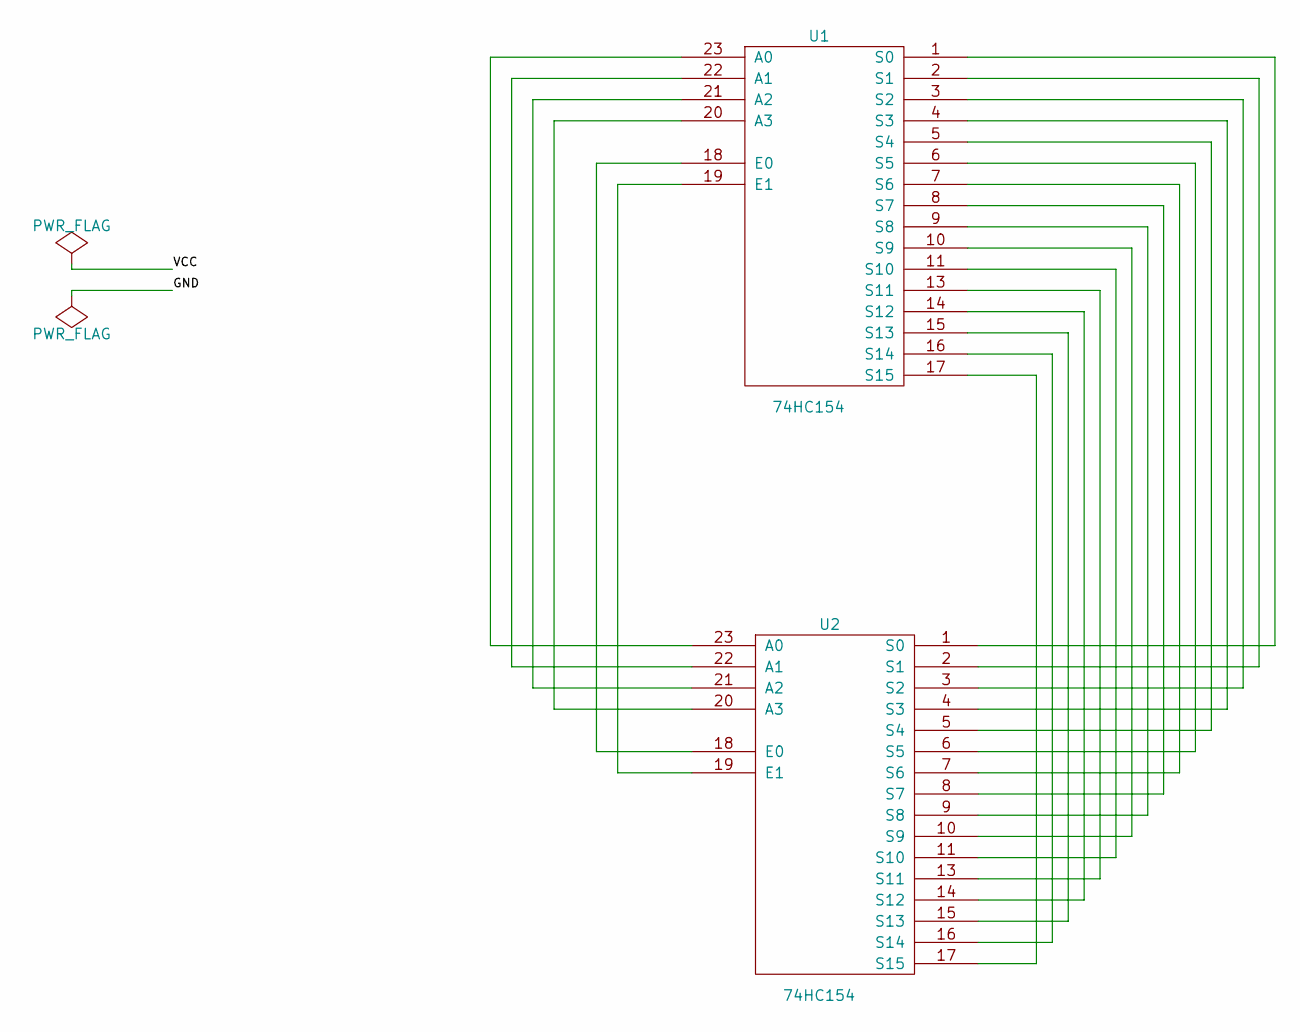
[picture p107: schematic SO24toDIP.sch]

Parts:
U1: 74HC154; DIP-24_W15.24mm_LongPads
U2: 74HC154; SOIC-24_7.5x15.4mm_Pitch1.27mm

Connections:
unnamed: U1.1 (S0), U2.1 (S0)
unnamed: U1.2 (S1), U2.2 (S1)
unnamed: U1.3 (S2), U2.3 (S2)
unnamed: U1.4 (S3), U2.4 (S3)
unnamed: U1.5 (S4), U2.5 (S4)
unnamed: U1.6 (S5), U2.6 (S5)
unnamed: U1.7 (S6), U2.7 (S6)
unnamed: U1.8 (S7), U2.8 (S7)
unnamed: U1.9 (S8), U2.9 (S8)
unnamed: U1.10 (S9), U2.10 (S9)
unnamed: U1.11 (S10), U2.11 (S10)
unnamed: U1.13 (S11), U2.13 (S11)
unnamed: U1.14 (S12), U2.14 (S12)
unnamed: U1.15 (S13), U2.15 (S13)
unnamed: U1.16 (S14), U2.16 (S14)
unnamed: U1.17 (S15), U2.17 (S15)
unnamed: U1.18 (E0), U2.18 (E0)
unnamed: U1.19 (E1), U2.19 (E1)
unnamed: U1.20 (A3), U2.20 (A3)
unnamed: U1.21 (A2), U2.21 (A2)
unnamed: U1.22 (A1), U2.22 (A1)
unnamed: U1.23 (A0), U2.23 (A0)
