wyolum/ClockTHREEjr/KiCAD/C3Jr_v2/c3jr_v2-LED.sch

## KiCad design KiCAD/C3Jr_v2/c3jr_v2-LED.sch (2018-08-22, an earlier design)


Parts:
D1, D2, D3, D4, D5, D6, D7, D8, D9, D10, D11, D12, D13, D14, D15, D16, D17, D18, D19, D20, D21, D22, D23, D24, D25, D26, D27, D28, D29, D30, D31, D32, D33, D34, D35, D36, D37, D38, D39, D40, D41, D42, D43, D44, D45, D46, D47, D48, D49, D50, D51, D52, D53, D54, D55, D56, D57, D58, D59, D60, D61, D62, D63, D64, D65, D66, D67, D68, D69, D70, D71, D72, D73, D74, D75, D76, D77, D78, D79, D80, D81, D82, D83, D84, D85, D86, D87, D88, D89, D90, D91, D92, D93, D94, D95, D96, D97, D98, D99, D100, D101, D102, D103, D104, D105, D106, D107, D108, D109, D110, D111, D112, D113, D114, D115, D116, D117, D118, D119, D120, D121, D122, D123, D124, D125, D126, D127, D128: LED; led_5mm_clear
K2: LED_ENABLE; pin_strip_3
Q1, Q2, Q3, Q4, Q5, Q6, Q7, Q8, Q9, Q10, Q11, Q12, Q13, Q14, Q15, Q16: 2N5401; to92_2N5401
R1, R2, R3, R4, R5, R6, R7, R8, R9, R10, R11, R12, R13, R14, R15, R16: 100; rc03_vert

Connections:
C01: D16.1 (A), D32.1 (A), D48.1 (A), D64.1 (A), D80.1 (A), D96.1 (A), D112.1 (A), D128.1 (A), Q1.3 (C)
C02: D15.1 (A), D31.1 (A), D47.1 (A), D63.1 (A), D79.1 (A), D95.1 (A), D111.1 (A), D127.1 (A), Q2.3 (C)
C03: D14.1 (A), D30.1 (A), D46.1 (A), D62.1 (A), D78.1 (A), D94.1 (A), D110.1 (A), D126.1 (A), Q3.3 (C)
C04: D13.1 (A), D29.1 (A), D45.1 (A), D61.1 (A), D77.1 (A), D93.1 (A), D109.1 (A), D125.1 (A), Q4.3 (C)
C05: D12.1 (A), D28.1 (A), D44.1 (A), D60.1 (A), D76.1 (A), D92.1 (A), D108.1 (A), D124.1 (A), Q5.3 (C)
C06: D11.1 (A), D27.1 (A), D43.1 (A), D59.1 (A), D75.1 (A), D91.1 (A), D107.1 (A), D123.1 (A), Q6.3 (C)
C07: D10.1 (A), D26.1 (A), D42.1 (A), D58.1 (A), D74.1 (A), D90.1 (A), D106.1 (A), D122.1 (A), Q7.3 (C)
C08: D9.1 (A), D25.1 (A), D41.1 (A), D57.1 (A), D73.1 (A), D89.1 (A), D105.1 (A), D121.1 (A), Q8.3 (C)
C09: D8.1 (A), D24.1 (A), D40.1 (A), D56.1 (A), D72.1 (A), D88.1 (A), D104.1 (A), D120.1 (A), Q9.3 (C)
C10: D7.1 (A), D23.1 (A), D39.1 (A), D55.1 (A), D71.1 (A), D87.1 (A), D103.1 (A), D119.1 (A), Q10.3 (C)
C11: D6.1 (A), D22.1 (A), D38.1 (A), D54.1 (A), D70.1 (A), D86.1 (A), D102.1 (A), D118.1 (A), Q11.3 (C)
C12: D5.1 (A), D21.1 (A), D37.1 (A), D53.1 (A), D69.1 (A), D85.1 (A), D101.1 (A), D117.1 (A), Q12.3 (C)
C13: D4.1 (A), D20.1 (A), D36.1 (A), D52.1 (A), D68.1 (A), D84.1 (A), D100.1 (A), D116.1 (A), Q13.3 (C)
C14: D3.1 (A), D19.1 (A), D35.1 (A), D51.1 (A), D67.1 (A), D83.1 (A), D99.1 (A), D115.1 (A), Q14.3 (C)
C15: D2.1 (A), D18.1 (A), D34.1 (A), D50.1 (A), D66.1 (A), D82.1 (A), D98.1 (A), D114.1 (A), Q15.3 (C)
C16: D1.1 (A), D17.1 (A), D33.1 (A), D49.1 (A), D65.1 (A), D81.1 (A), D97.1 (A), D113.1 (A), Q16.3 (C)
COL01: R1.1
COL02: R2.1
COL03: R3.1
COL04: R4.1
COL05: R5.1
COL06: R6.1
COL07: R7.1
COL08: R8.1
COL09: R9.1
COL10: R10.1
COL11: R11.1
COL12: R12.1
COL13: R13.1
COL14: R14.1
COL15: R15.1
COL16: R16.1
unnamed: K2.2 (PM), Q1.1 (E), Q2.1 (E), Q3.1 (E), Q4.1 (E), Q5.1 (E), Q6.1 (E), Q7.1 (E), Q8.1 (E), Q9.1 (E), Q10.1 (E), Q11.1 (E), Q12.1 (E), Q13.1 (E), Q14.1 (E), Q15.1 (E), Q16.1 (E)
unnamed: Q1.2 (B), R1.2
unnamed: Q2.2 (B), R2.2
unnamed: Q3.2 (B), R3.2
unnamed: Q4.2 (B), R4.2
unnamed: Q5.2 (B), R5.2
unnamed: Q6.2 (B), R6.2
unnamed: Q7.2 (B), R7.2
unnamed: Q8.2 (B), R8.2
unnamed: Q9.2 (B), R9.2
unnamed: Q10.2 (B), R10.2
unnamed: Q11.2 (B), R11.2
unnamed: Q12.2 (B), R12.2
unnamed: Q13.2 (B), R13.2
unnamed: Q14.2 (B), R14.2
unnamed: Q15.2 (B), R15.2
unnamed: Q16.2 (B), R16.2
R01: D1.2 (K), D2.2 (K), D3.2 (K), D4.2 (K), D5.2 (K), D6.2 (K), D7.2 (K), D8.2 (K), D9.2 (K), D10.2 (K), D11.2 (K), D12.2 (K), D13.2 (K), D14.2 (K), D15.2 (K), D16.2 (K)
R02: D17.2 (K), D18.2 (K), D19.2 (K), D20.2 (K), D21.2 (K), D22.2 (K), D23.2 (K), D24.2 (K), D25.2 (K), D26.2 (K), D27.2 (K), D28.2 (K), D29.2 (K), D30.2 (K), D31.2 (K), D32.2 (K)
R03: D33.2 (K), D34.2 (K), D35.2 (K), D36.2 (K), D37.2 (K), D38.2 (K), D39.2 (K), D40.2 (K), D41.2 (K), D42.2 (K), D43.2 (K), D44.2 (K), D45.2 (K), D46.2 (K), D47.2 (K), D48.2 (K)
R04: D49.2 (K), D50.2 (K), D51.2 (K), D52.2 (K), D53.2 (K), D54.2 (K), D55.2 (K), D56.2 (K), D57.2 (K), D58.2 (K), D59.2 (K), D60.2 (K), D61.2 (K), D62.2 (K), D63.2 (K), D64.2 (K)
R05: D65.2 (K), D66.2 (K), D67.2 (K), D68.2 (K), D69.2 (K), D70.2 (K), D71.2 (K), D72.2 (K), D73.2 (K), D74.2 (K), D75.2 (K), D76.2 (K), D77.2 (K), D78.2 (K), D79.2 (K), D80.2 (K)
R06: D81.2 (K), D82.2 (K), D83.2 (K), D84.2 (K), D85.2 (K), D86.2 (K), D87.2 (K), D88.2 (K), D89.2 (K), D90.2 (K), D91.2 (K), D92.2 (K), D93.2 (K), D94.2 (K), D95.2 (K), D96.2 (K)
R07: D97.2 (K), D98.2 (K), D99.2 (K), D100.2 (K), D101.2 (K), D102.2 (K), D103.2 (K), D104.2 (K), D105.2 (K), D106.2 (K), D107.2 (K), D108.2 (K), D109.2 (K), D110.2 (K), D111.2 (K), D112.2 (K)
R08: D113.2 (K), D114.2 (K), D115.2 (K), D116.2 (K), D117.2 (K), D118.2 (K), D119.2 (K), D120.2 (K), D121.2 (K), D122.2 (K), D123.2 (K), D124.2 (K), D125.2 (K), D126.2 (K), D127.2 (K), D128.2 (K)
VCC: K2.1
