wyolum/ClockTHREEjr/KiCAD/C3Jr_v2/c3jr_v2-mech.sch

## KiCad design KiCAD/C3Jr_v2/c3jr_v2-mech.sch (2018-08-22, an earlier design)

Schematic: c3jr_v2-mech.sch

Parts:
BF1: BAFFLE; Baffle
BP1: BackPlate
FM1: FRAME; Frame
FP1: FacePlate
