wyolum/ClockTHREEjr/KiCAD/SO24toDIP/SO24toDIP.sch

## KiCad design KiCAD/SO24toDIP/SO24toDIP.sch (2016-05-13, an earlier design)


Parts:
U1: STP8DP05; SOIC-16_3.9x9.9mm_Pitch1.27mm
U2: STP16DP05; DIP-24_600_ELL

Connections:
CLK: U1.3 (CLK), U2.3 (CLK)
GND: U1.1 (GND), U2.1 (GND)
LE-DM1: U1.4 (LE-DM1), U2.4 (LE-DM1)
OE-DM2: U1.13 (OE-DM2), U2.21 (OE-DM2)
OUT0: U1.5 (Out0), U2.5 (Out0)
OUT1: U1.6 (Out1), U2.6 (Out1)
OUT2: U1.7 (Out2), U2.7 (Out2)
OUT3: U1.8 (Out3), U2.8 (Out3)
OUT4: U1.9 (Out4), U2.9 (Out4)
OUT5: U1.10 (Out5), U2.10 (Out5)
OUT6: U1.11 (Out6), U2.11 (Out6)
OUT7: U1.12 (Out7), U2.12 (Out7)
R_EXT: U1.15 (R_EXT), U2.23 (R_EXT)
SD0: U1.14 (SDO), U2.22 (SDO)
SDI: U1.2 (SDI), U2.2 (SDI)
VCC: U1.16 (VCC), U2.24 (VCC)
