wyolum/ClockTHREEjr/(commit log)

2014-03-08 moved to stand alone repo with correct directory structure
    [$savepcb.brd, c3jr_v2-Aux.sch, c3jr_v2-LED.sch, c3jr_v2-mech.sch, c3jr_v2.brd, c3jr_v2.dsn, c3jr_v2.sch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]
2014-03-30 added files for making faceplates
    [ClockTHREEjr Faceplate Layouts Vol II - Spanish_v1.csv, ClockTHREEjr faceplate layouts - Dutch v1.csv, Dutch_v1.csv, English1Landscape_v1_TiM.csv, English1_v1_TiM.csv, English1_v2_TiM.csv, English2_v1_TiM.csv, English_v0.csv]
2014-03-31 minute hand bore hole expanded
2014-09-24 C3jr verified all files compile in current Arduino version
2015-07-29 soic 16 to dip 24 breakout board for STP08DP05
    [$savepcb.brd, ClockTHREEjr Faceplate Layouts Vol II - Spanish_v1.csv, ClockTHREEjr faceplate layouts - Dutch v1.csv, Dutch_v1.csv, English1Landscape_v1_TiM.csv, English1_v1_TiM.csv, English1_v2_TiM.csv, English2_v1_TiM.csv]
2015-08-12 replaced STP08DP05 with TI TLC5916 in BOM
    [c3jr_v2_BoM_seeed.ods]
2016-05-13 SO24 to DIP converter for 74HC154, in progress
    [SO24toDIP.kicad_pcb, SO24toDIP.sch, SO24toDIP_BoM_sch.csv]
2016-05-13 added 24-SOIC to 24-DIP breakout board for 74HC154
    [SO24toDIP-B.Cu.gbl, SO24toDIP-B.Mask.gbs, SO24toDIP-B.Paste.gbp, SO24toDIP-B.SilkS.gbo, SO24toDIP-Edge.Cuts.gm1, SO24toDIP-F.Cu.gtl, SO24toDIP-F.Mask.gts, SO24toDIP-F.Paste.gtp]
2016-07-19 Made changes for Arduino 1.6.9
2017-12-22 debugging phatom LEDs
2017-12-22 added column-shuffle to mitigate led ghosting
2018-08-22 kicad cleanup
    [c3jr_v2-2018-08-22-19-50-55.sch, c3jr_v2-Aux-2018-08-22-19-50-55.sch, c3jr_v2-Aux.sch, c3jr_v2-LED-2018-08-22-19-50-55.sch, c3jr_v2-LED.sch, c3jr_v2-mech-2018-08-22-19-50-55.sch, c3jr_v2-mech.sch, c3jr_v2.sch]
